Triyanpal/HYROE/Images/Development/pressure_testing.png

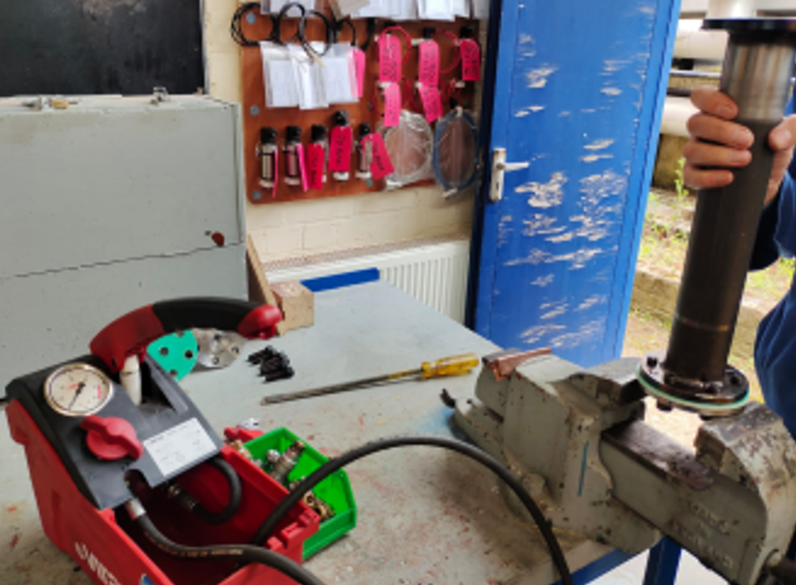
Images/Development/pressure_testing.png
