Triyanpal/HYROE/Images/Testing/Picture11.png

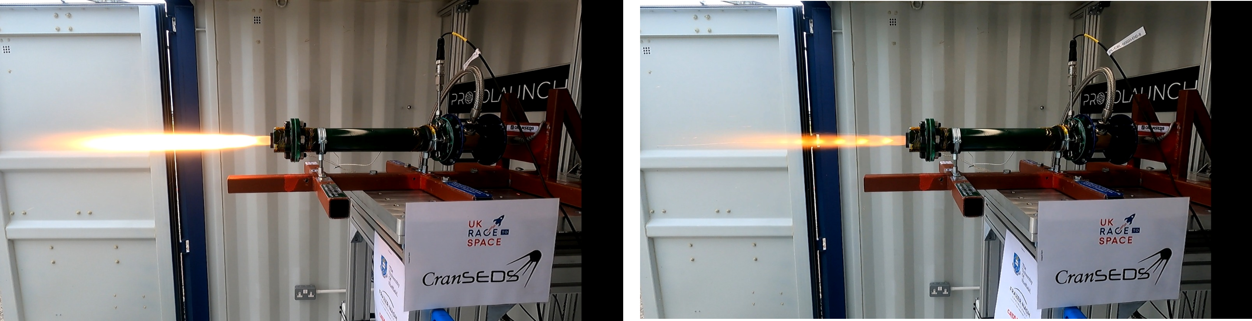
Images/Testing/Picture11.png
