Triyanpal/HYROE/README.md

# HYROE
Hybrid rocket engine research repository

Author: Triyan Pal Arora

Team: CranSEDS HRMTS, Cranfield

The current repository contains simulations, designs, development and results files for the research work undertaken under the Race to Space UK hybrid rocket engine development national engineering competition.

The folders are subdivided into separate segments for ease of navigation.

Please do refer to the conference paper published on the research and findings from the project here: 

Drop a message if any clarifications are required.
Thanks, and KR.
