Triyanpal/HYROE/Documentation/CRANSEDS HYBRID ENGINE DOCUMENTATION.pdf

## CRANSEDS HYBRID ENGINE DOCUMENTATION

### 30 JUNE 2023

### 1. Structure

Test structure of last year - Inspected for cracks or failure points - none detected.

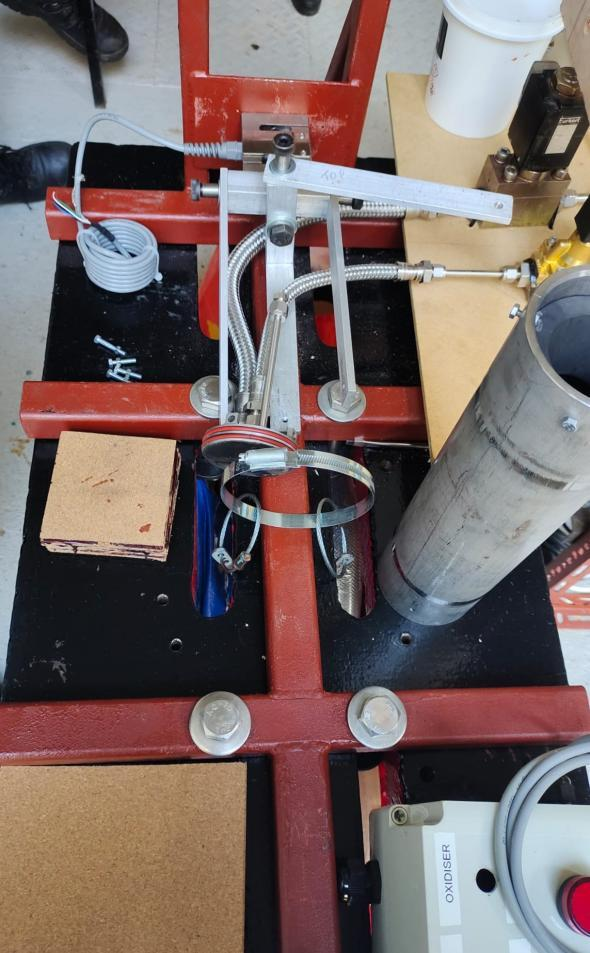
[picture p3: figure]

Initially assembled structure

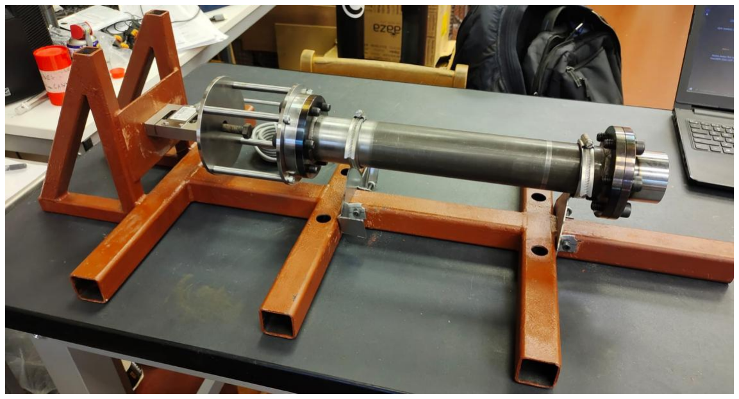
[picture p4: figure]

Materials:
Components (already procured, manufactured, and assembled in structure) | Material
Test Stand base | Mild Steel
Thruster assembly back plate | Mild Steel
Thruster assembly front plate | Mild Steel
Thruster assembly connector | Mild Steel
Injector plate | Mild Steel
Injector flange | Mild Steel
Side flanges | Mild Steel
Combustion chamber | Mild Steel
Nozzle casing | Mild Steel
C-D Nozzle | Graphite
Support fixtures | Zinc plated steel
Bolts | Steel Grade A2 and Grade M8.8
Radial and Axial O rings | Nitrile
Gasket sheet | Aramid fibers, bonded with NBR
Fuel Insulation liner | High density cork liner
Resin and hardener for liner | Aerodux 185 resorcinol phenol liquid resin and HRP155 hardener
Ignition wire | Nichrome wire AWG 28

Metal and plastic machining of structural components performed by manufacturing shop of test facility, Cranfield University, every part and engineering drawing supervised by David Thompson. Attachments:

a. Mild Steel certification sheet
b. Graphite data sheet
c. Ring clamp certification sheet
d. Gasket certifications
e. O rings data sheet
f. Cork liner data sheet
g. Liner resin and hardener data sheet

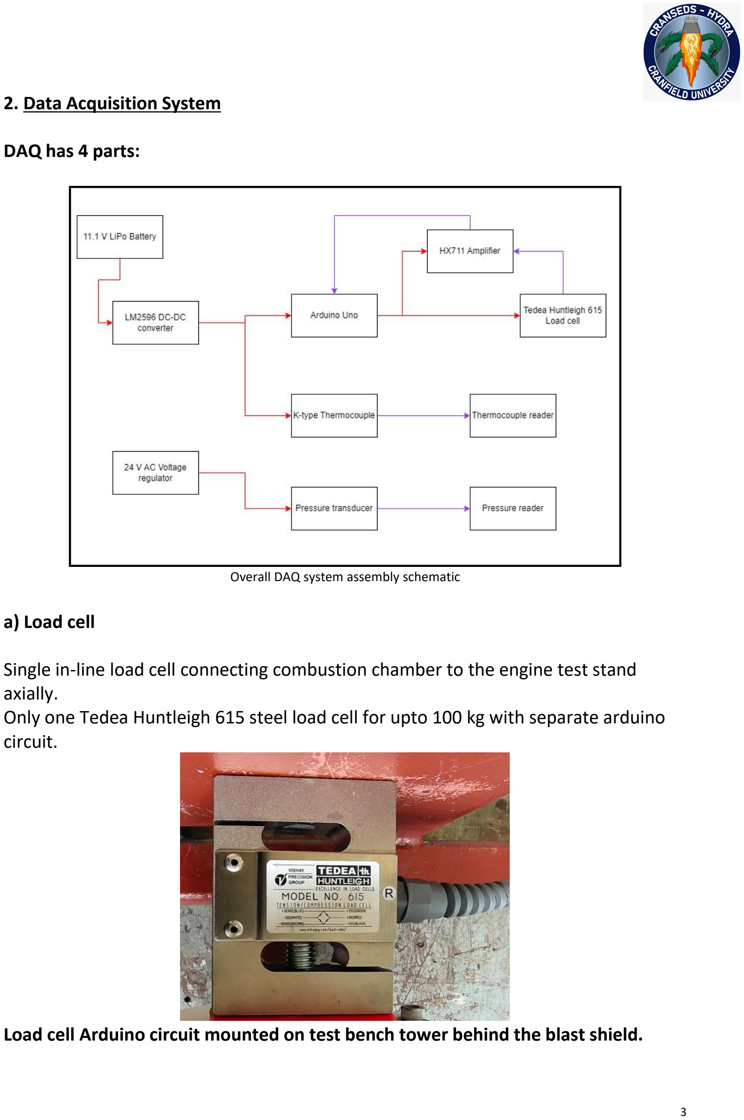
[picture p5: page 3]

### 2. Data Acquisition System

DAQ has 4 parts:

Overall DAQ system assembly schematic
a) Load cell

Single in-line load cell connecting combustion chamber to the engine test stand axially. Only one Tedea Huntleigh 615 steel load cell for upto 100 kg with separate arduino

circuit.

Load cell Arduino circuit mounted on test bench tower behind the blast shield.

b) Thermocouples
Five K-type thermocouples used (3 on combustion chamber, 2 on nozzle casing). Connected with heat measurement units at the test facility.

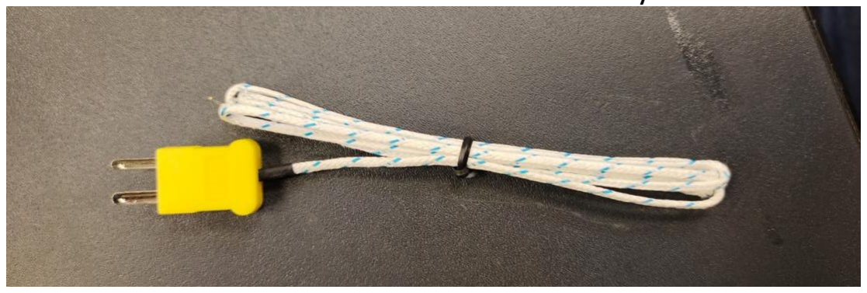
[picture p6: figure]

RS 206-3722 thermocouple reader will be used at least 3 m apart from the engine test bench. c) Pressure transducer

Pressure transducer PX119 1.5 KGI used (8-32 V, 4-20 mA), 2 pin configuration (will be tested today (30 Jue 2023)). Connected with NI LabView adapter for measurement of the results. Pressure transducer is measuring the internal combustion chamber pressure. The

cross section of the chamber for connecting the transducer is depcited in the figure below

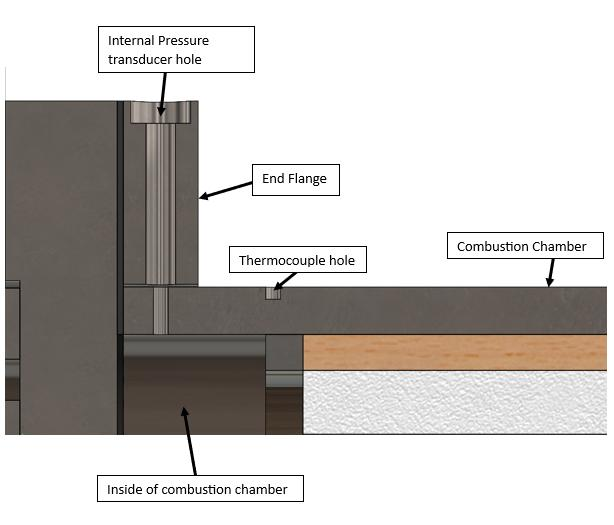
[picture p7: figure]

Pressure transducer logger will be at least 3 m away from the engine test bench.

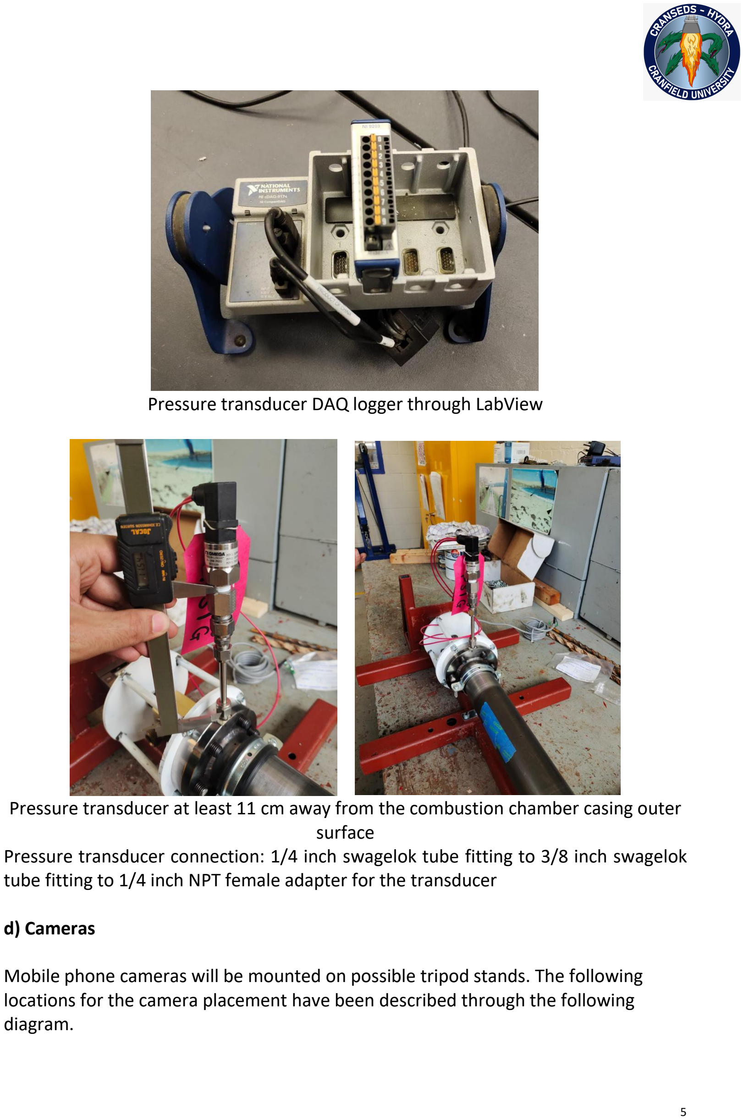
[picture p8: page 5]

Pressure transducer DAQ logger through LabView

Pressure transducer at least 11 cm away from the combustion chamber casing outer surface
Pressure transducer connection: 1/4 inch swagelok tube fitting to 3/8 inch swagelok tube fitting to 1/4 inch NPT female adapter for the transducer
d) Cameras

Mobile phone cameras will be mounted on possible tripod stands. The following locations for the camera placement have been described through the following diagram.

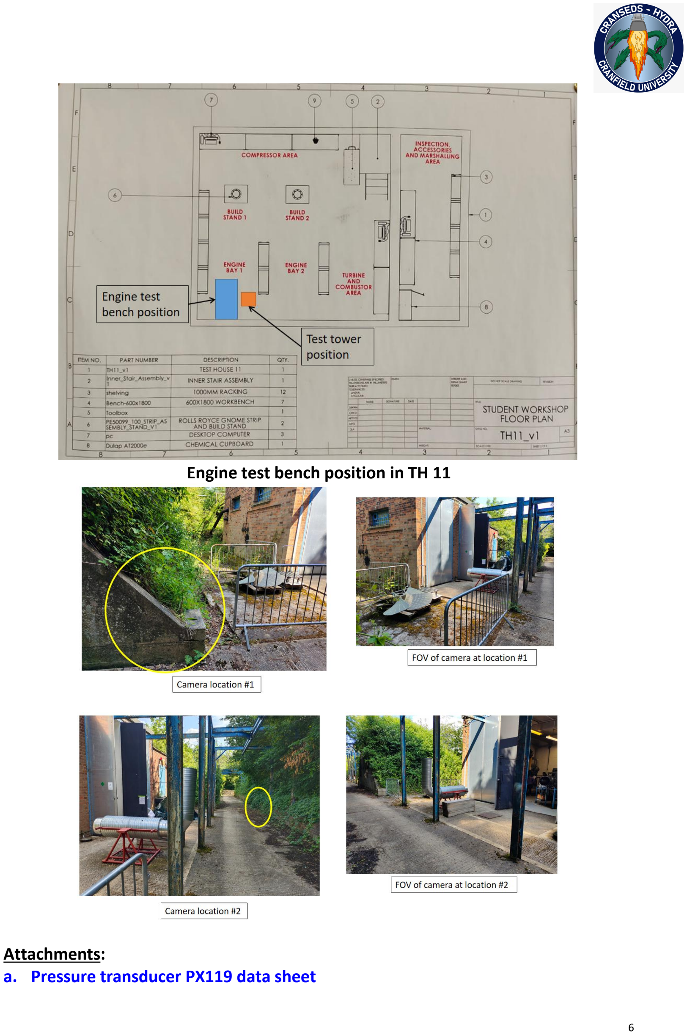
[picture p9: page 6]

Engine test bench position in TH 11

Attachments:
a. Pressure transducer PX119 data sheet b. Tedea huntleigh load cell data sheet
c. NI compact DAQ-9174 for pressure transducer
d. RS 206-3722 Thermocouple reader

### 3. Control Box System

Assembled and created by Kevin (test facility staff)

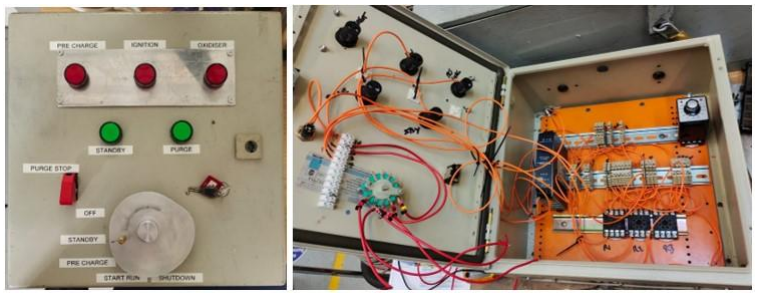
[picture p10: figure]

Control box for the hybrid engine hot test firing

All components employed were selected and assembled by the test facility staff with the available components as follows:
Component Name | Specs | Image
RS relay socket | RS 403-235

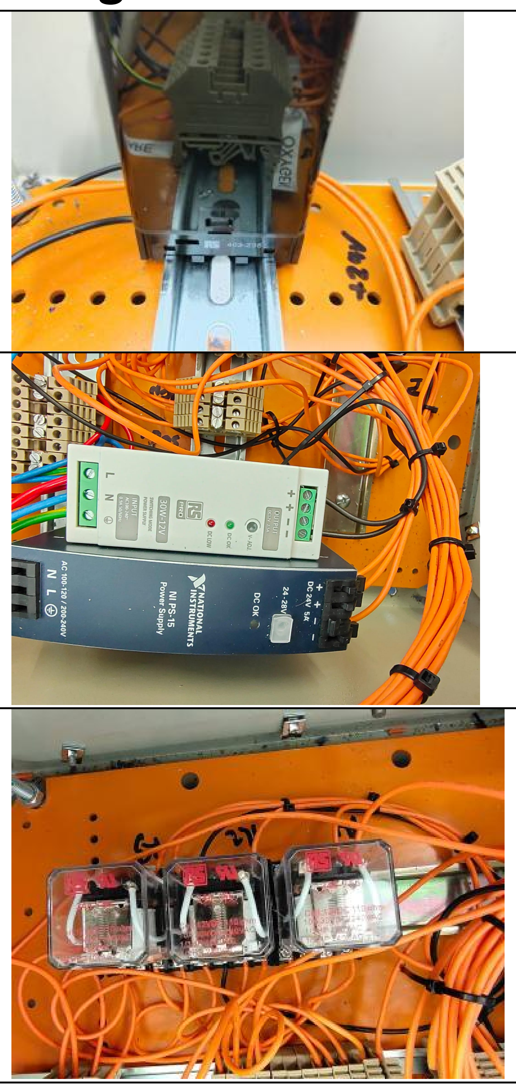
[picture p11: figure]

RS Pro Power Supply | 30 W - 12 V
National Instruments Power supply | NI PS-15, 100-200 / 200- 240 V
Plug in power relay | RS 348-756, 10 A switching current DPDT

Insulated mode interface
switches
- 5- Mode pin switcher | - Tempatron temperature
controller | 110-240 V AC supply voltage

Relay buses and connectors

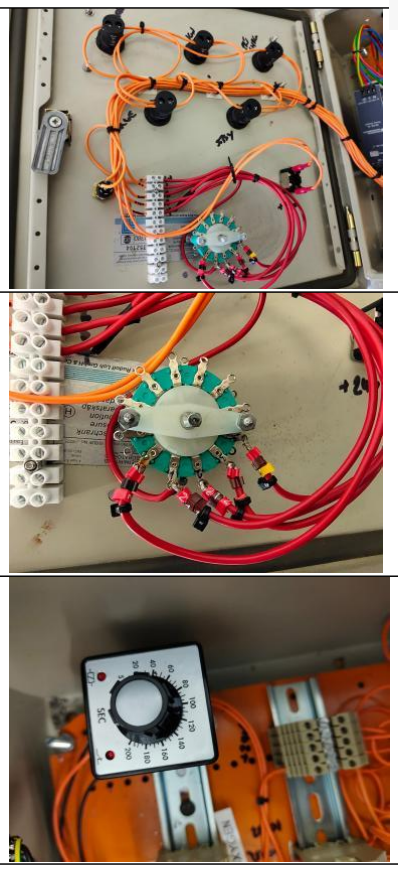
[picture p12: figure]

Colour coded | - Control box and test bench electrical interface used is 5-pin A-coded M12 socket

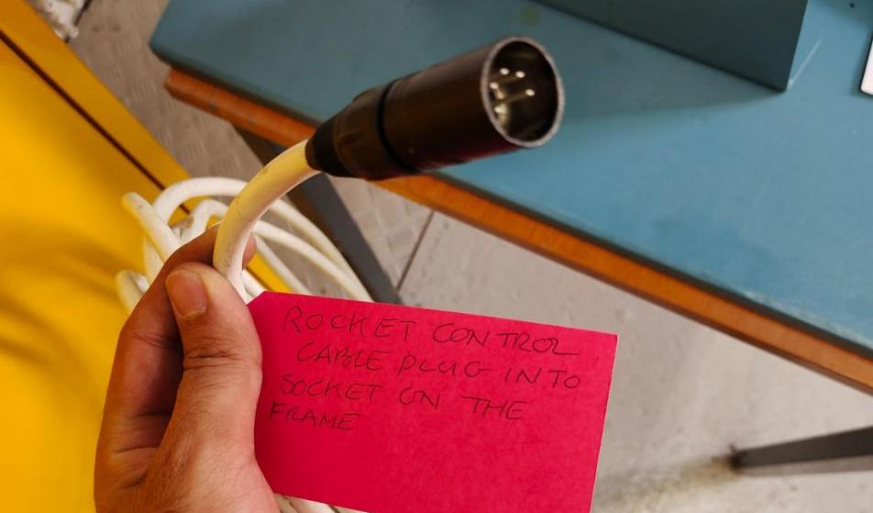
[picture p13: figure]

connector.

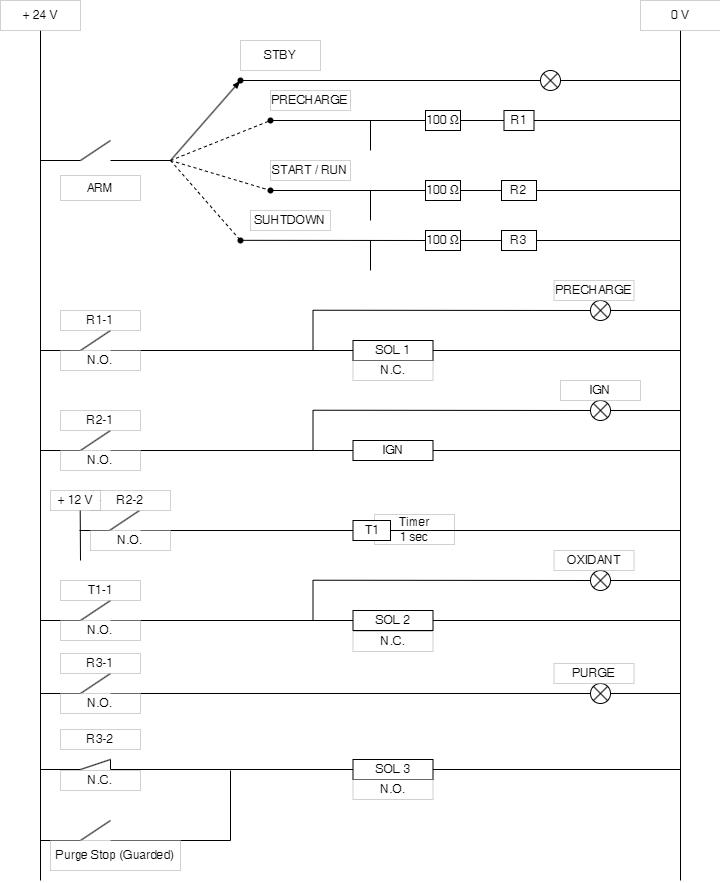
[picture p14: figure]

Control box schematics diagram

### 4. Feed Line System

Pipes : in attachments. Feed line to the combustion chamber:

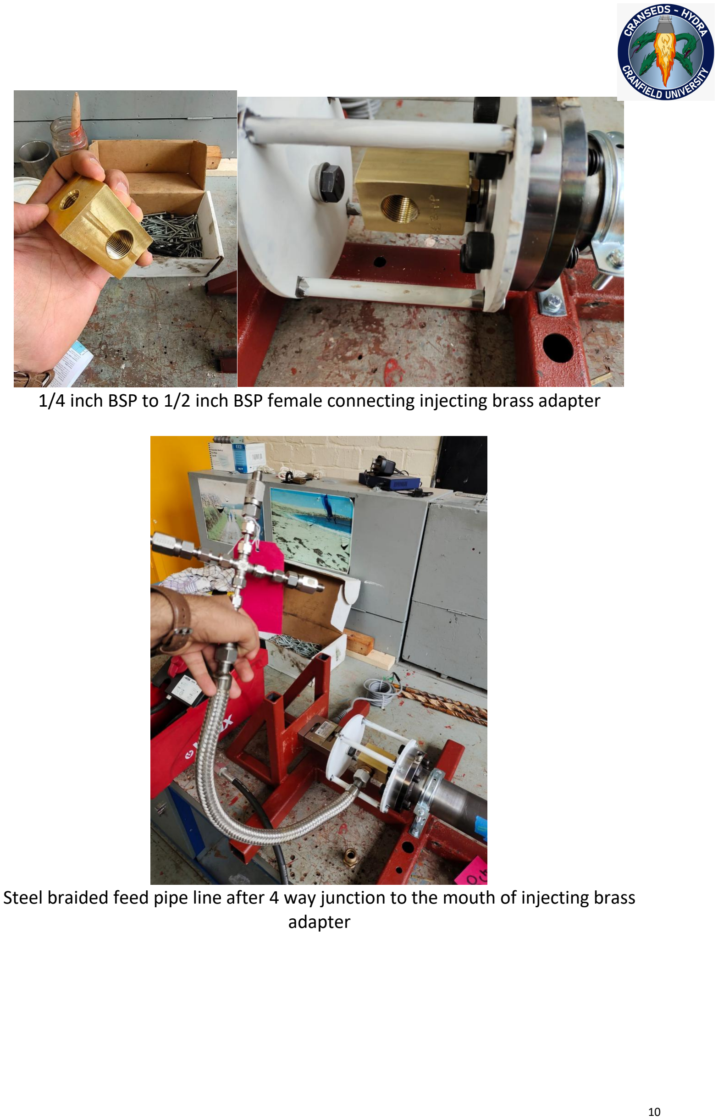
[picture p15: page 10]

1/4 inch BSP to 1/2 inch BSP female connecting injecting brass adapter

Steel braided feed pipe line after 4 way junction to the mouth of injecting brass adapter

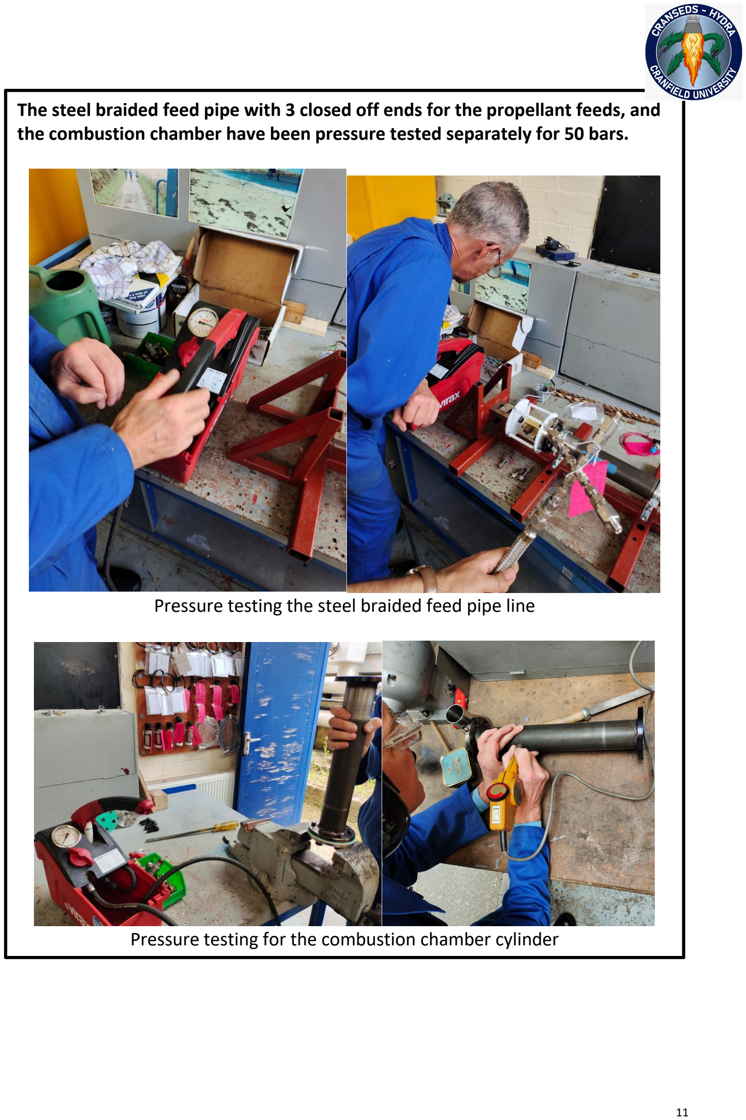
[picture p16: page 11]

The steel braided feed pipe with 3 closed off ends for the propellant feeds, and the combustion chamber have been pressure tested separately for 50 bars.

Pressure testing the steel braided feed pipe line

Pressure testing for the combustion chamber cylinder

Valves:
Component Name | Type | Quantity | Image
1/4 NPT Good BSI Max 316 SS Valve | Stop Valve | 1

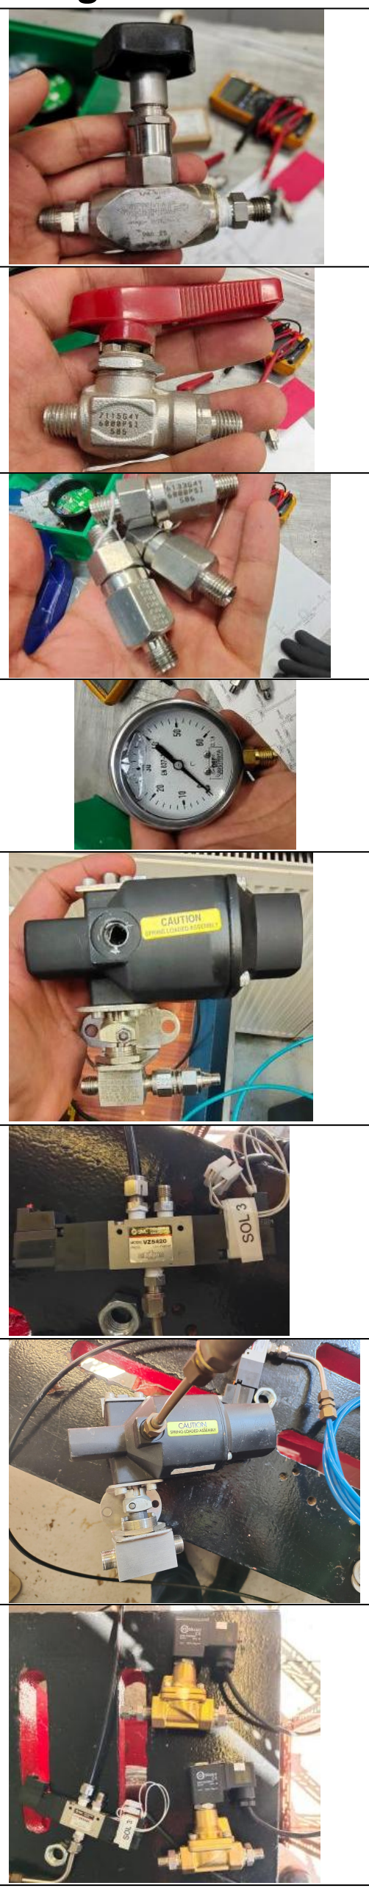
[picture p17: figure]

7115G4Y 316 stainless 6000 psi valve | Stop Valve | 1
6133G4Y 6000 psi swagelok tube fitting check valve | Check Valve | 3
EN 837-1 dial | Regulator Dial | 2
Swagelok SS-43S4- 31C valve | Pressure actuated valve | 1
solenoid valve VZ5420 | 5 port Solenoid valve | 1
Swagelok ss-45S8 valve | Pressure actuated valve | 1
shako sd91330DQSNT PU225S | Solenoid Coil valve | 2

Attachments:
a. 3/8 inch swagelok pipe datasheet

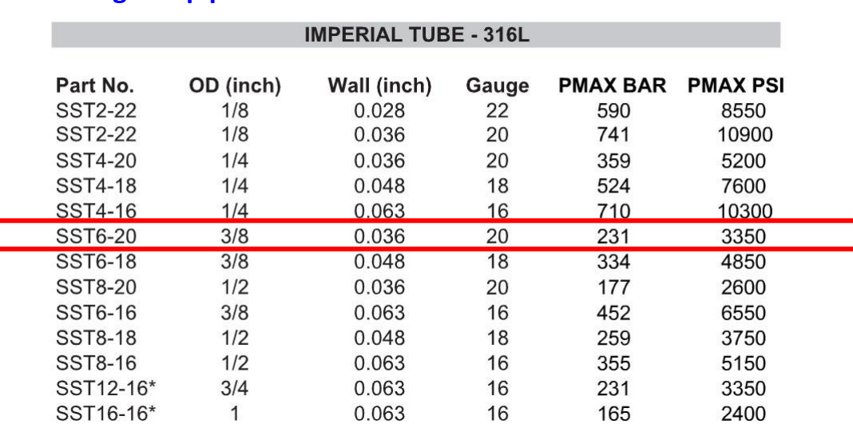
[picture p18: figure]

b. Feed line schematic
c. Stop valve data sheet
d. Check valve data sheet
e. Regulator dial data sheet
f. Pressure actuated valves data sheet
g. 5 port solenoid valve data sheet
h. Solenoid coil valve data sheet

### 5. Risk and COSHH Assessment

Attachments:
a. Risk assessment
b. COSHH assessment for N2O

### 6. Propulsion

Propellant used:
Propellant | Quantity | Purpose | Pressure for the current design | Status
HDPE | 0.91 kg | Solid fuel | - | Procured by team already
N2O | 1.1 liter | Liquid Oxidiser | 44.5 bars | To be purchased
O2 | 0.5 liter | Low pressure Precharger | 40.5 bars | Already outside test house 11
N2 | 3 liter | High pressure purger gas | 50 bars | Already outside test house 11

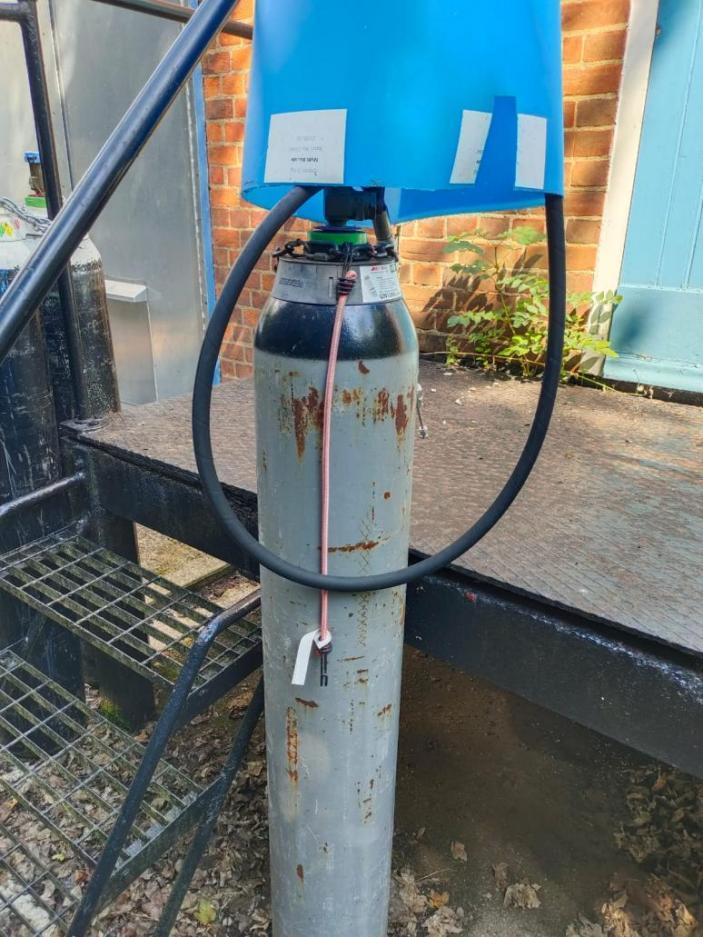
[picture p19: figure]
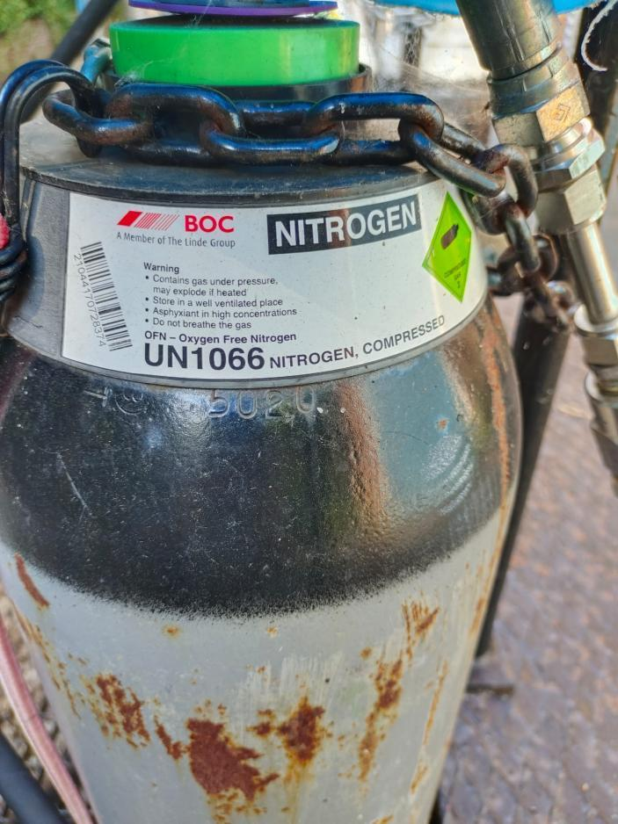
[picture p20: figure]

Nitrogen tank outside TH 11

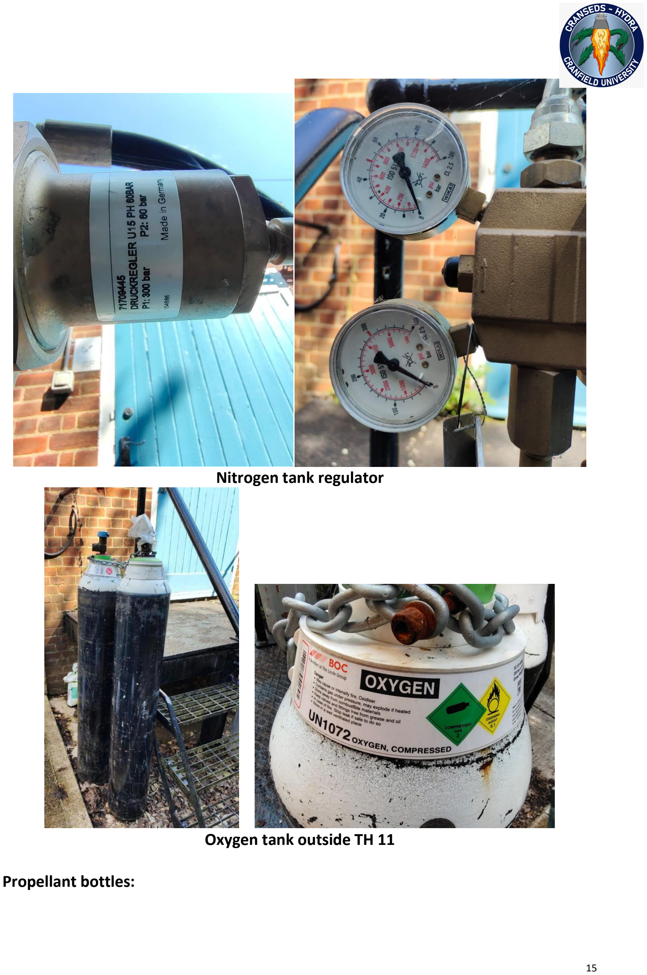
[picture p21: page 15]

Nitrogen tank regulator

Oxygen tank outside TH 11

Propellant bottles:

Propellant | Bottle Name | Bottle size | Purpose | Status
Nitrogen | Nitrogen gas tank | Type W | Purge gas | Outside TH 11
Oxygen | LOH tank | Type W | Precharge gas | Outside TH 11
Nitrous Oxide | BOC oxidiser tank | Type W / 10 liter | Oxidiser gas to be bough from BOC | To be bought (still no quote for 10 liter N2O)
Nitrous Oxide | Luxfer run tank | 10 liter | Run tank (sits between BOC oxidiser tank and engine) | Procured by team (currently in TH 11)

Attachments:
a. Time calculation
b. Temperature calculation
c. N2O data sheet
d. Luxfer tank spec sheet

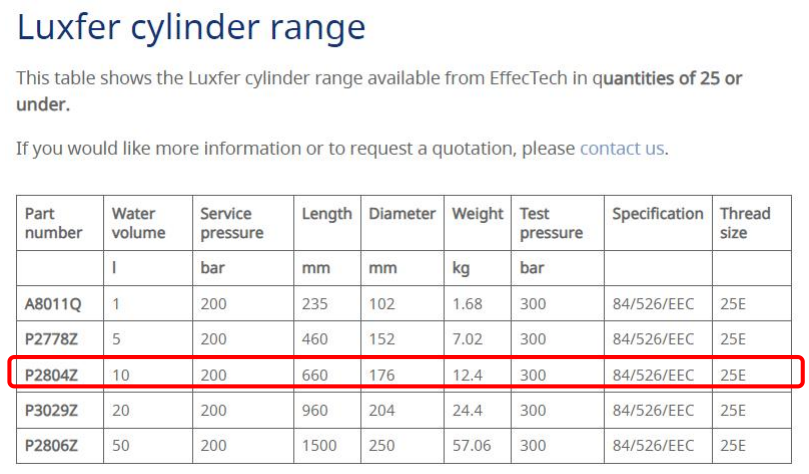
[picture p22: figure]

e. Luxfer tank adapter data sheet

### 7. Safety:

a) PPE kit
i. Safety boots (owned by team)
ii. Safety glasses (owned by team)
iii. Head covers (up to 35 dB - the ones employed in the whole test facility) iv. Full length clothing
v. No synthetic cloth
vi. Lab overcoat
b) Fire Extinguisher

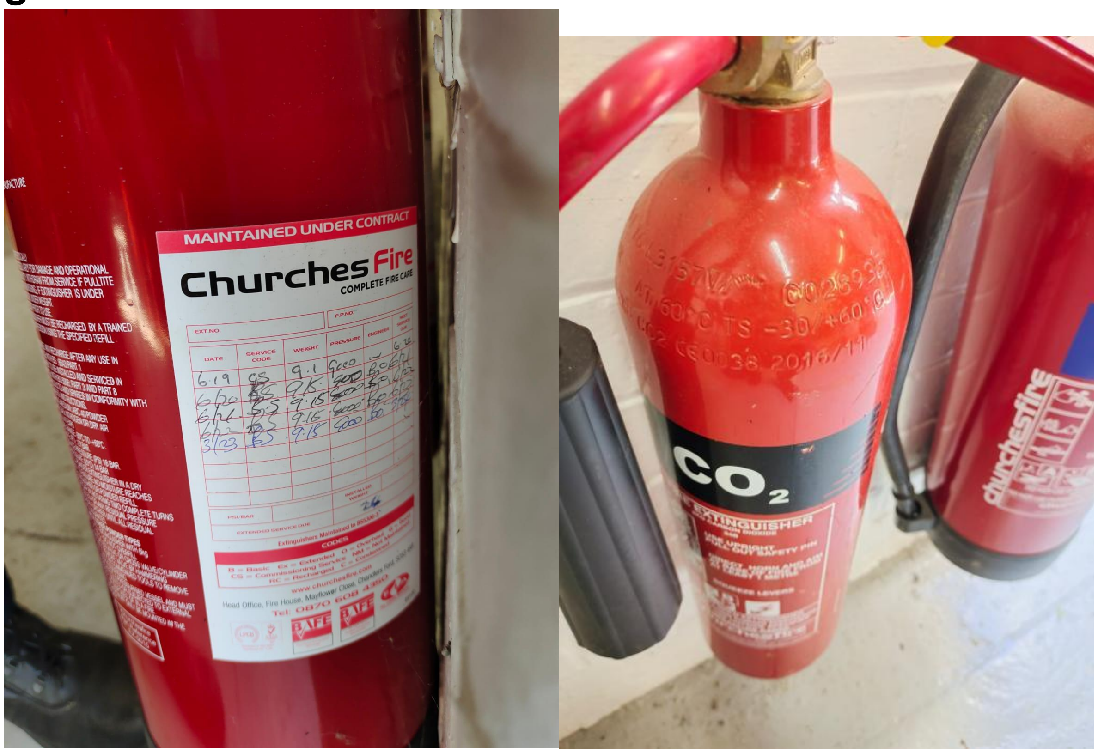
[picture p23: figure]

Last service in March 2023 with maintenance interval of approx. 1 year

c) Gas leakage lights (need to check)
d) Emergency Alarm (need to check)
e) Plume catcher
Will be put closer to the engine on a leveled ground, with 2 sandbags on each of the 4 corners.

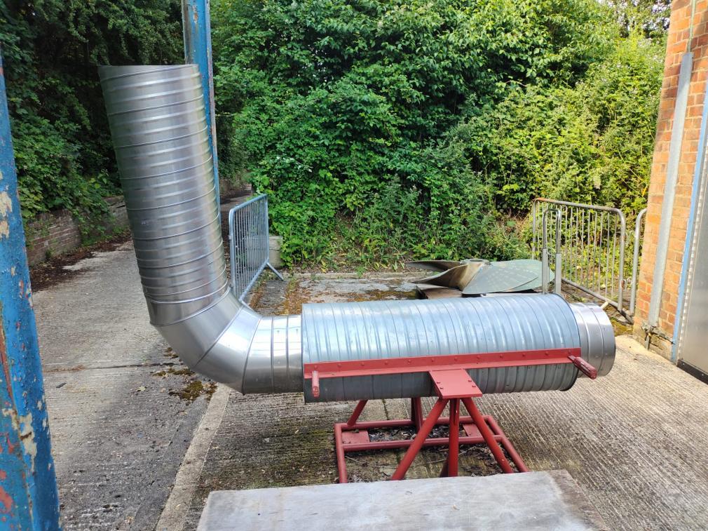
[picture p24: figure]
