Triyanpal/HYROE/Documentation/EASN_presentation_v2.1.pdf

## Designing and testing of an HDPE-N2O hybrid propulsion engine

# 14th EASN International Conference 8-11 October 2024

Abstract
- Hybrid propellant engines use both solid (HDPE fuel) and liquid (N2O liquid) propellants for better thrust control and simplicity.
- Study focuses on the impact of combustion chamber length on engine performance.
- Engine features include an L-shaped mount, spark ignition, and gaseous nitrogen purging.
- 2D axisymmetric CFD model with K-ε SST RANS used to simulate combustion reactions.
- Experimental results validate CFD exhaust outflow simulation, providing insights into thrust, temperature, and pressure distributions.

Authors
Triyan Pal Arora, Noah Buttrey, Peter Kirman, Sanmukh Hadtare, Eeshaan Kamath, Adriano Isoldi, Dario del Gatto Cranfield University, Bedford, United Kingdom

## Design & Methodology

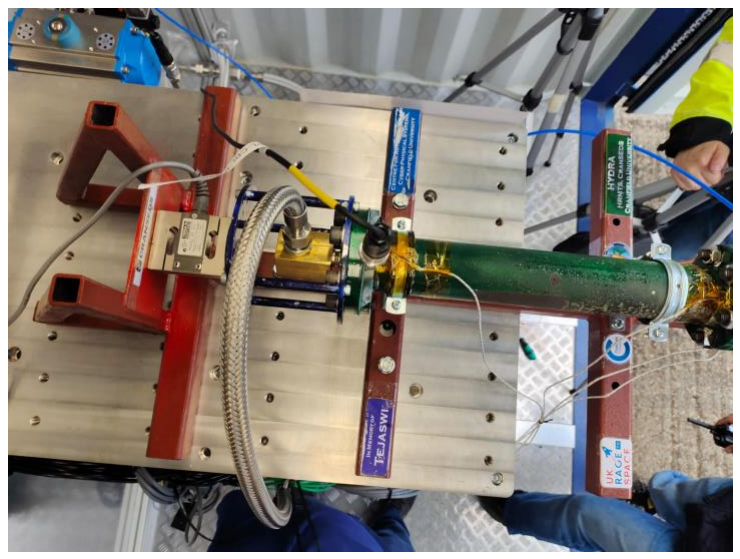
[picture p25: figure]
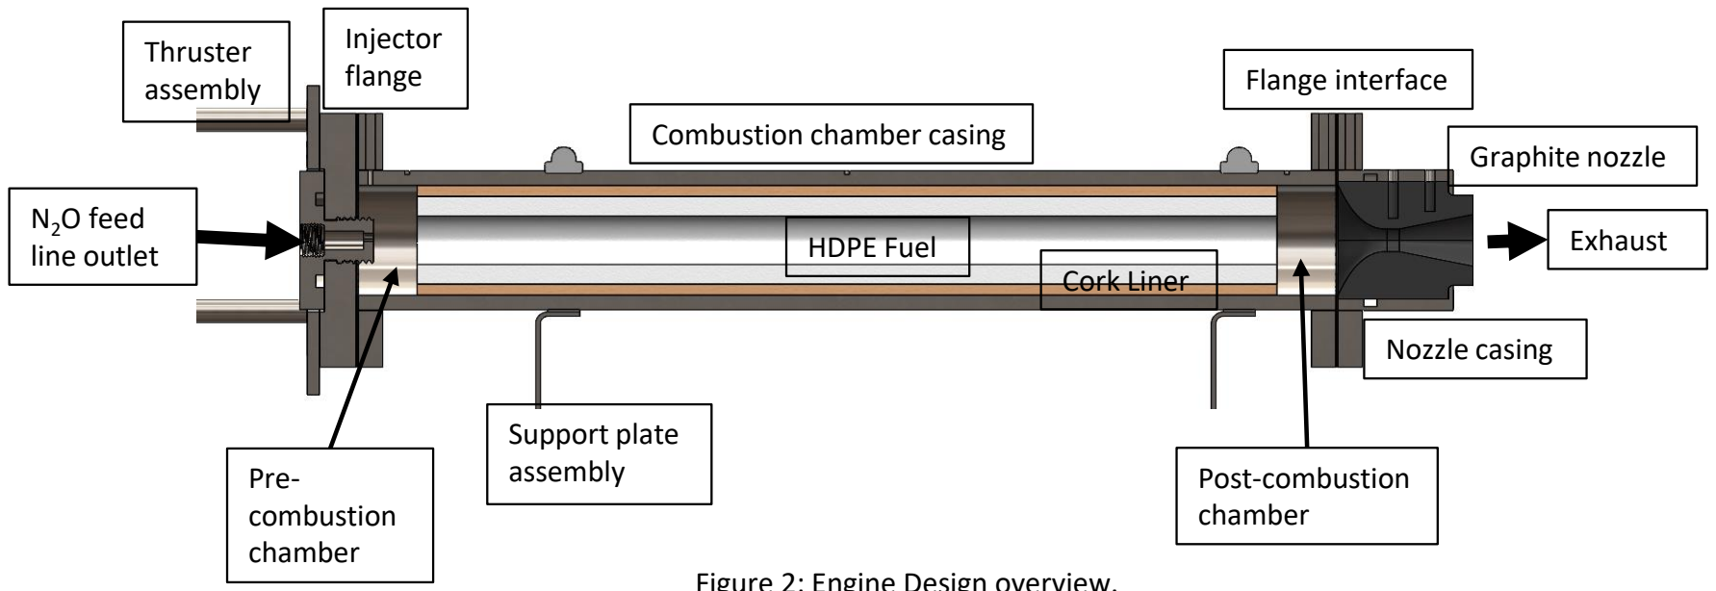
[picture p26: figure]
N2O feed line outlet; Thruster assembly; Injector flange; Combustion chamber casing; Support plate assembly; Exhaust; Flange interface; Nozzle casing; Graphite nozzle; HDPE Fuel; Cork Liner; Pre- combustion chamber; Post-combustion chamber

Figure 2: Engine Design overview.

Theoretical
development for
engine sizing &
performance

CFD simulations
for performance
estimation

Experimental
tests: Pressure
testing, Cold flow
testing

Hot Fire Testing

Figure 1: Finalised engine mounted on test stand
right before hot test firing

## Design & Methodology

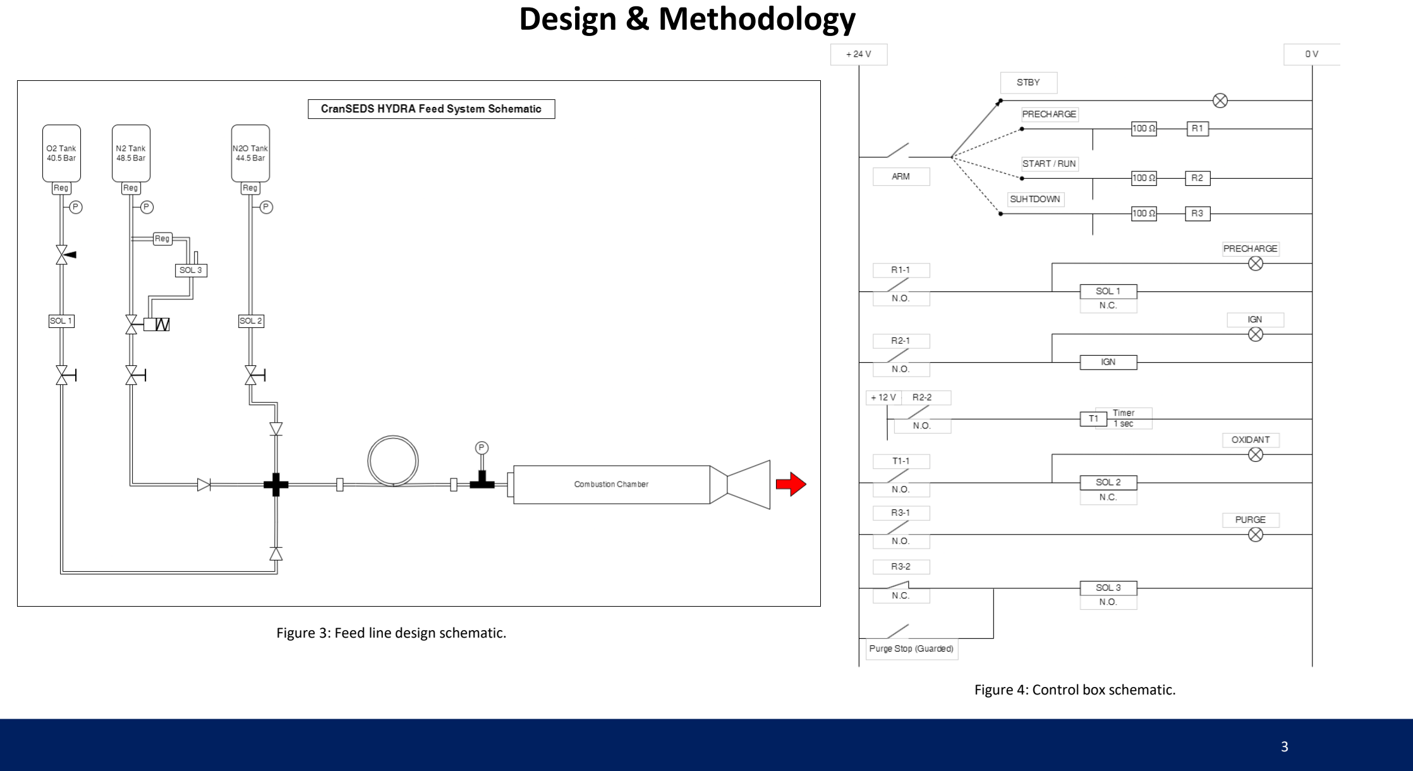
[picture p27: page 3]

Figure 4: Control box schematic.

Figure 3: Feed line design schematic.

## CFD Simulations

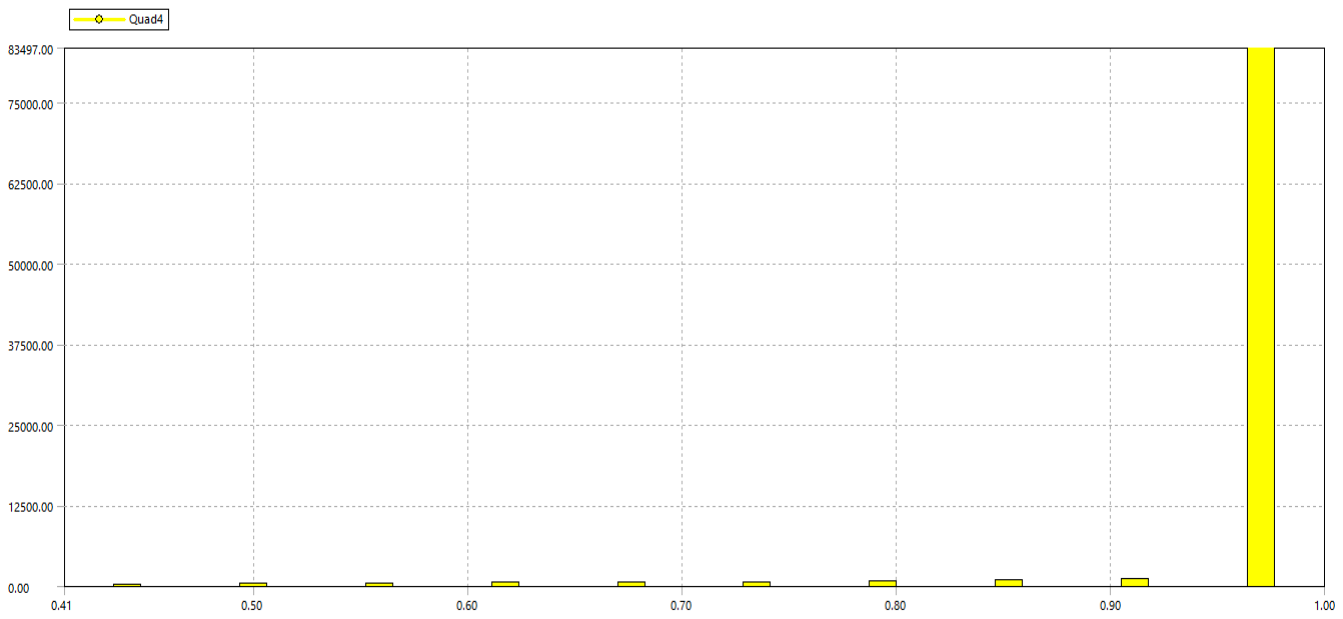
[picture p28: figure]

- Density based transient solver with a steady state asymmetric flow
- Energy model and standard k-ε viscous model
- Propellent used is N2O without species transport due to 2-D model of nozzle
- Pressure inlet = 335 kPa at 3375 K temperature, Pressure outlet = 101.325 kPa at 300K temperature and symmetry is considered as wall for boundary conditions.
- Coupled solution methods is used and the solution is initialised at the inlet.
- Solution through 5000 iterations and for pressure, velocity, density and temperature values and plots.
- The computational value of thrust varies from 327.3 N which is around 9.1% of the predicted value of 300N
- The mass flow rate is equal to 0.1765 kg/s which is around 7.88% of the predicted value (0.1636 N)
- The thrust is constant and then there is a sudden drop as we move along the length of the nozzle.

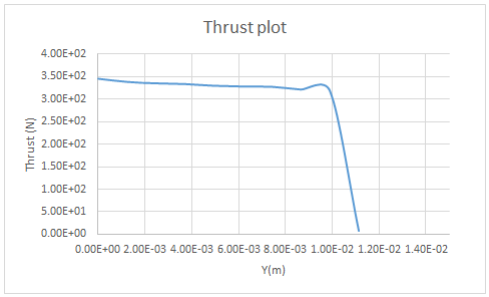
[picture p29: figure]

Figure 6: CFD simulation thrust plot results.

Figure 5: Quality metric of simulation mesh (Jacobian)

Element metrics

Number of elements

## Physical System Testing & Validation

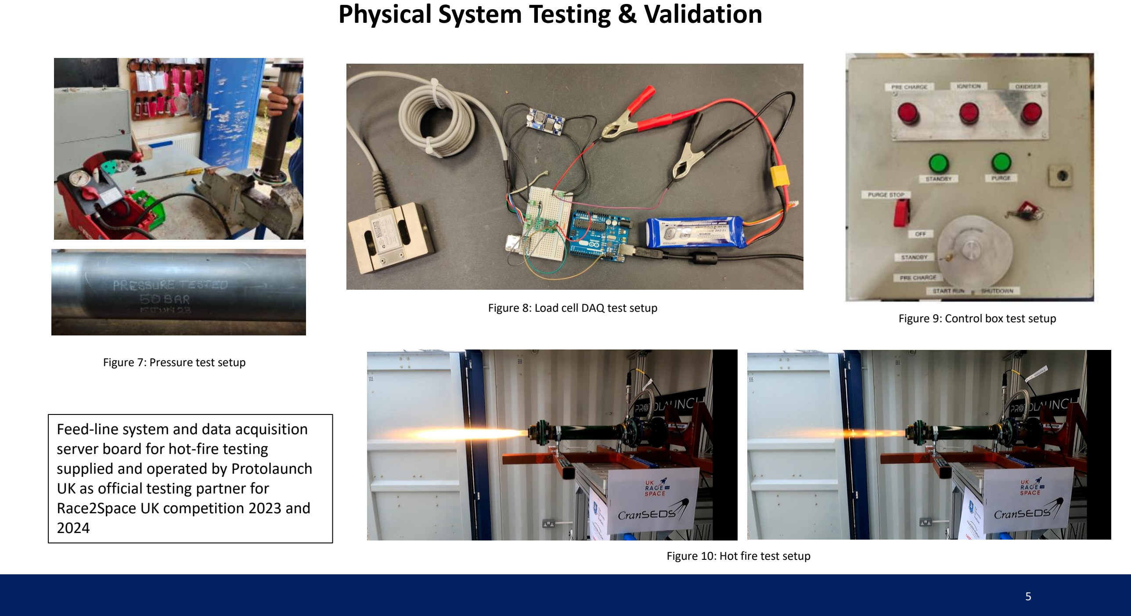
[picture p30: page 5]

Figure 7: Pressure test setup

Figure 10: Hot fire test setup

Feed-line system and data acquisition server board for hot-fire testing supplied and operated by Protolaunch UK as official testing partner for Race2Space UK competition 2023 and 2024

Figure 8: Load cell DAQ test setup Figure 9: Control box test setup

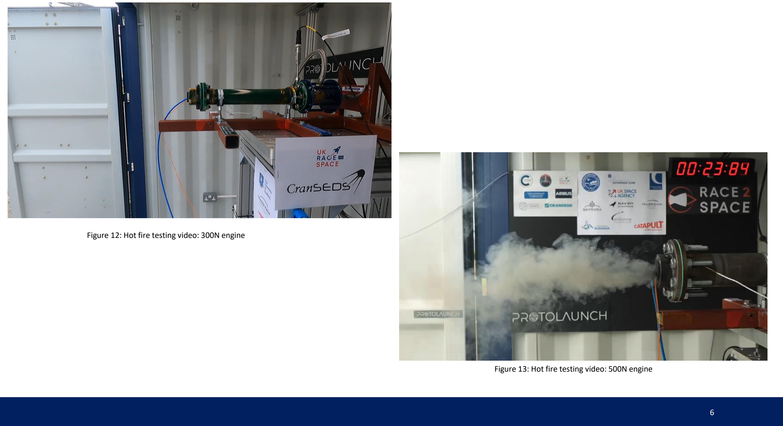
[picture p31: page 6]

Figure 13: Hot fire testing video: 500N engine

Figure 12: Hot fire testing video: 300N engine

## Results and Findings

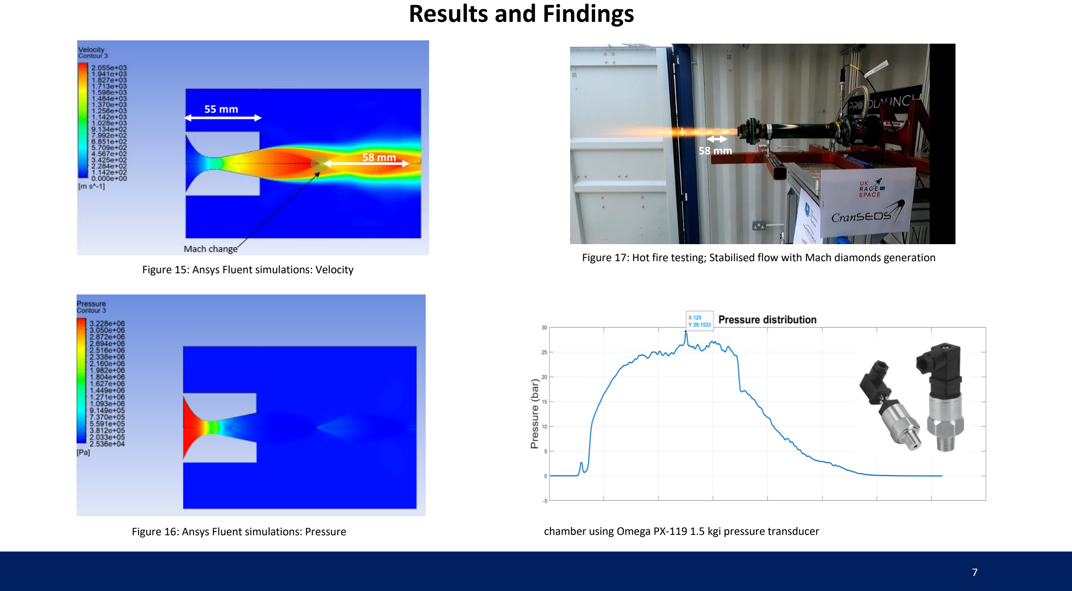
[picture p32: page 7]

Figure 15: Ansys Fluent simulations: Velocity

Figure 16: Ansys Fluent simulations: Pressure

Figure 17: Hot fire testing; Stabilised flow with Mach diamonds generation

Figure 18: Pressure distribution curve measured during hot-fire testing in the pre-combustion chamber using Omega PX-119 1.5 kgi pressure transducer

### 55 mm

58 mm | 58 mm

## Results and Conclusions

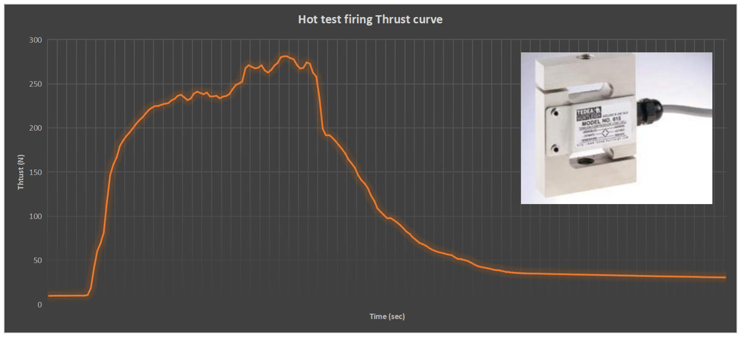
[picture p33: figure]

Performance Metrics:
Estimated pressure: 30.00 bars
Peak pressure estimate in simulations: 32.28 bars Peak pressure from test firing: 29.15 bars

Estimated thrust: 300.00 N
Peak thrust estimate in simulations: 327.3 N Peak thrust from test firing: 284.60 N

Figure 19: Thrust
curve measured
using Tedea Huntley
615 industrial grade
load cell

Estimated temperature: 3000 K
Peak temperature estimate in RPA simulations: 2940 K Peak temperature (exhaust thermocouple) from test firing: ~1446.4 K
- Effective designing approach for hybrid propellant based rocket engine.
- Requires further extensive development and screening for threshold dropout for the post combustion chamber length

### Thank you for your attention!

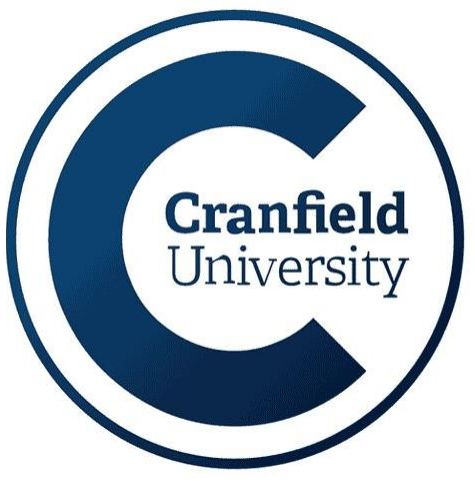
[picture p34: figure]

Contact:
Triyan Pal Arora
Corresponding Author, Project In-charge Researcher in Navigation Systems triyanpal.arora@cranfield.ac.uk
School of Aerospace, Transport and Manufacturing Cranfield University
Cranfield, Bedford, MK43 0AL,
Bedfordshire, United Kingdom www.cranfield.ac.uk

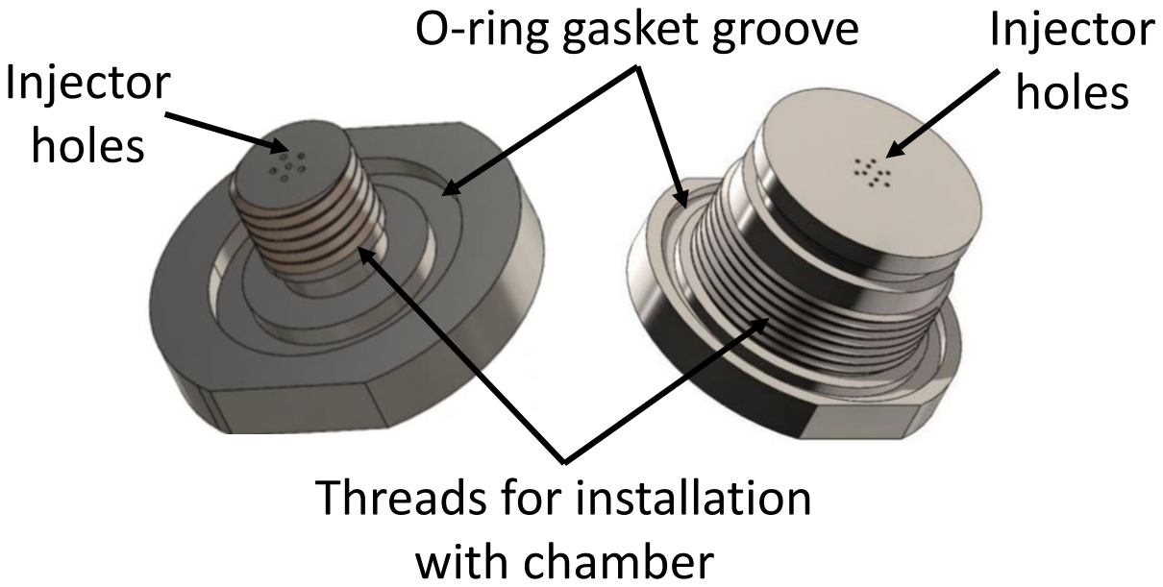
[picture p35: figure]
Injector holes Injector holes; Threads for installation with chamber; O-ring gasket groove

## Ground station computing platform

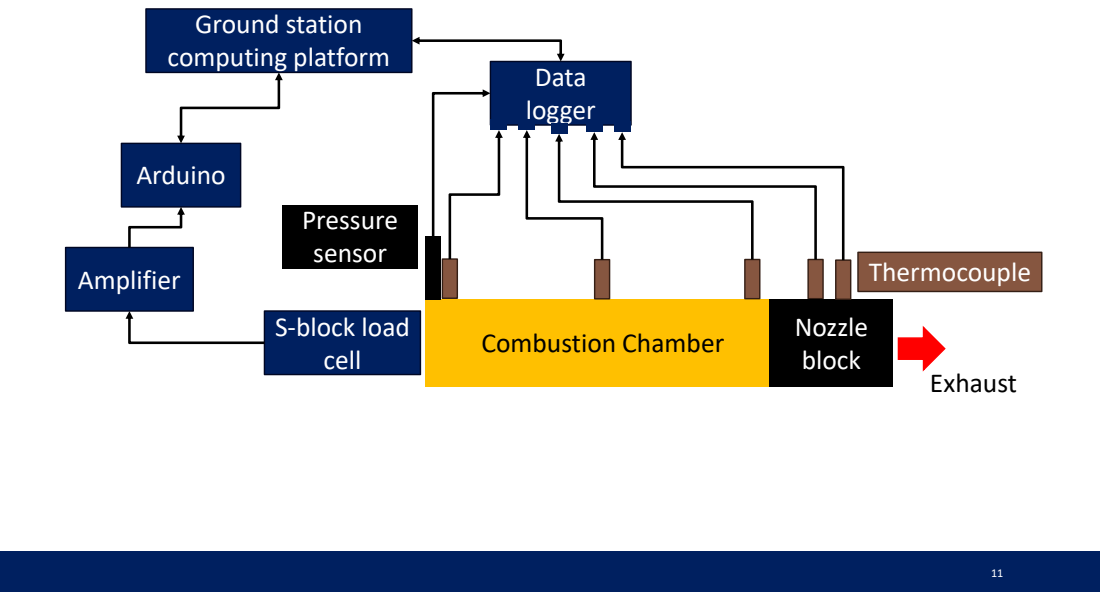
[picture p36: page 11]
S-block load cell; Pressure sensor; Thermocouple; Arduino; Combustion Chamber; Nozzle; block; Data logger; Exhaust; Amplifier
