Triyanpal/HYROE/Resources/R2S_CRANFIELD_HYDRA_HYBRID_7_7_23.pdf

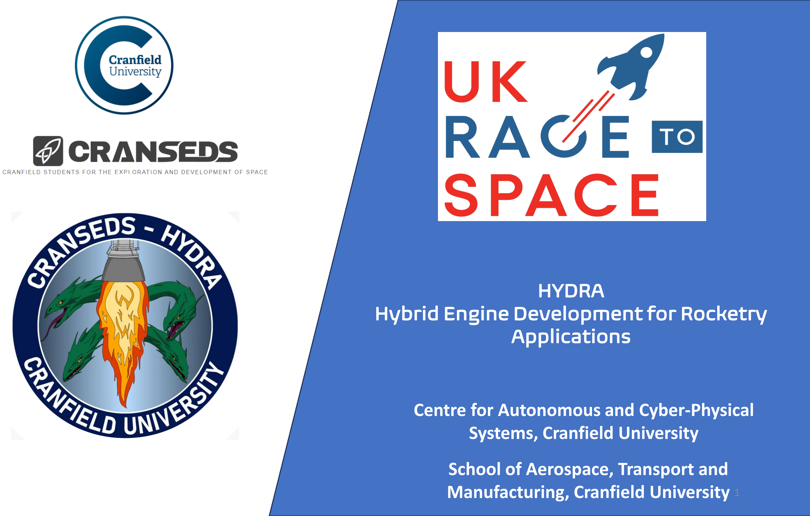
[picture p37: figure]
Systems, Cranfield University; HYDRA Hybrid Engine Development for Rocketry Applications; School of Aerospace, Transport and Manufacturing, Cranfield University 1

### Centre for Autonomous and Cyber-Physical

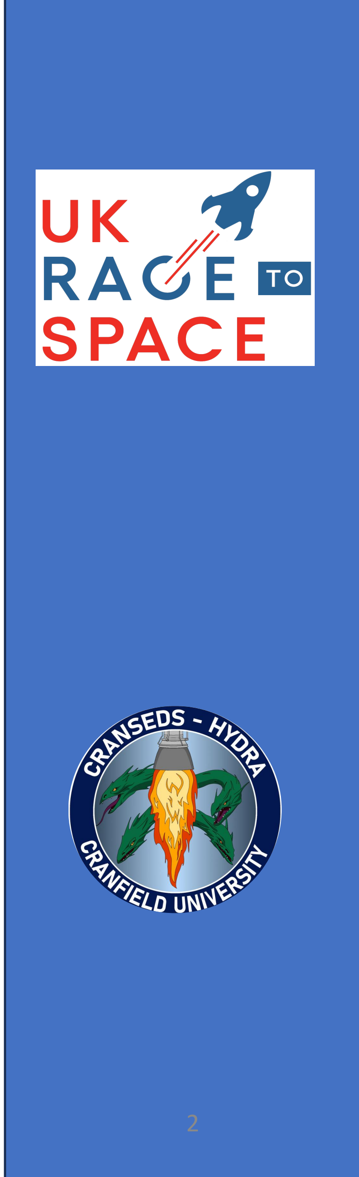
[picture p38: figure]

1. Team Management
1.1 Engine type
1.2 Sponsors
1.3 Team roster
2. Systems
2.1 Requirements and Compliance 2.2 Budgets
2.3 Gantt chart
3. Propulsion
3.1 Propellants
3.2 Engine design
3.3 Propulsion simulation
4. CFD
5. Structures
5.1 Structure design
5.2 Finite Element Analyses

# Index

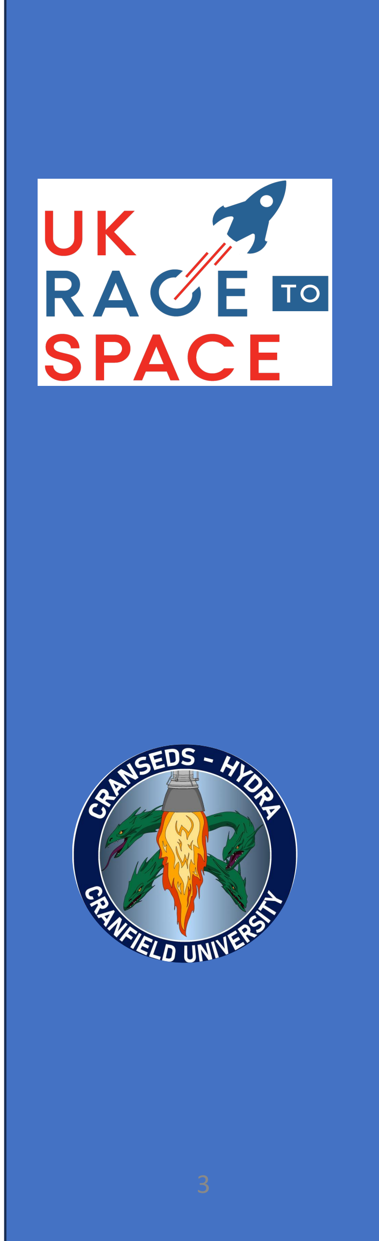
[picture p39: figure]

6. DAQ
6.1 Thrust: Load cell
6.2 Temperature: Thermocouple
6.3 Chamber Pressure: Pressure Transducer
7. Manufacturing
7.1 Combustion chamber
7.2 Test stand
7.3 Fuel block
8. Testing
8.1 Pressure testing
8.2 Cold flow testing
8.3 Hot fire testing
9. Conclusion
9.1 Lessons learnt
9.2 Knowledge transfer plan 9.3 Future works
10. Appendices

# Index

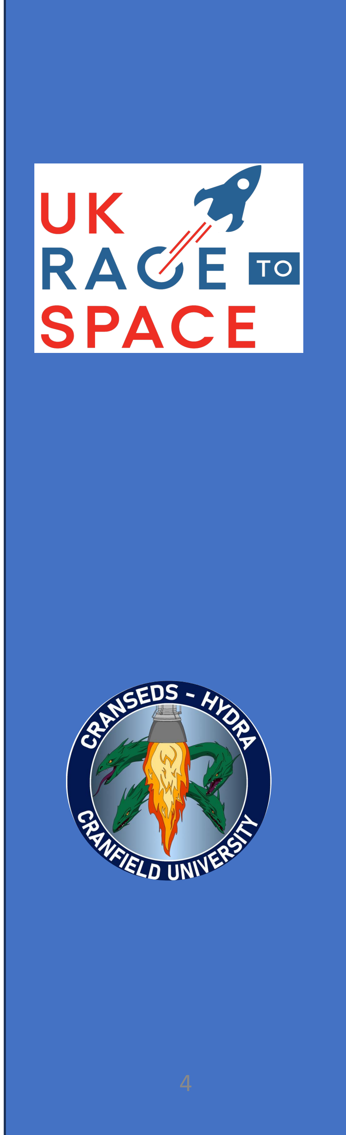
[picture p40: figure]

### 1. Team Management 1.1 Engine Type

Hybrid Engine
- building step towards liquid bi-propellant engine
- small scaled
- non-hazardous solid fuel
- only one liquid to control (easier than 2)
- best route to start the project with

### 1.2 Sponsors

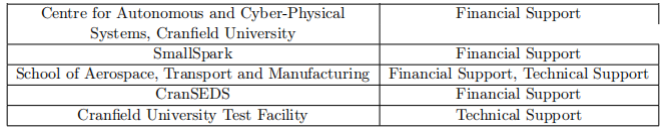
[picture p41: figure]

### 1.3 Team roster

TABLE 1: Table of Sponsors

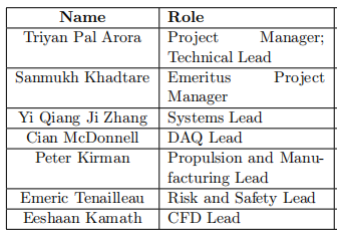
[picture p42: figure]

TABLE 2: Team Member roster

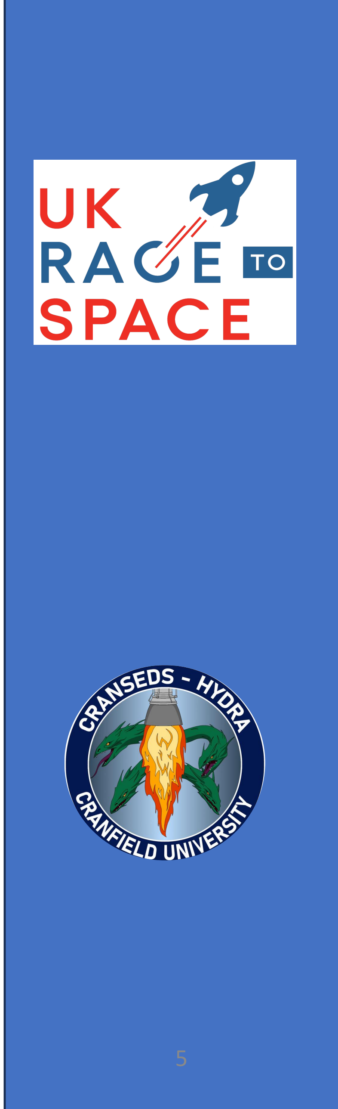
[picture p43: figure]

### 2. Systems 2.1 Requirements and Compliance

Req. ID | Parameter | Requirements | Traceability | Compliance
HY-1001 | Thrust | The Engine shall be designed to deliver a thrust of 300 N | | Not compliant
HY-1002 | Burn Time | The burn time shall be greater than 5 seconds | AEL-J1 Nitrous oxide test-rig ICD | Compliant
HY-1003 | Propellants | The liquid propellants used shall be Nitrous Oxide or IPA | | Compliant
HY-1004 | Ignition system | The engine shall be ignited using an external fuse wire to create sparks in the combustion chamber | AEL-J1 Nitrous oxide test-rig ICD | Compliant
HY-1005 | Mass flow rate | The mass flow rate of propellants shall be lower than 2.3 kg/sec (Nitrous Oxide), 0.5 kg/sec (IPA) | AEL-J1 Nitrous oxide test-rig ICD | Compliant
HY-1006 | Feed pressure | The feed line shall be able to hold pressures up to 80 bars. | | Compliant
HY-1007 | Chamber pressure | The chamber pressure for the complete fire sequence shall be lower than 51 bars (Nitrous Oxide Vapor Pressure) | | Compliant
HY-1008 | Mounting bracket | The mounting bracket shall provide support in all 3 axes from the experienced loads | | Compliant

TABLE 3: Table of Requirements

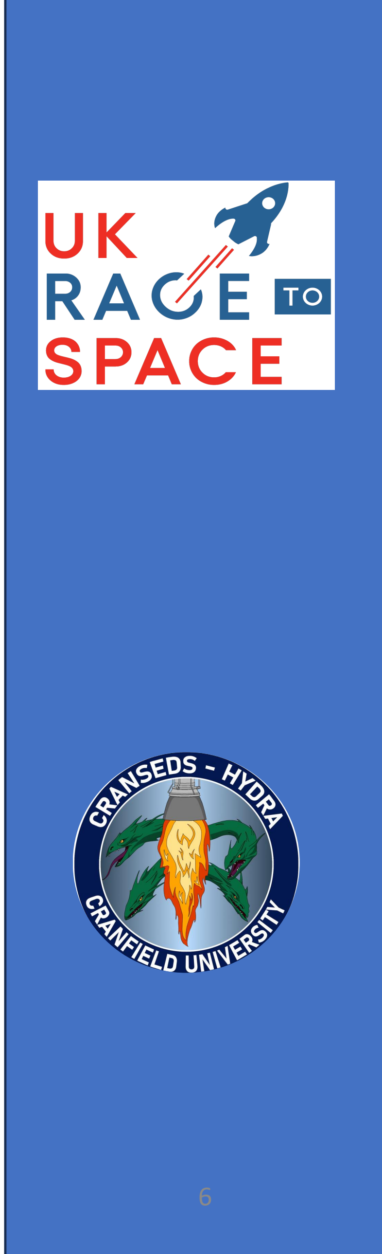
[picture p44: figure]

### 2. Systems 2.2 Project Budgets

Propellant | Purpose | Volume used | Required minimal storage pressure
Nitrous oxide | Liquid oxidizer | 1.20 litres | 44.50 bars
High density Polyethylene | Solid fuel | 0.12 kg | 0.98 bars
Oxygen gas | Pre-charge gas | 0.60 litres | 40.00 bars
Nitrogen | Purge gas | 5.50 litres | 50.00 bars
Sub-assemblies | Mass (kg) | Cost (£)
Test stand | 10.01 | 143.20
Combustion chamber | 13.36 | 2850.71
Fuel block | 0.14 | 45.80
Data acquisition system | 0.90 | -
TOTAL | 24.41 | 3039.71

TABLE 4: Propellant Budget. SOURCE: Own

TABLE 5: Mass and Cost Budget. SOURCE: Own

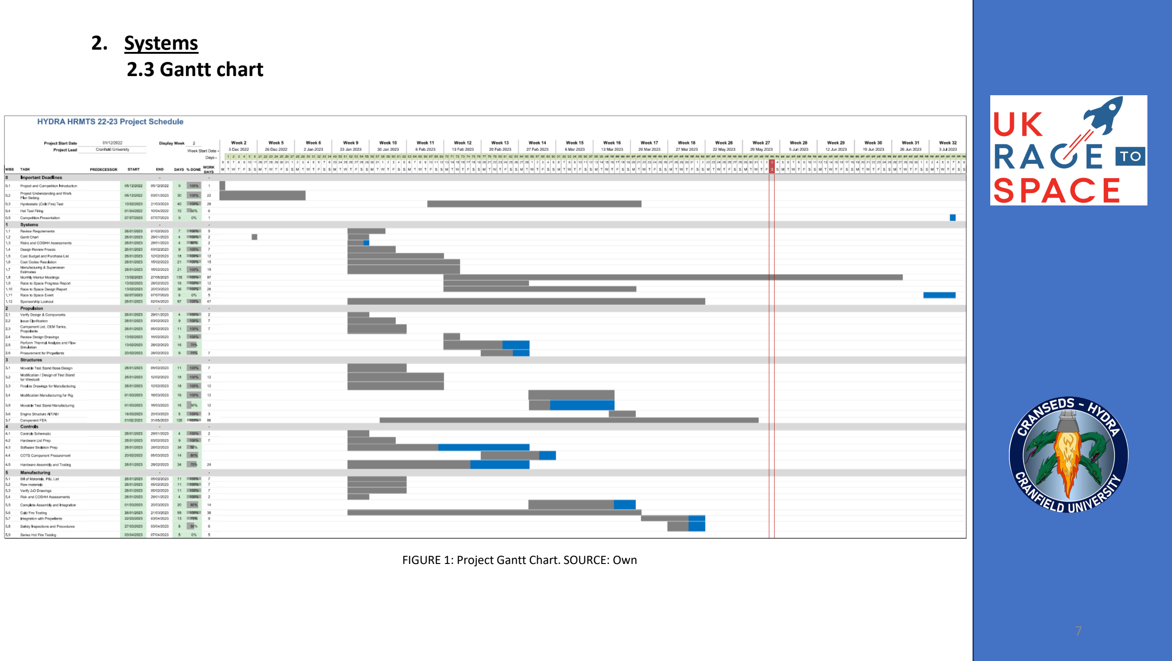
[picture p45: figure]
2. Systems 2.3 Gantt chart

FIGURE 1: Project Gantt Chart. SOURCE: Own

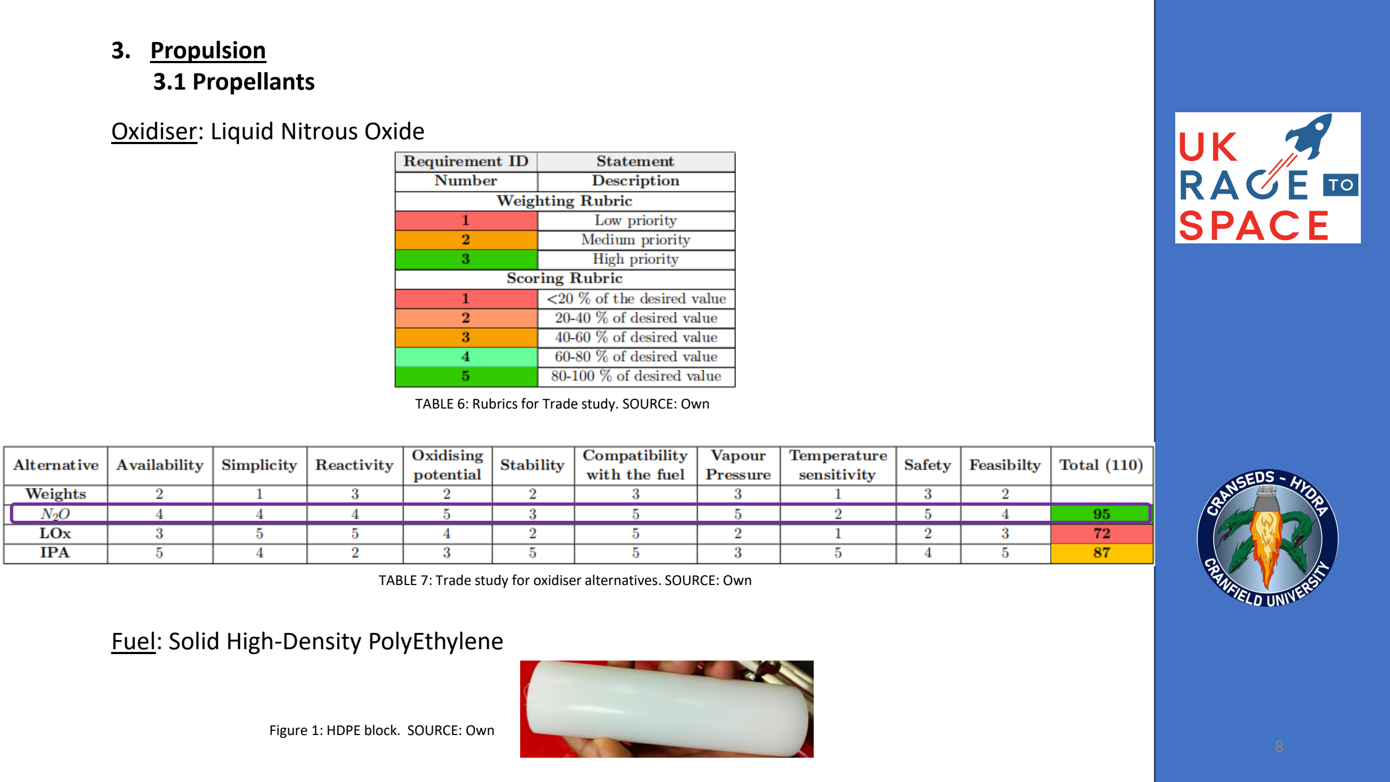
[picture p46: figure]
3. Propulsion 3.1 Propellants; Oxidiser: Liquid Nitrous Oxide; Fuel: Solid High-Density PolyEthylene; Figure 1: HDPE block. SOURCE: Own

TABLE 6: Rubrics for Trade study. SOURCE: Own

TABLE 7: Trade study for oxidiser alternatives. SOURCE: Own

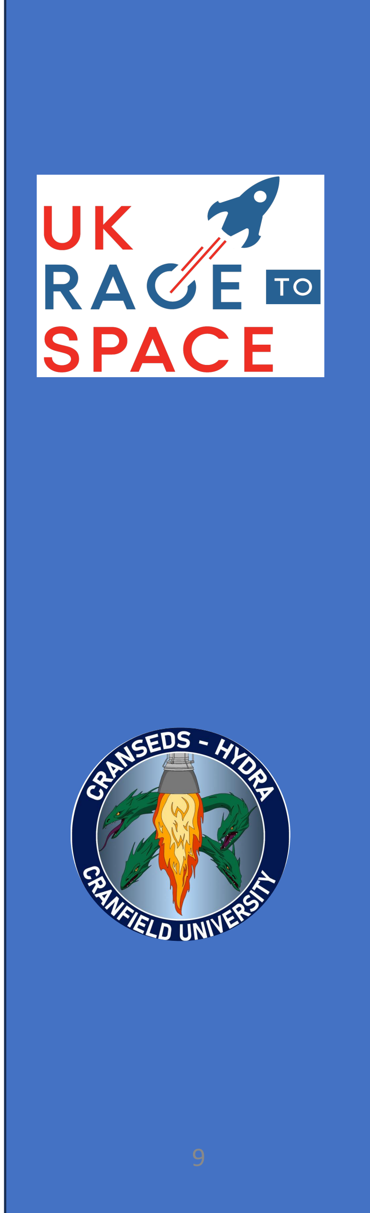
[picture p47: figure]

### 3. Propulsion 3.2 Engine Design

Feed line

Thruster

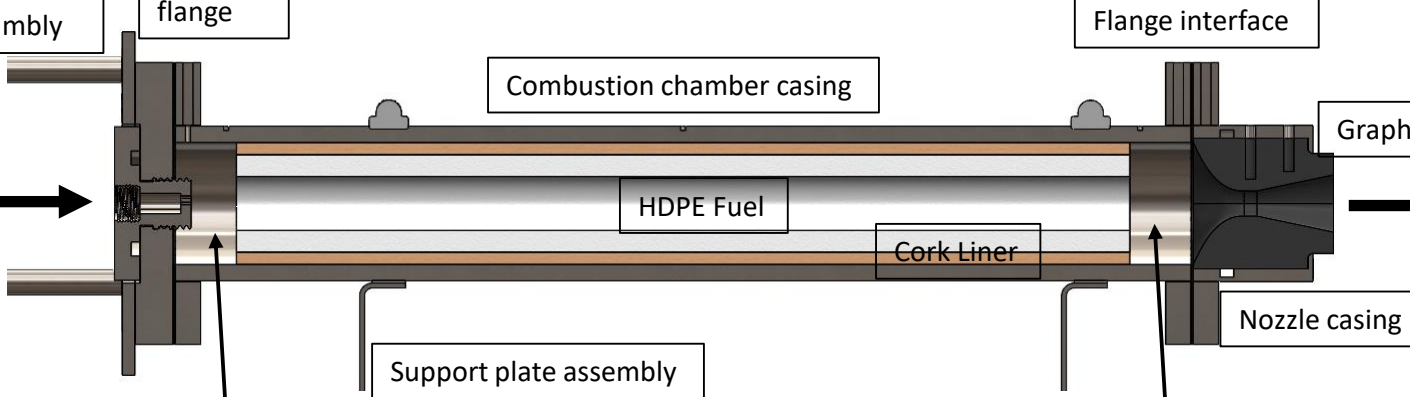
[picture p48: figure]
Combustion chamber casing; Support plate assembly; Flange interface; Nozzle casing; HDPE Fuel; Cork Liner

assembly

Injector
flange

Exhuast

Graphite nozzle

Pre-combustion
chamber length

Post-combustion
chamber length

Figure 2: Engine Design overview. SOURCE: Own

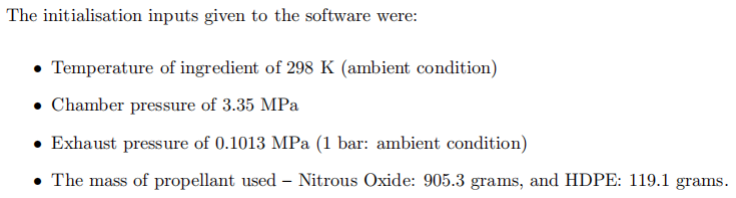
[picture p49: figure]
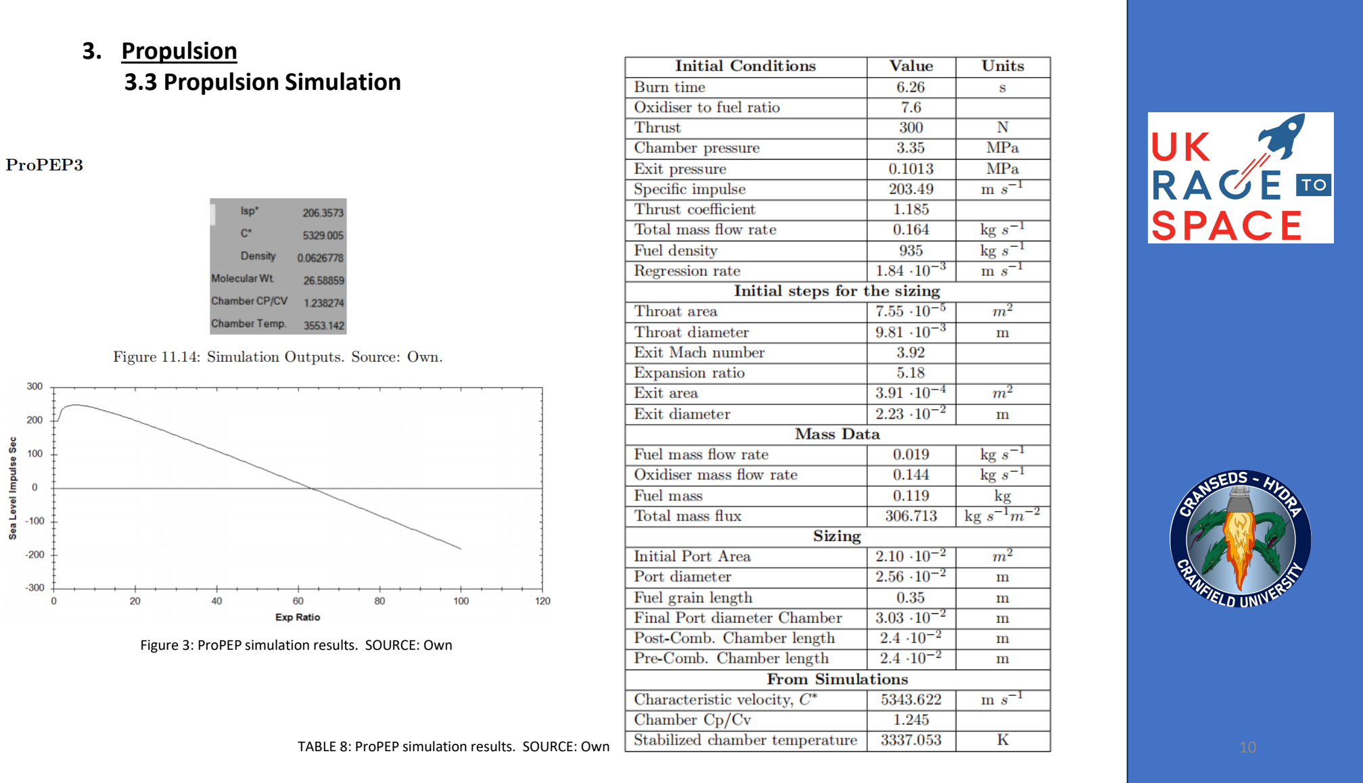
[picture p50: page 10]

### 3. Propulsion 3.3 Propulsion Simulation

Figure 3: ProPEP simulation results. SOURCE: Own

TABLE 8: ProPEP simulation results. SOURCE: Own

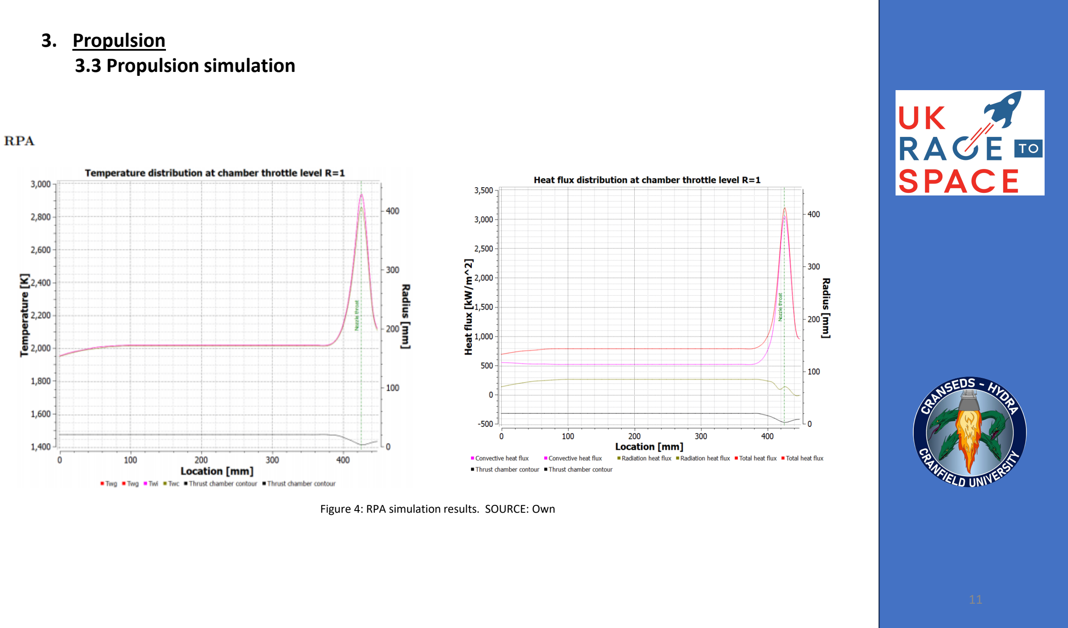
[picture p51: page 11]

### 3. Propulsion 3.3 Propulsion simulation

Figure 4: RPA simulation results. SOURCE: Own

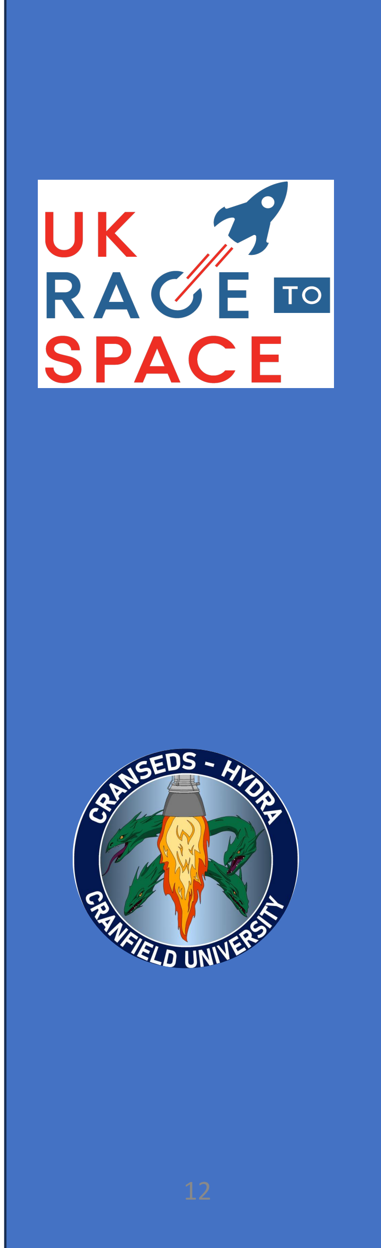
[picture p52: figure]

### 4. Computational Fluid Dynamics (CFD)

- Density based transient solver with a Steady state asymmetric flow
- Energy model and standard k-ε viscous model
- Propellent used is N2O without species transport due to 2-D model of nozzle
- Pressure inlet = 335 kPa at 3375 K temperature, Pressure outlet = 101.325 kPa at 300K temperature and symmetry is considered as wall for boundary conditions.
- Coupled solution methods is used and the solution is initialized at the inlet.
- Solution is run for over 5000 iterations and the pressure, velocity, density and temperature contour plotted.
- The Computational value of thrust varies from 327.3 N which is around 9.1% of the predicted value (300N)
- The mass flow rate is equal to 0.1765 kg/s which is around 7.88% of the predicted value (0.1636 N)
- The thrust is constant and then there is a sudden drop as we move along the length of the nozzle.

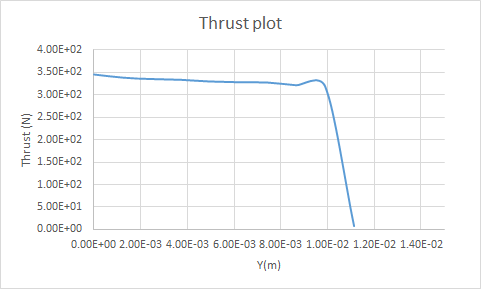
[picture p53: figure]

Figure 5: CFD simulation thrust plot results. SOURCE: Own

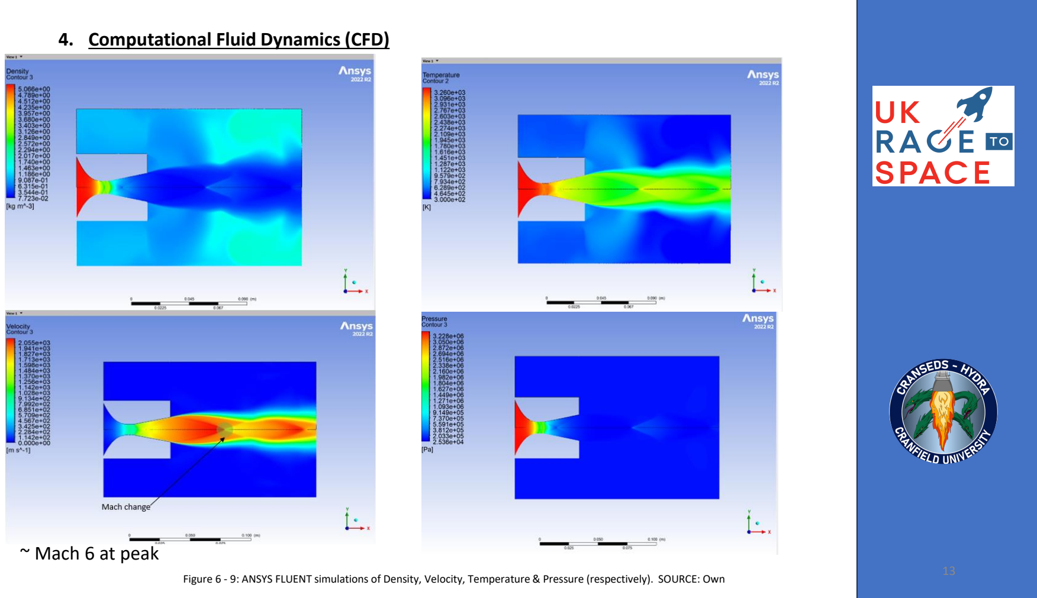
[picture p54: page 13]

~ Mach 6 at peak

Figure 6 - 9: ANSYS FLUENT simulations of Density, Velocity, Temperature & Pressure (respectively). SOURCE: Own

### 4. Computational Fluid Dynamics (CFD)

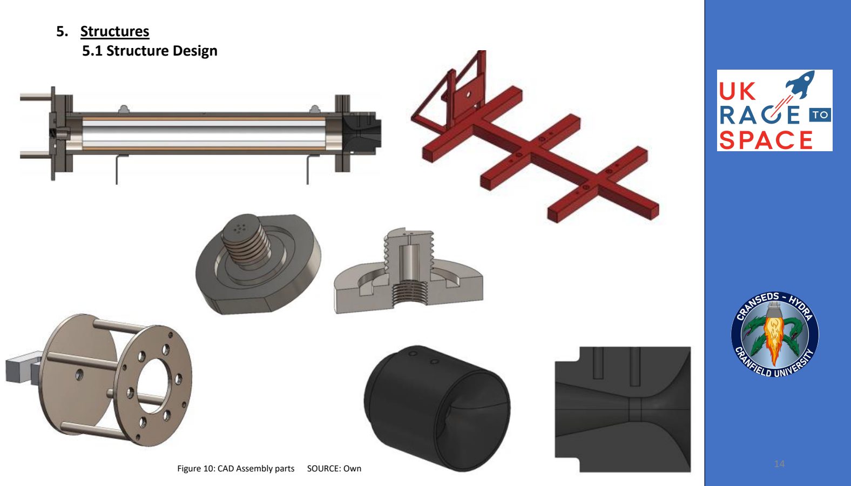
[picture p55: page 14]

### 5. Structures 5.1 Structure Design

Figure 10: CAD Assembly parts SOURCE: Own

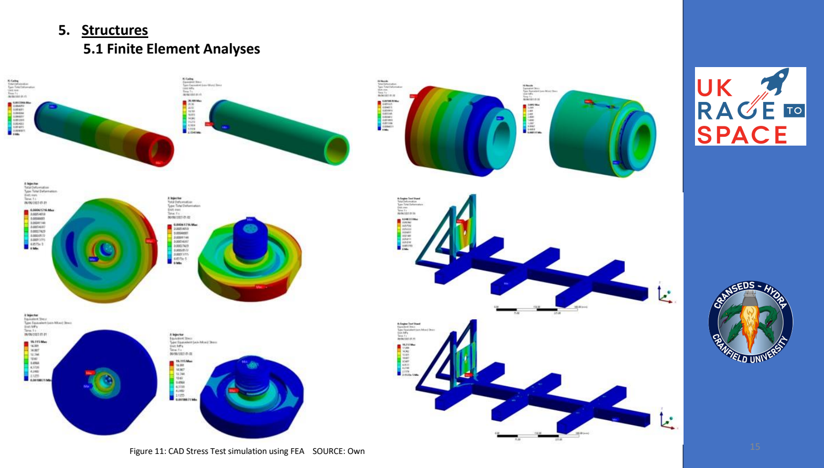
[picture p56: page 15]

### 5. Structures 5.1 Finite Element Analyses

Figure 11: CAD Stress Test simulation using FEA SOURCE: Own

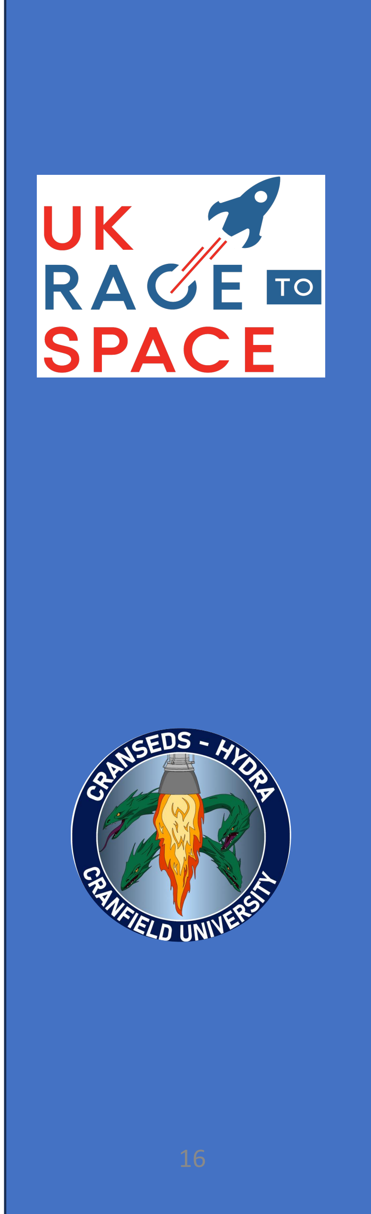
[picture p57: figure]

### 6. Data acquisition system (DAQ) 6.1 Thrust: Load cell

Tedea Huntleigh model 615 Load cell Capacity: 50 kg - 1000 kg
Rated output: 2 mV/V
Zero balance: 0.02 mV/V
Material: Electroless nickel plated alloy steel
Function: To measure engine thrust

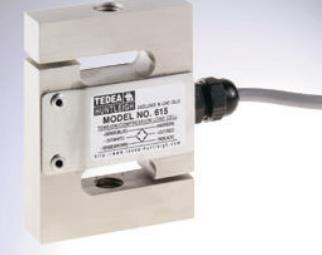
[picture p58: figure]
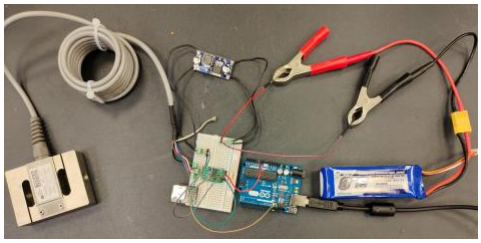
[picture p59: figure]

Figure 12: Load Cell | Figure 13: Load Cell Power & control Set up SOURCE: Own

### 6.2 Temperature: Thermocouple

RS Pro K type thermocouple Measurement range: 1100 deg C Type: K
Probe diameter: 1.5 mm
Probe material: Stainless stell 310
Function: To measure temperature conducted to the steel

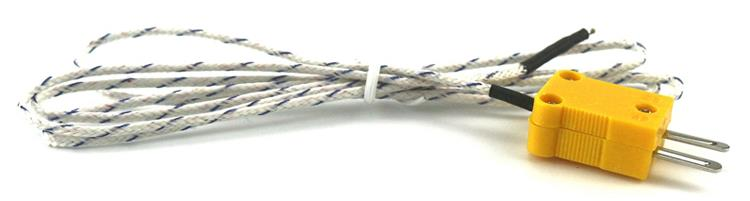
[picture p60: figure]

casing at various points of the combustion chamber Figure 14: Load Cell Power & control Set up. SOURCE: Own

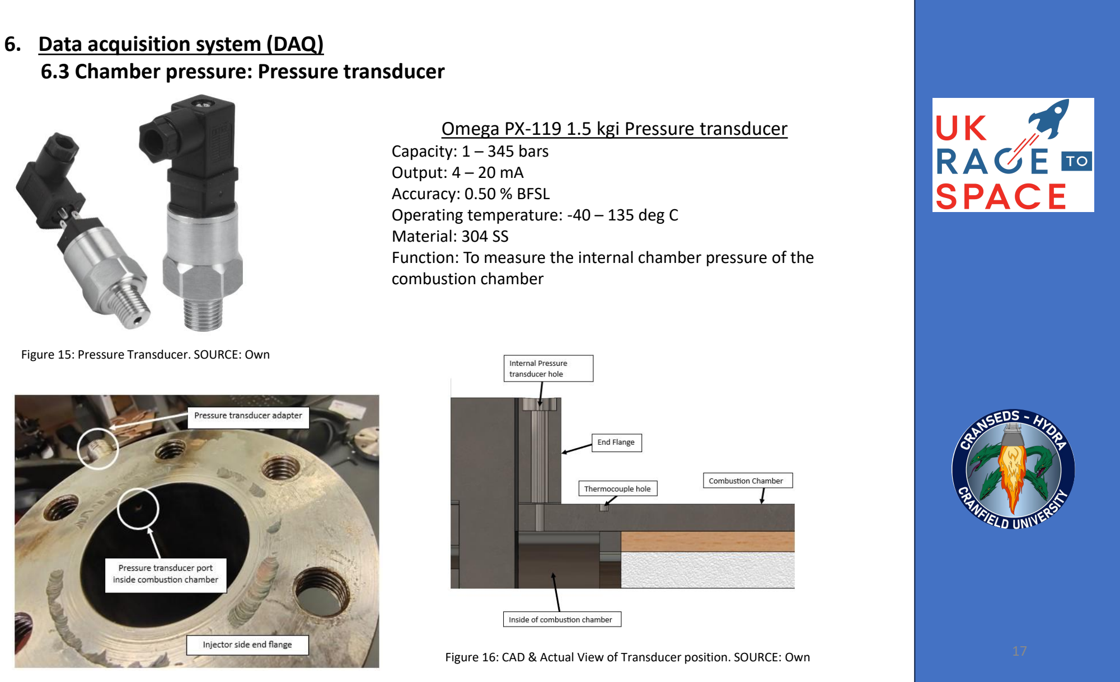
[picture p61: page 17]

### 6. Data acquisition system (DAQ) 6.3 Chamber pressure: Pressure transducer

Omega PX-119 1.5 kgi Pressure transducer Capacity: 1 – 345 bars
Output: 4 – 20 mA
Accuracy: 0.50 % BFSL
Operating temperature: -40 – 135 deg C
Material: 304 SS
Function: To measure the internal chamber pressure of the combustion chamber

Figure 15: Pressure Transducer. SOURCE: Own

Figure 16: CAD & Actual View of Transducer position. SOURCE: Own

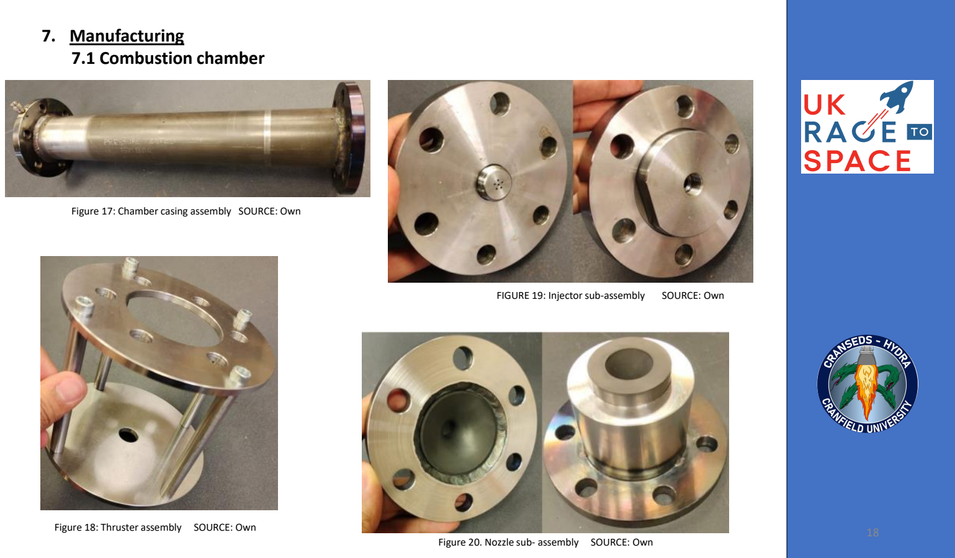
[picture p62: page 18]

### 7. Manufacturing 7.1 Combustion chamber

Figure 18: Thruster assembly SOURCE: Own

FIGURE 19: Injector sub-assembly SOURCE: Own

Figure 20. Nozzle sub- assembly SOURCE: Own

Figure 17: Chamber casing assembly SOURCE: Own

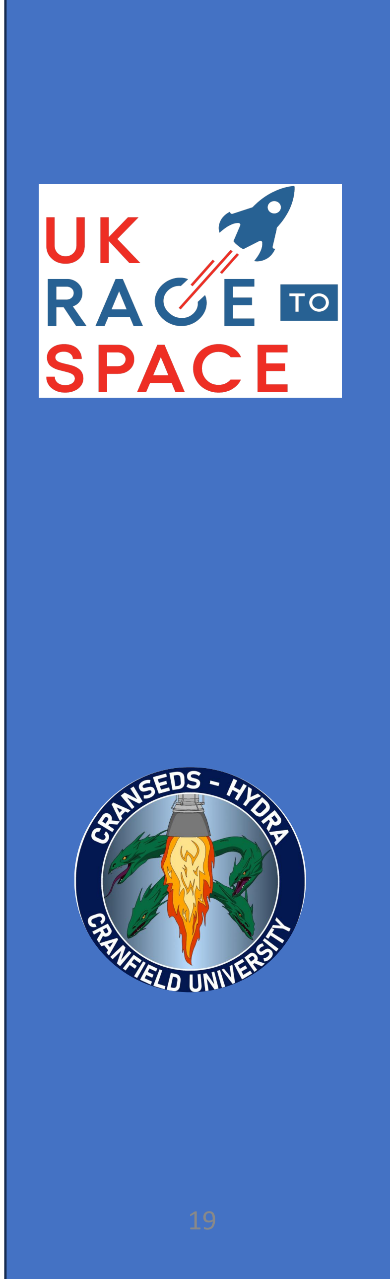
[picture p63: figure]

### 7. Manufacturing 7.2 Test stand

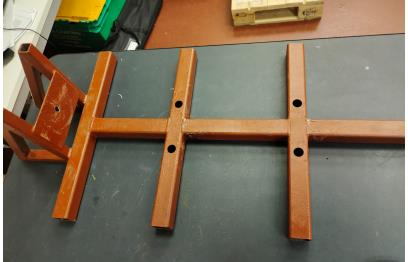
[picture p64: figure]

Figure 21: Stainless steel welded Test stand. SOURCE: Own

### 7.3 Fuel block

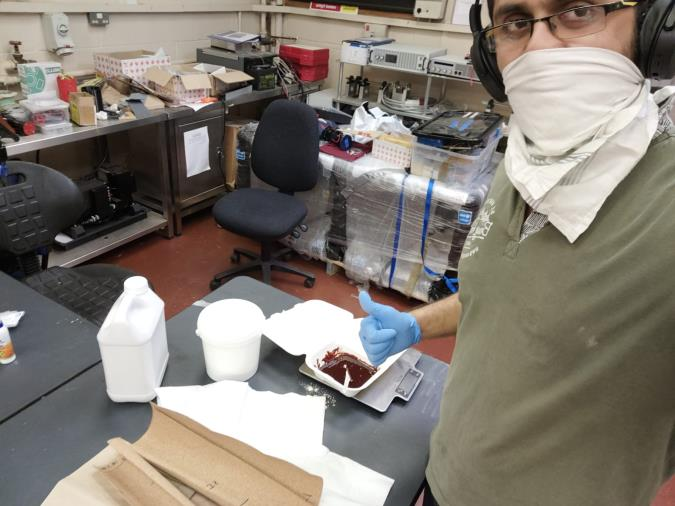
[picture p65: figure]
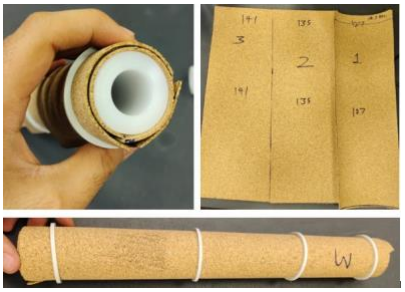
[picture p66: figure]

Figure 22: Fuel block side and front view SOURCE: Own | Figure 23: Preparing the fuel block. SOURCE: Own

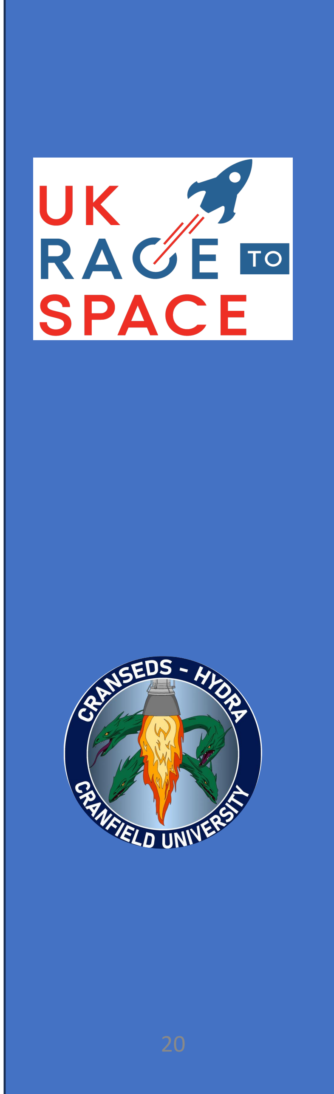
[picture p67: figure]

### 8. Testing 8.1 Pressure testing

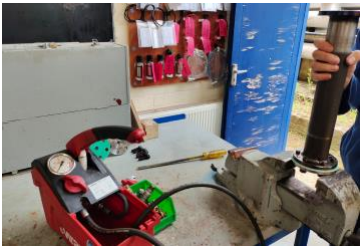
[picture p68: figure]
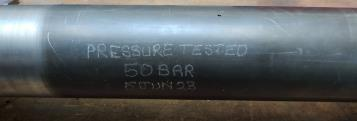
[picture p69: figure]

Figure 24: Pressure test Setup SOURCE: Own

### 8.2 Cold flow testing

This test aims to test the feed line system and the flow of the oxidiser through the injector plate into the combustion chamber. For this, the whole feed line system is set up, and the thruster assembly and the injector plate are connected to the test stand.
This setup tests and checks the oxidizer flow through the injector plate. This test aids in observing the showerhead flow, properties and the force exerted by the flow itself (if any).

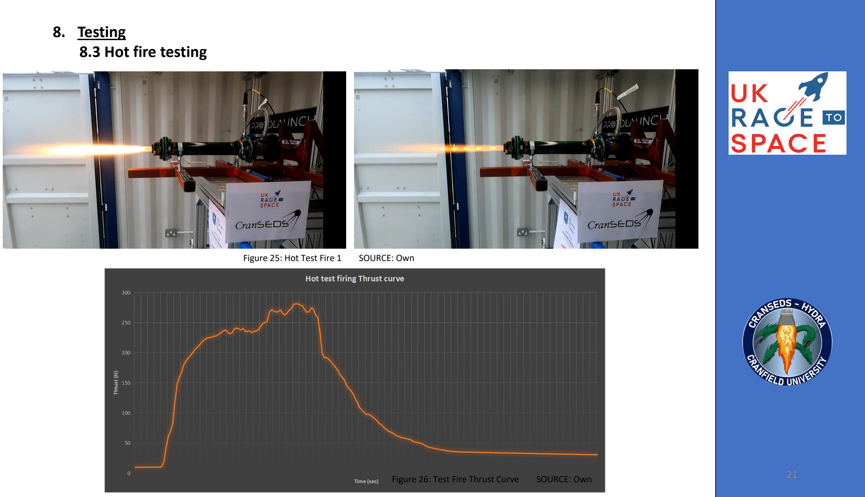
[picture p70: page 21]

### 8. Testing 8.3 Hot fire testing

Figure 25: Hot Test Fire 1 | SOURCE: Own
Figure 26: Test Fire Thrust Curve | SOURCE: Own

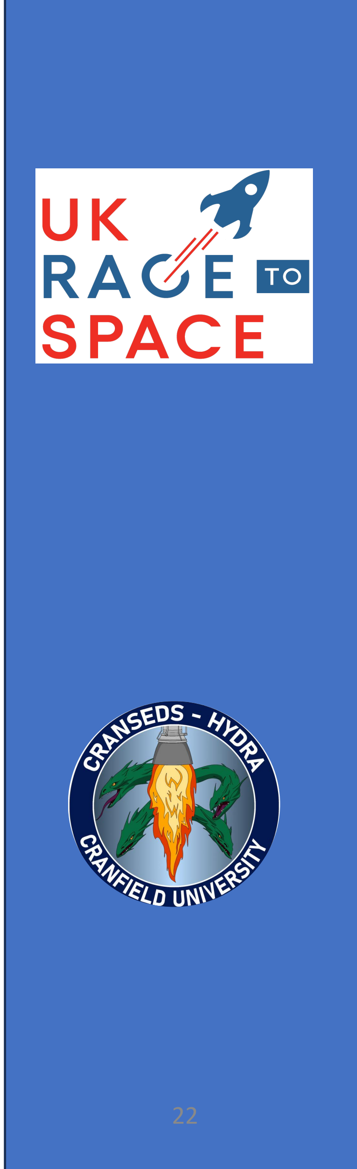
[picture p71: figure]

### 9. Conclusions 9.1 Lessons learnt

1. Tolerance in designing
2. Self powered data acquisition system
3. Pressure and cold flow testing
4. Thermocouples holding positions
5. Keeping ‘ready to go’ spares
6. Ignition failure in 2nd attempt: Blocked injector holes
7. Applied paint on the chamber evaporated
8. Not enough space for feed line adapter connection to the injector plate
9. Bolts not long enough on injector flange side
10. Not to do last minute work
11. Shall not use vibration based etching tool. Rather to use Dremel engraver
12. Understand complex, yet clear feed system assembly of Protolaunch, and use as an inspiration for setting up own feed system at the university’s test facility

Further lessons learnt points are being brainstormed by the team. Will be completely and orderly documented in the Event report.

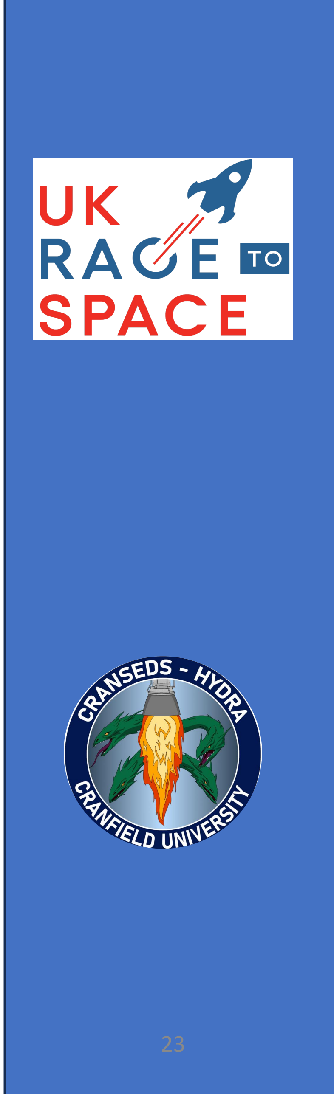
[picture p72: figure]

### 9. Conclusions 9.2 Knowledge transfer plan

1. Provided with all the official documents, team meeting minutes, progress reports, essential emails, post-event reports, videos, and literature with important sections marked that will be directly beneficial for them during designing and manufacturing.
2. At the start of the team induction, a 2-day workshop for the new team members to provide them with an overview of the work done last year and the information that may be essential for them to start working.
3. The team cannot summarize everything in just 2 days, especially if the team will manufacture after 5-6 months. For this, the team members have individually decided to assist the new team by making themselves available for monthly or bimonthly progress and doubt clearance sessions.
4. A separate hand over document will be created by the current team in as such detail as possible, to help the new team, in any aspect possible.
5. Through our initiative of keeping contact with the new team, we act purely as team mentors and aid them through inevitable problems they will face throughout the year, including designing, manufacturing, testing, procurement, sponsorships, dealing with administration, and in general managing their coursework with the team.

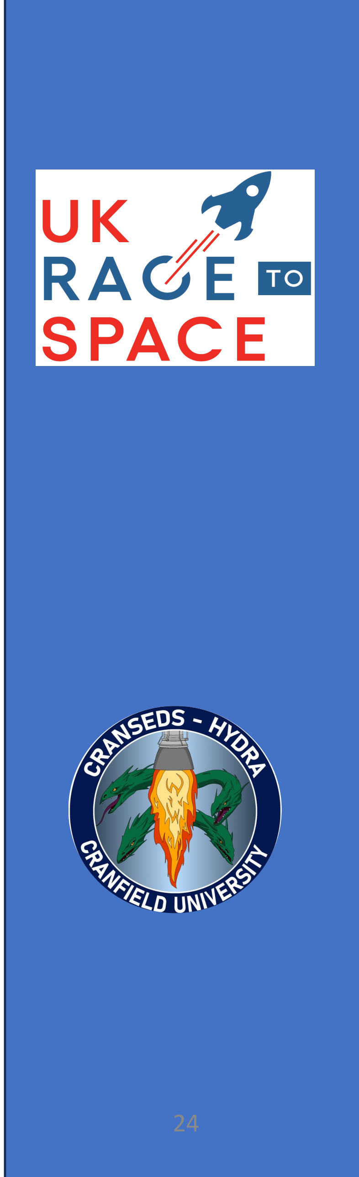
[picture p73: figure]

### 9. Conclusions 9.2 Future works

1. Increasing the thrust from 300 N to higher than 1000 N values
2. Reiterating experimentation with same feed and structure configuration, but changing the cross-section geometry of the slid fuel block
3. Reiterating experimentation with varying pre combustion chamber length, and post combustion chamber length
4. Setting up feed system at Cranfield university’s test facility to allow for safe and sound hot fire testing in campus facility
5. Varying the oxidizer and solid fuel with different propellants available, and comparing the results for same configuration and experiment
6. 13th EASN International Conference, Salerno, Italy, September 2023: Abstract submitted

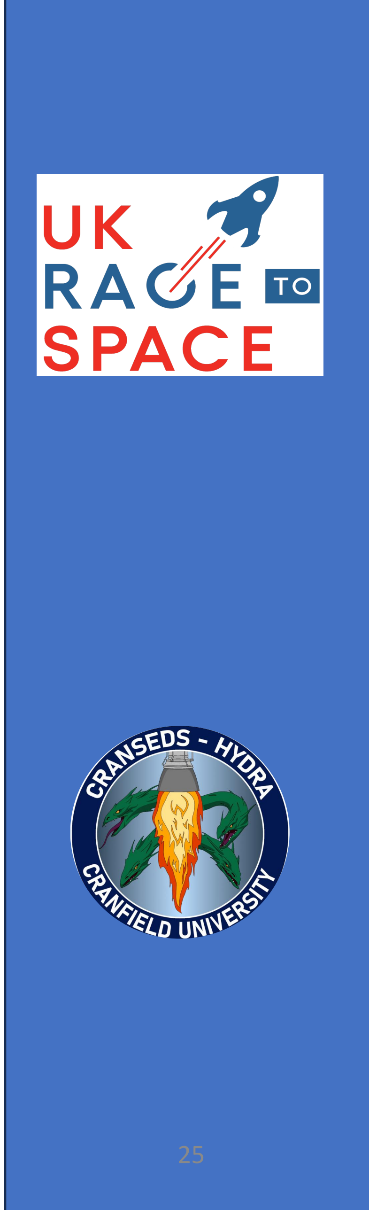
[picture p74: figure]

fin.

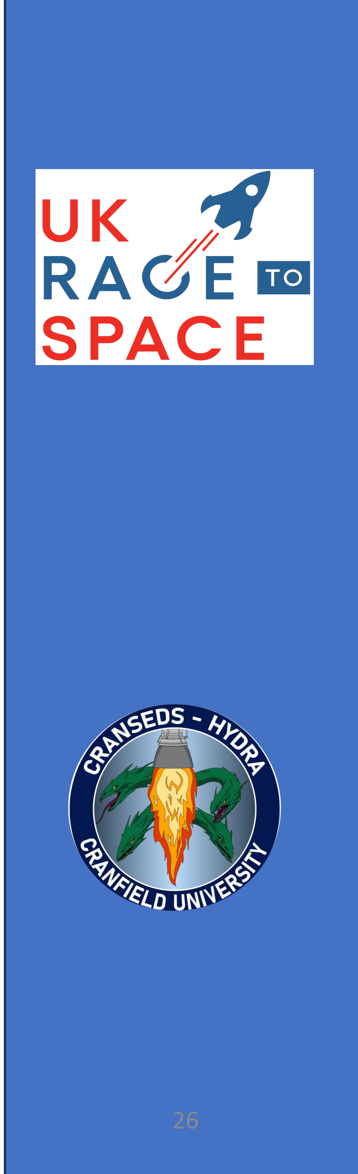
[picture p75: figure]

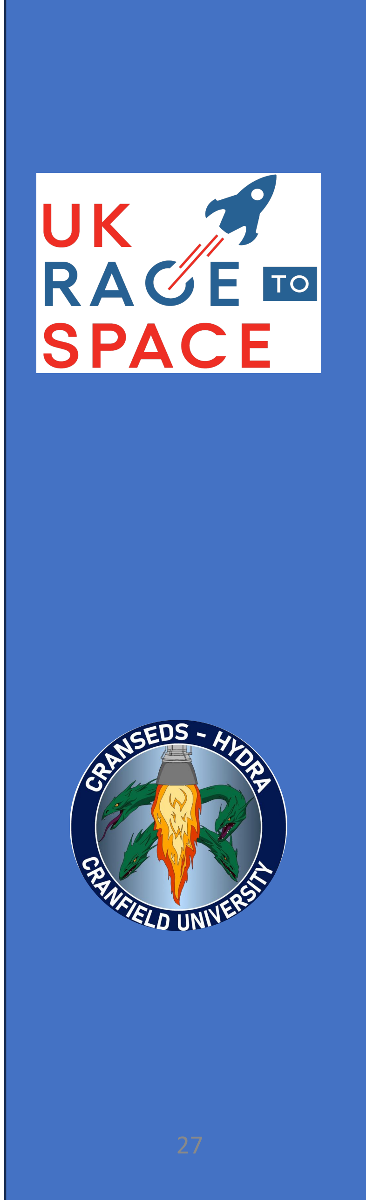
[picture p76: figure]

# 10.Appendices

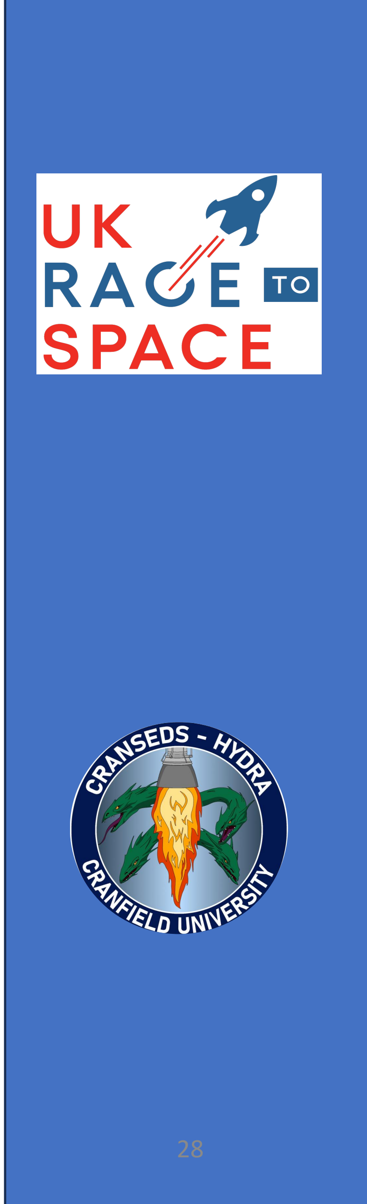
[picture p77: figure]

3. Propulsion
3.1 Pressure drop calculation 3.2 Propulsion thermochemistry
4. Structures
5.1 Stress calculation
5. CFD meshing

# Index

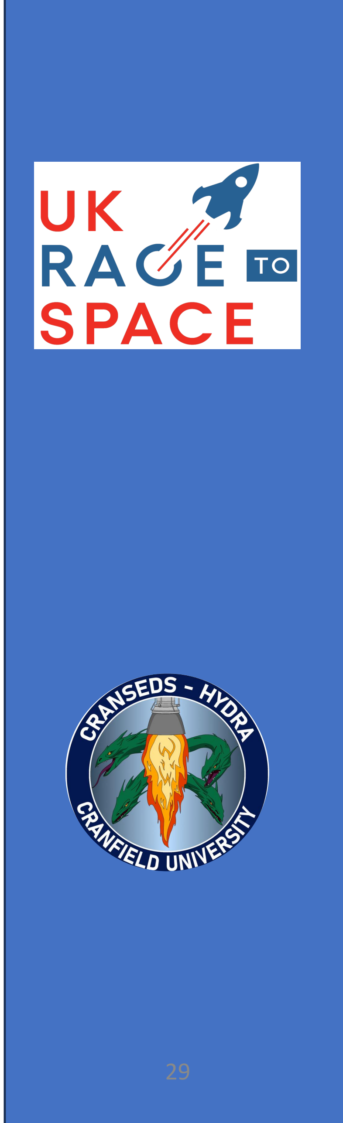
[picture p78: figure]

### 3. Propulsion 3.1 Pressure drop calculation

Injector Pressure Drop

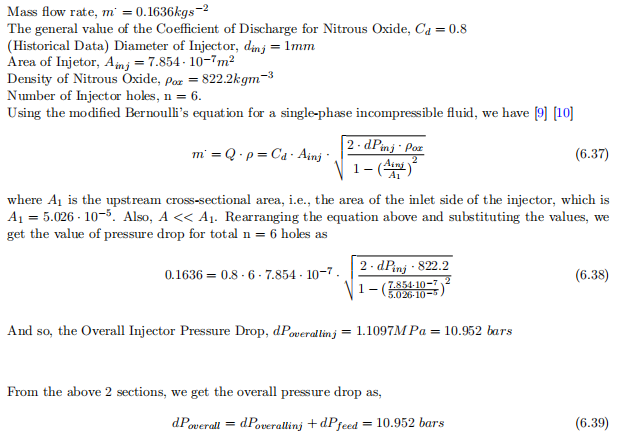
[picture p79: figure]

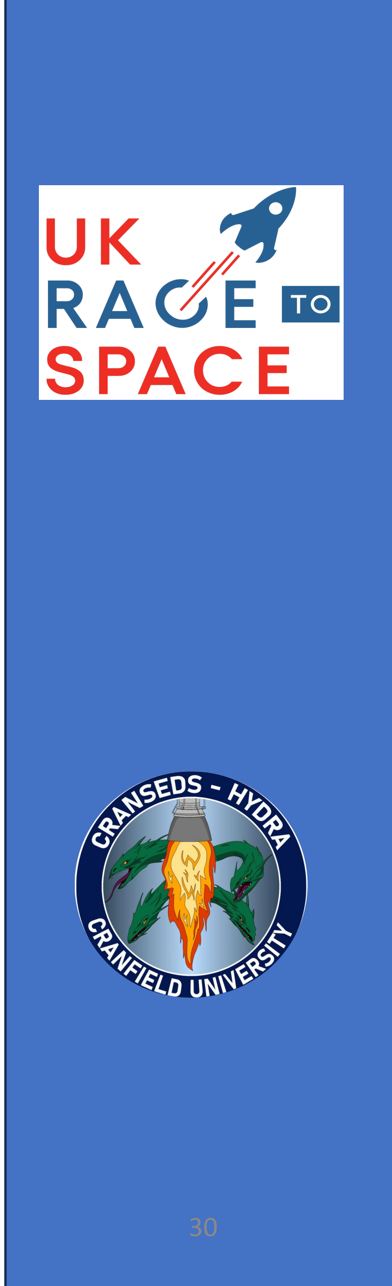
[picture p80: figure]

### 3. Propulsion 3.2 Propulsion thermochemistry

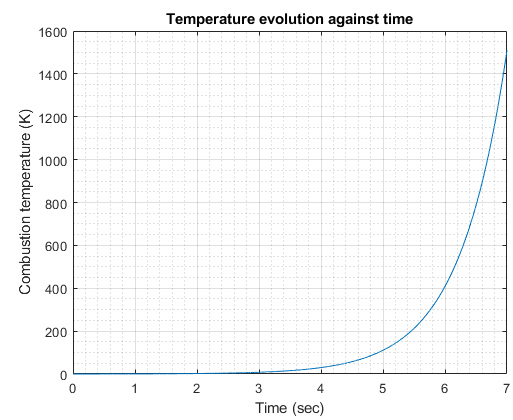
[picture p81: figure]

and

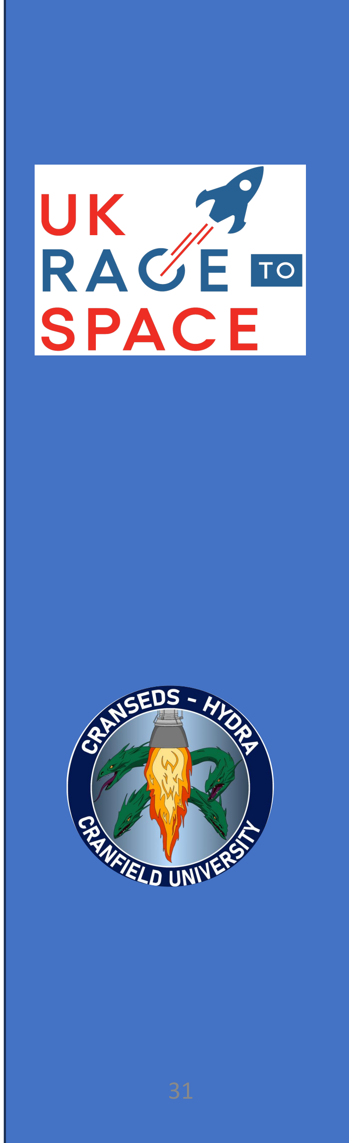
[picture p82: figure]

### 5. Structures 5.1 Stress calculation

σc =

P. d
2.t

= 13.4 MPa

σℎ =

P. d
4.t

= 6.7 MPa

Circumferential stress,

Hoop stress,

Shear stress, | σs = P. d 8.t = 3.35 MPa
Max. possible stress, | σT = 15.71MPa
Yield stress for Mild Steel, | σY = 250 MPa
Factor of Safety, | FOS =

σY
σT

= 15.9

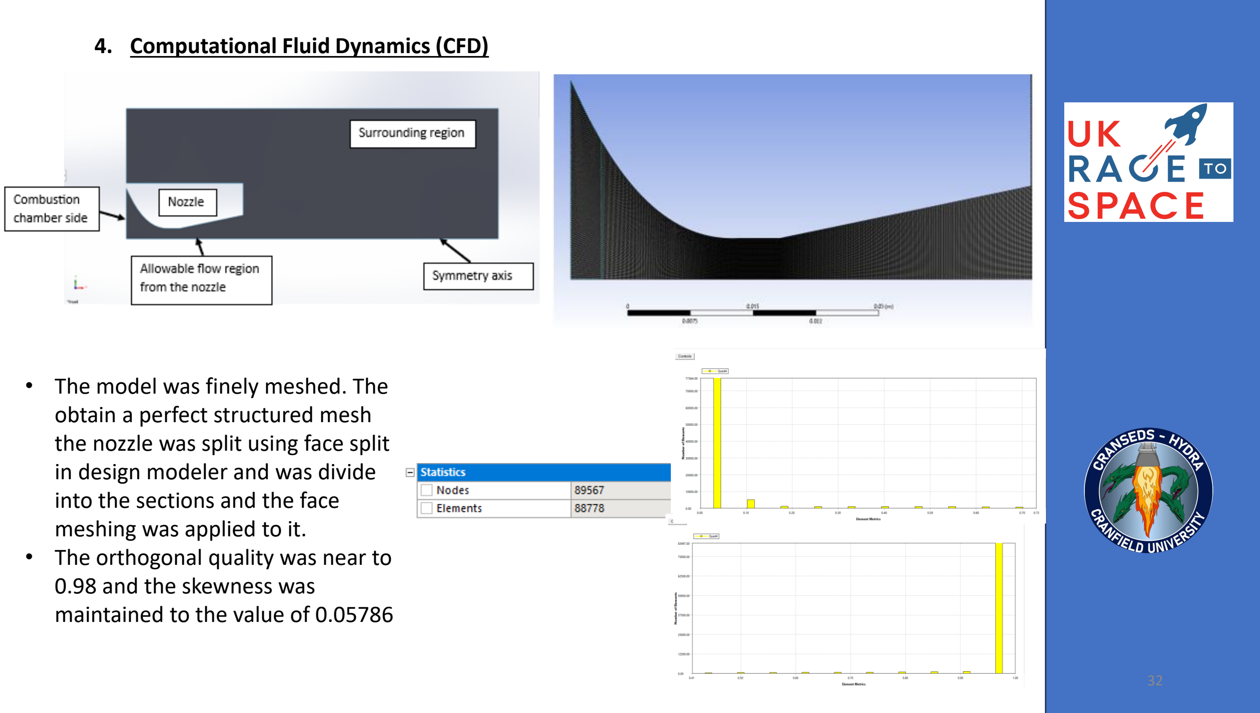
[picture p83: page 32]

### 4. Computational Fluid Dynamics (CFD)

- The model was finely meshed. The obtain a perfect structured mesh the nozzle was split using face split in design modeler and was divide into the sections and the face meshing was applied to it.
- The orthogonal quality was near to 0.98 and the skewness was
maintained to the value of 0.05786

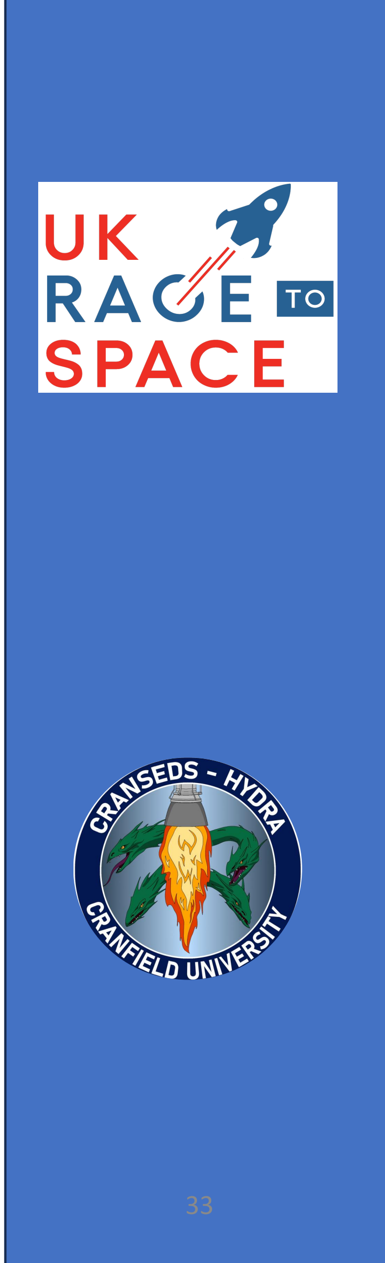
[picture p84: figure]
