Triyanpal/HYROE/Images/Design/control_scematic1.drawio.png

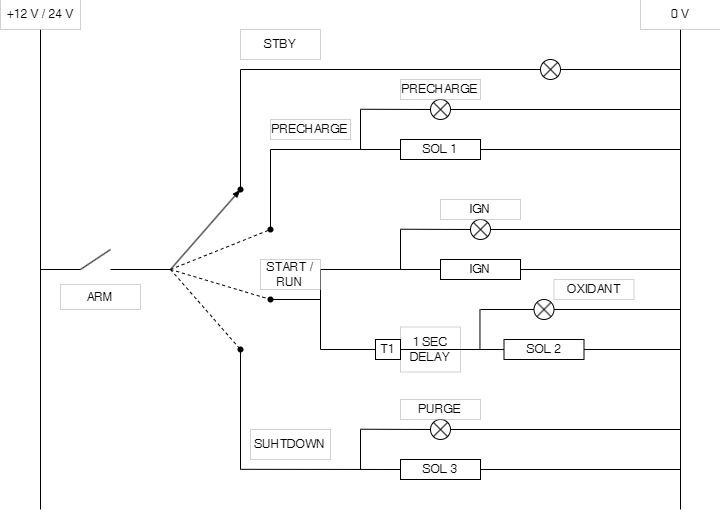
Images/Design/control_scematic1.drawio.png
