Triyanpal/HYROE/Images/Design/CranSEDS_HYDRA_R2S.png

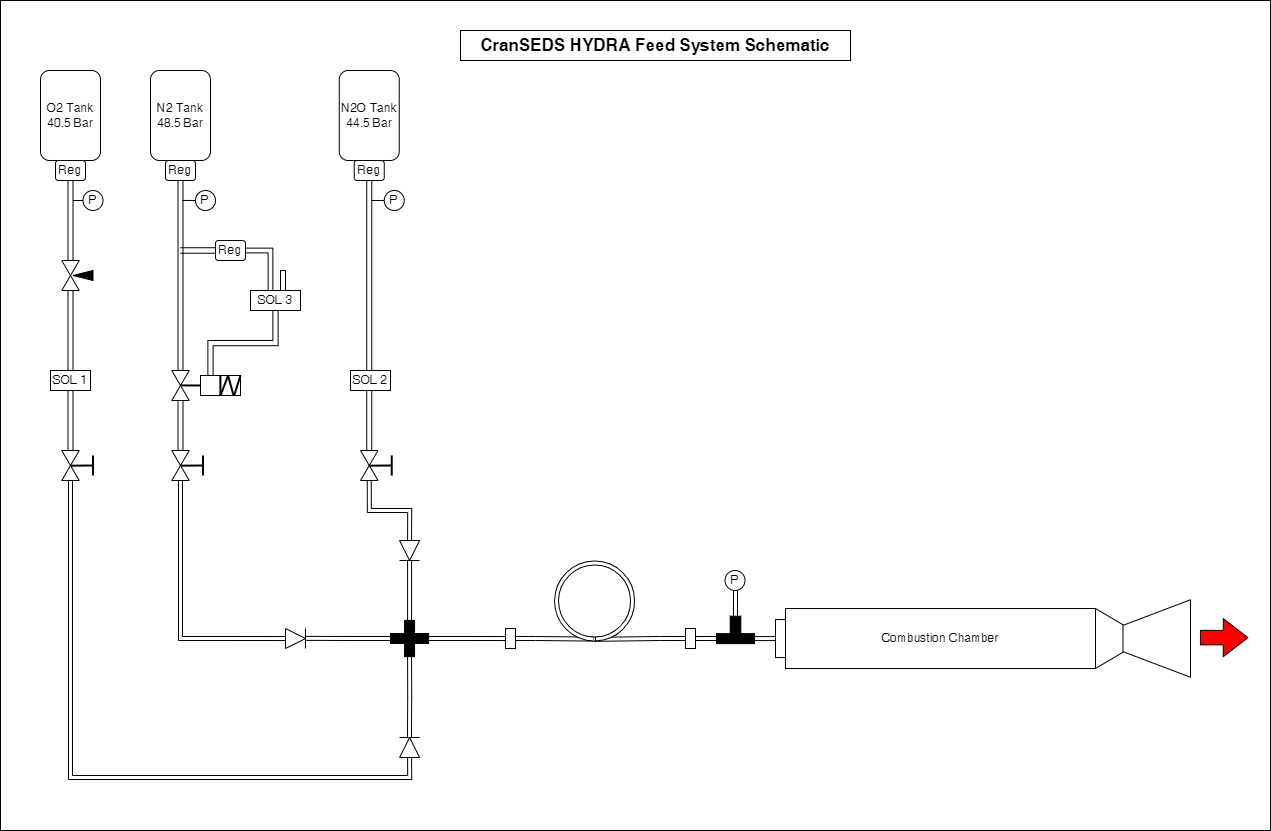
Images/Design/CranSEDS_HYDRA_R2S.png
