Triyanpal/HYROE/Images/Design/daq_schematic.png

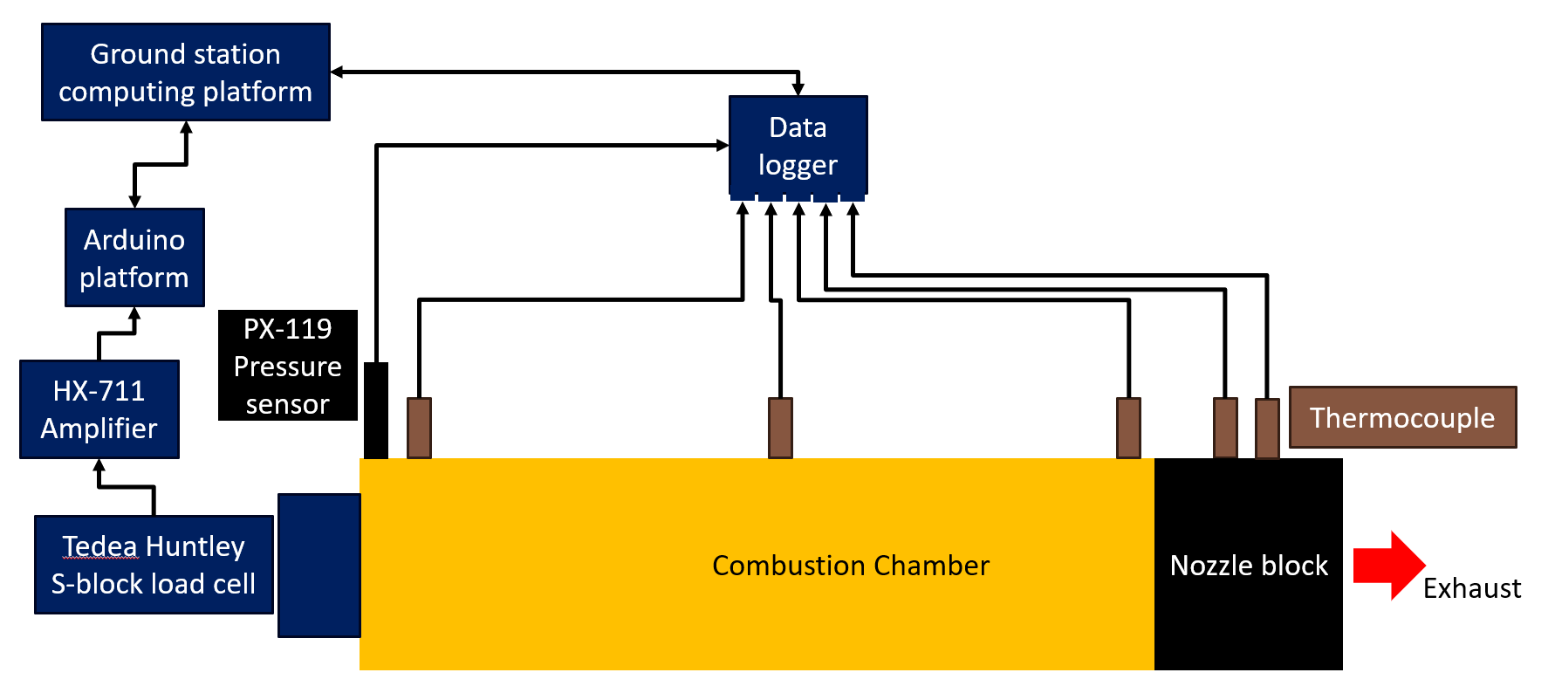
Images/Design/daq_schematic.png
