Triyanpal/HYROE/Images/Design/daqcircuit.drawio.png

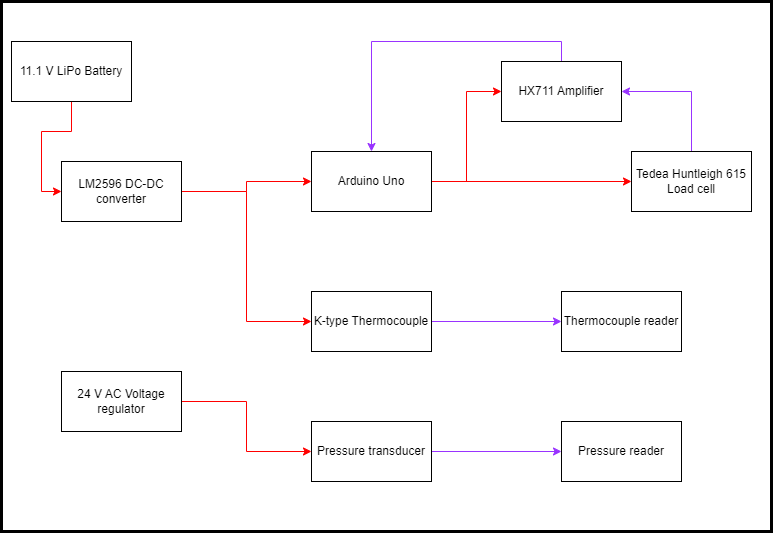
Images/Design/daqcircuit.drawio.png
