Triyanpal/HYROE/Images/Design/empirical_mapping2.png

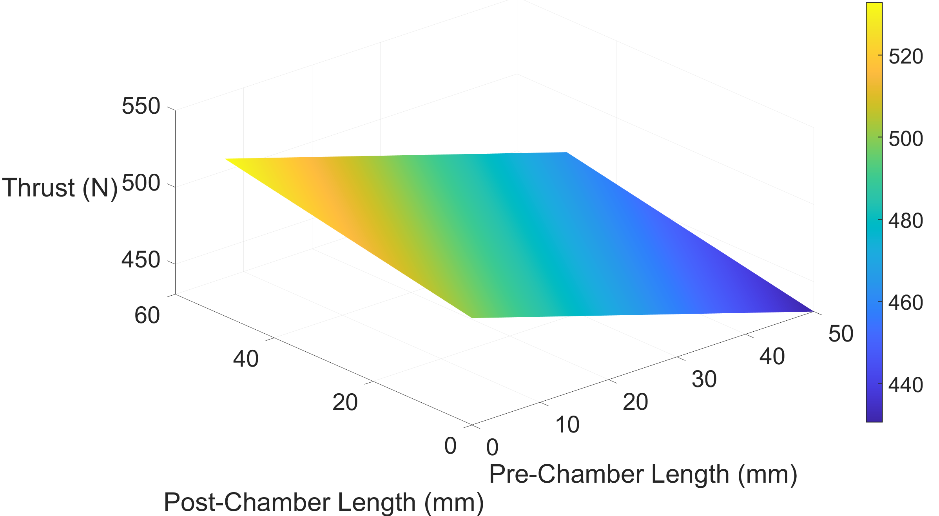
Images/Design/empirical_mapping2.png
