Triyanpal/HYROE/Images/Design/empirical_mapping.png

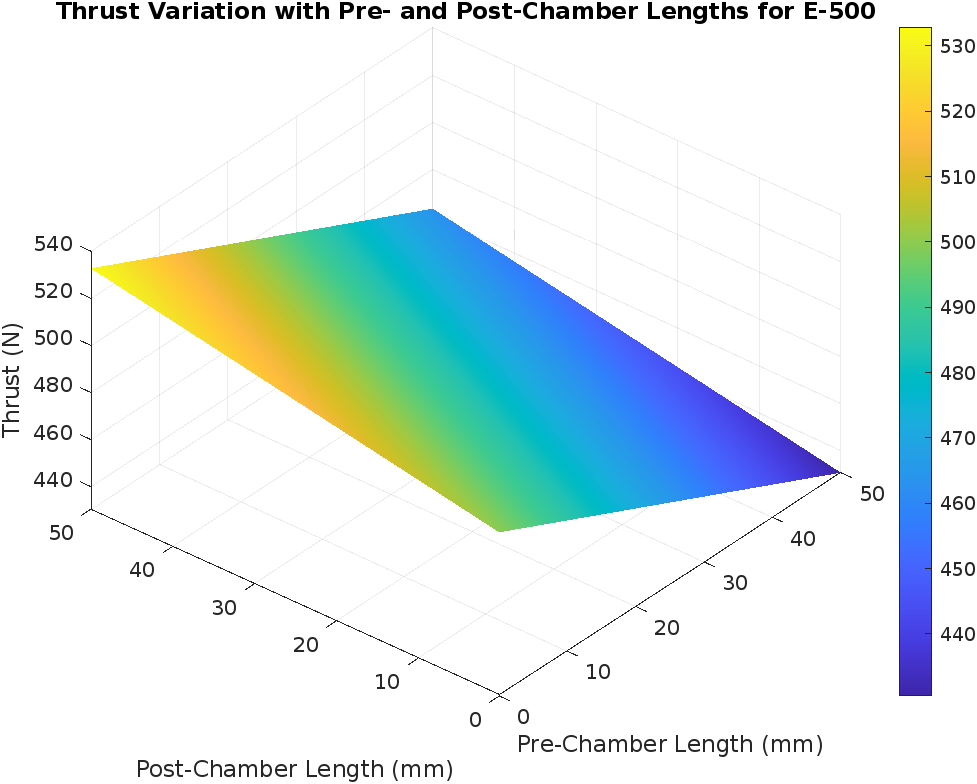
Images/Design/empirical_mapping.png
