Triyanpal/HYROE/Images/Design/fea_casing.jpg

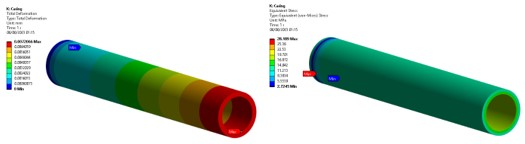
Images/Design/fea_casing.jpg
