Triyanpal/HYROE/Images/Design/fuelgrain_casing_insulation.png

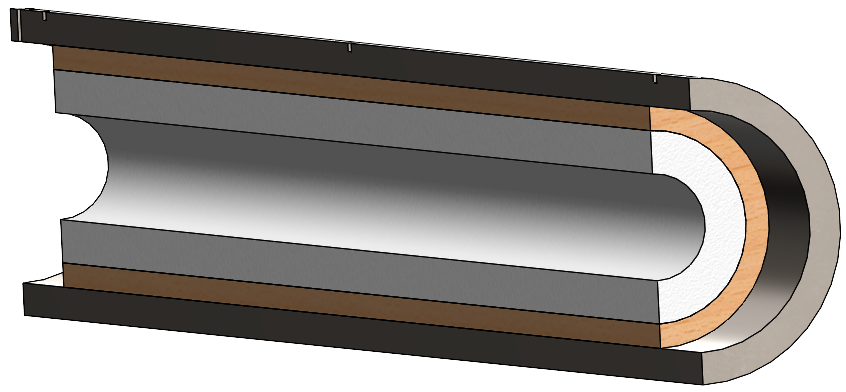
Images/Design/fuelgrain_casing_insulation.png
