Triyanpal/HYROE/Images/Design/ignition.PNG

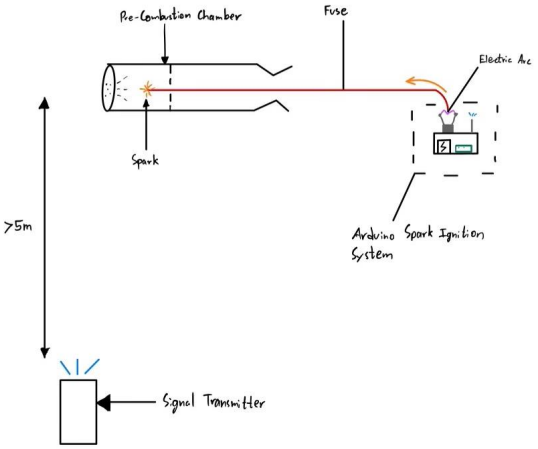
Images/Design/ignition.PNG
