Triyanpal/HYROE/Images/Design/injector.PNG

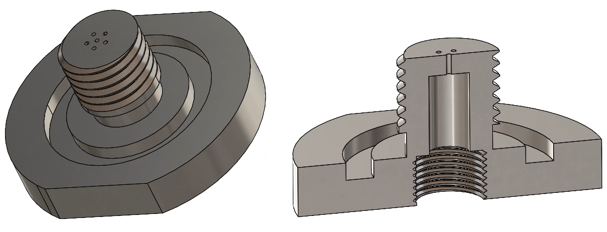
Images/Design/injector.PNG
