Triyanpal/HYROE/Images/Design/injectors.png

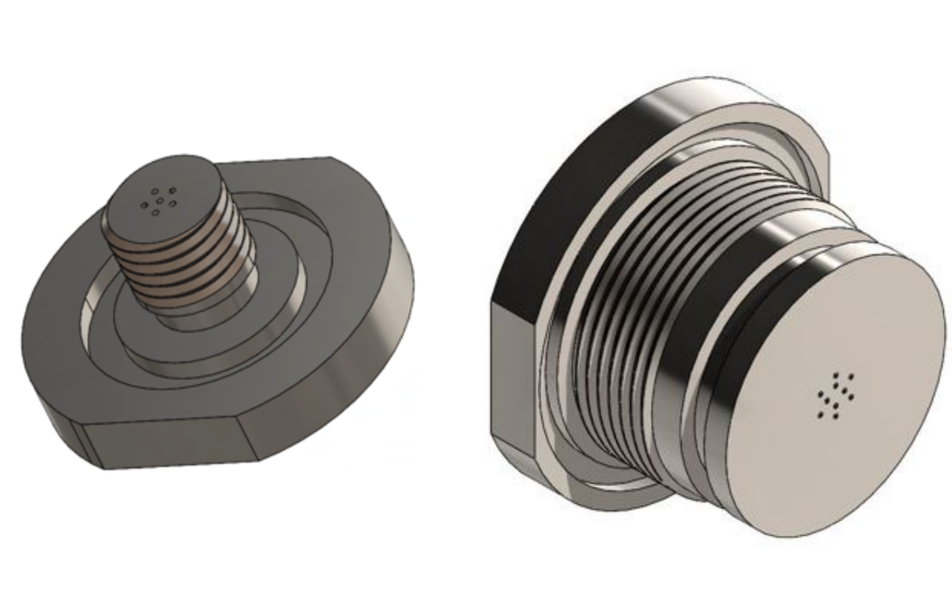
Images/Design/injectors.png
