Triyanpal/HYROE/Images/Design/nozzle.PNG

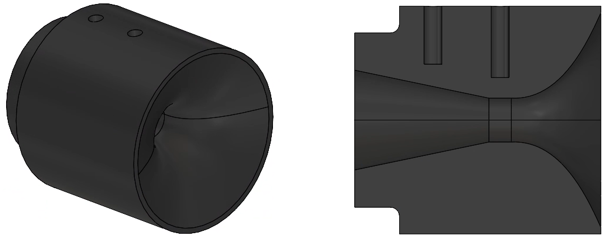
Images/Design/nozzle.PNG
