Triyanpal/HYROE/Images/Design/Picture3.png

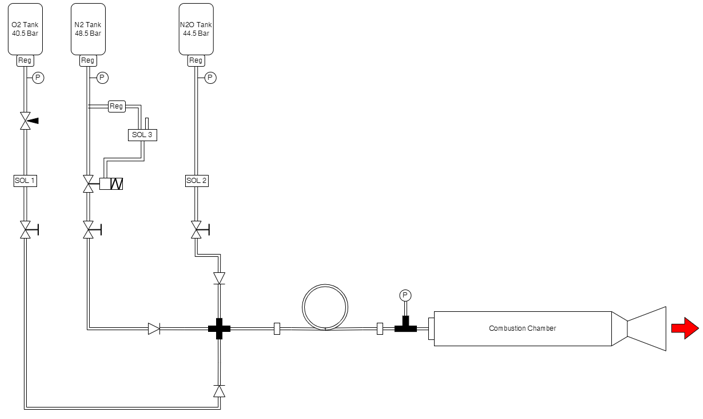
Images/Design/Picture3.png
