Triyanpal/HYROE/Images/Design/Picture12.png

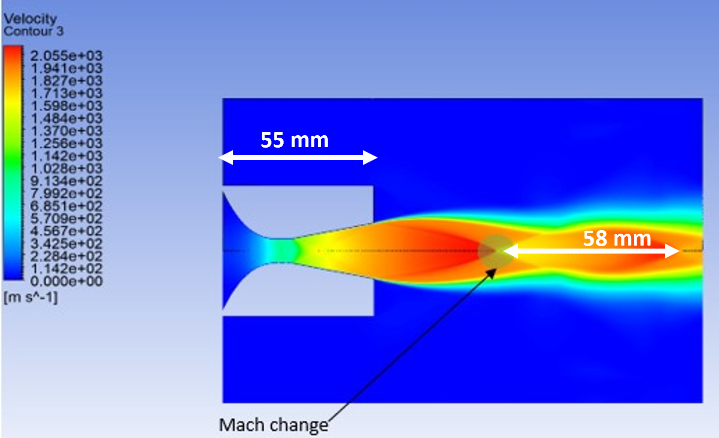
Images/Design/Picture12.png
