Triyanpal/HYROE/Images/Design/Picture14.png

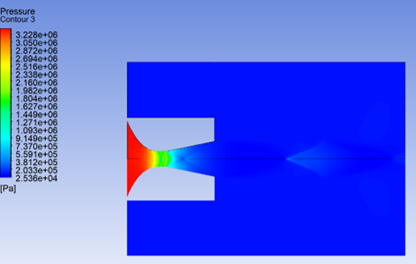
Images/Design/Picture14.png
