Triyanpal/HYROE/Images/Development/hydra1.png

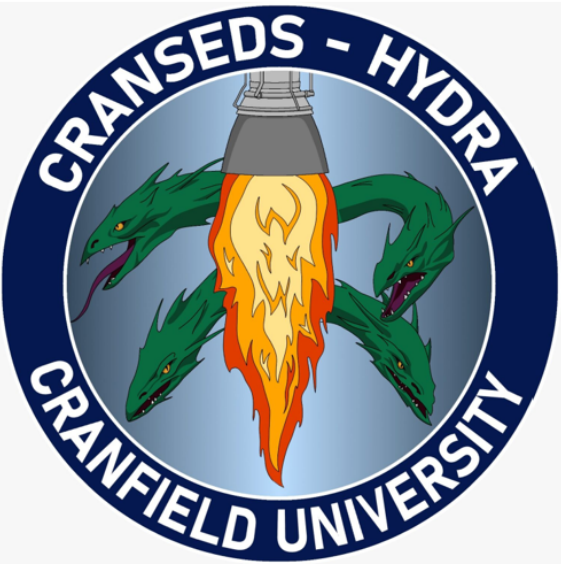
Images/Development/hydra1.png
