Triyanpal/HYROE/Images/Development/load_cell_circuit_2.jpeg

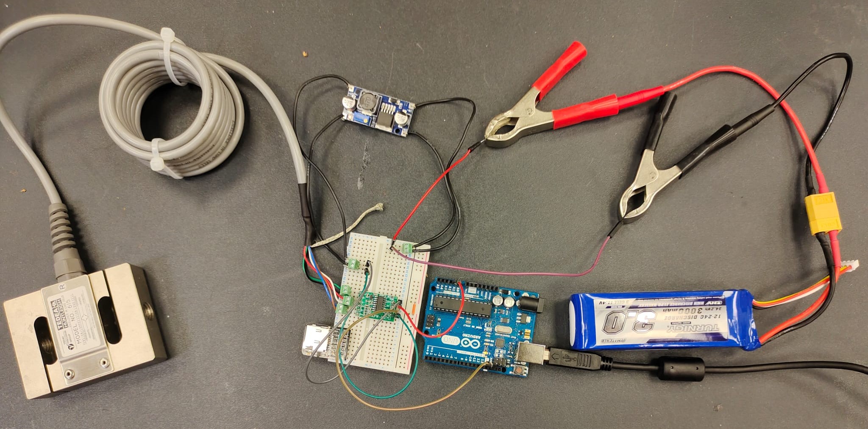
Images/Development/load_cell_circuit_2.jpeg
