Triyanpal/HYROE/Images/Development/Picture1.jpg

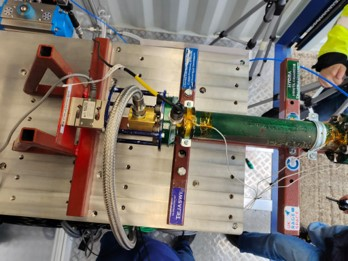
Images/Development/Picture1.jpg
