Triyanpal/HYROE/Images/Development/Picture8.png

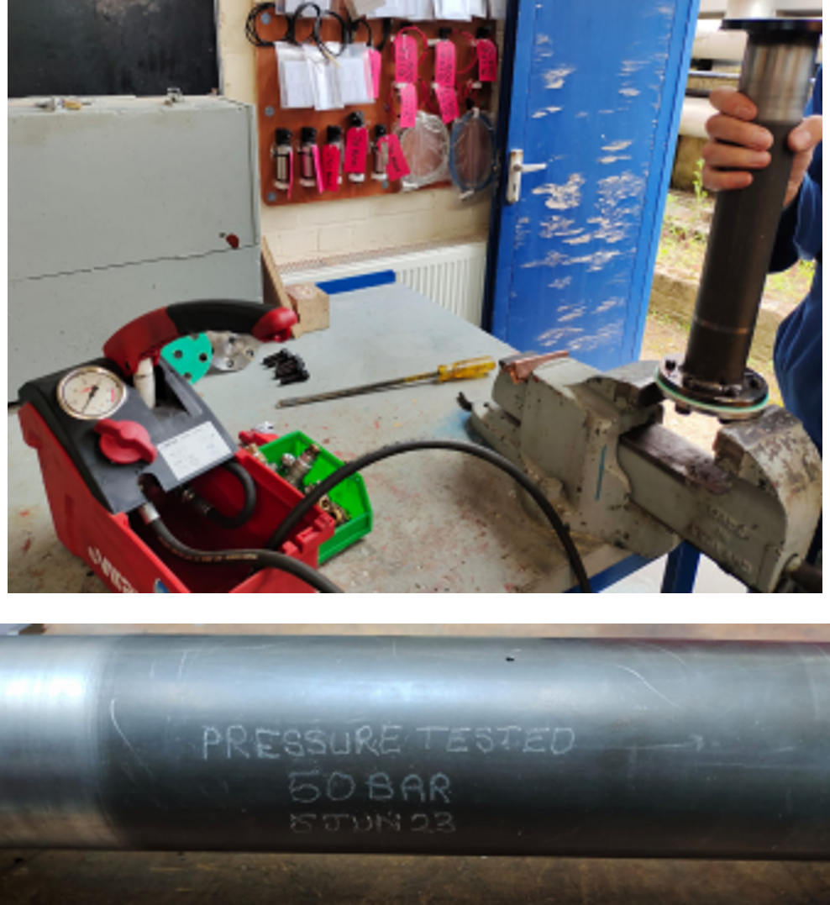
Images/Development/Picture8.png
