Triyanpal/HYROE/Images/Development/Picture10.jpg

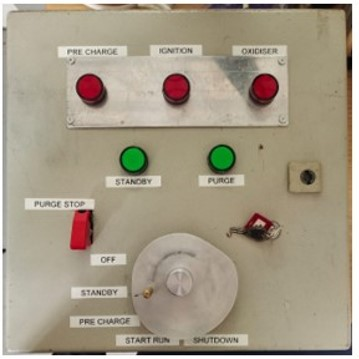
Images/Development/Picture10.jpg
