Triyanpal/HYROE/Images/Development/review/DAQ_revised.png

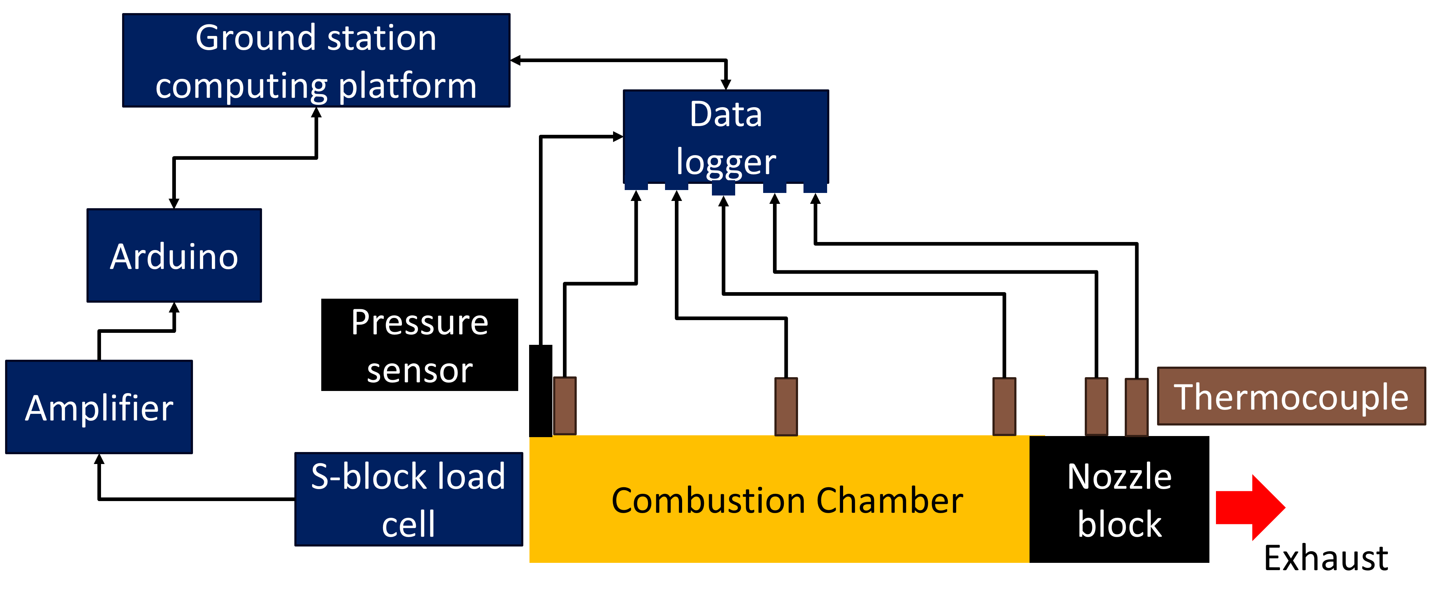
Images/Development/review/DAQ_revised.png
