Triyanpal/HYROE/Images/Development/review/Injector_revised.png

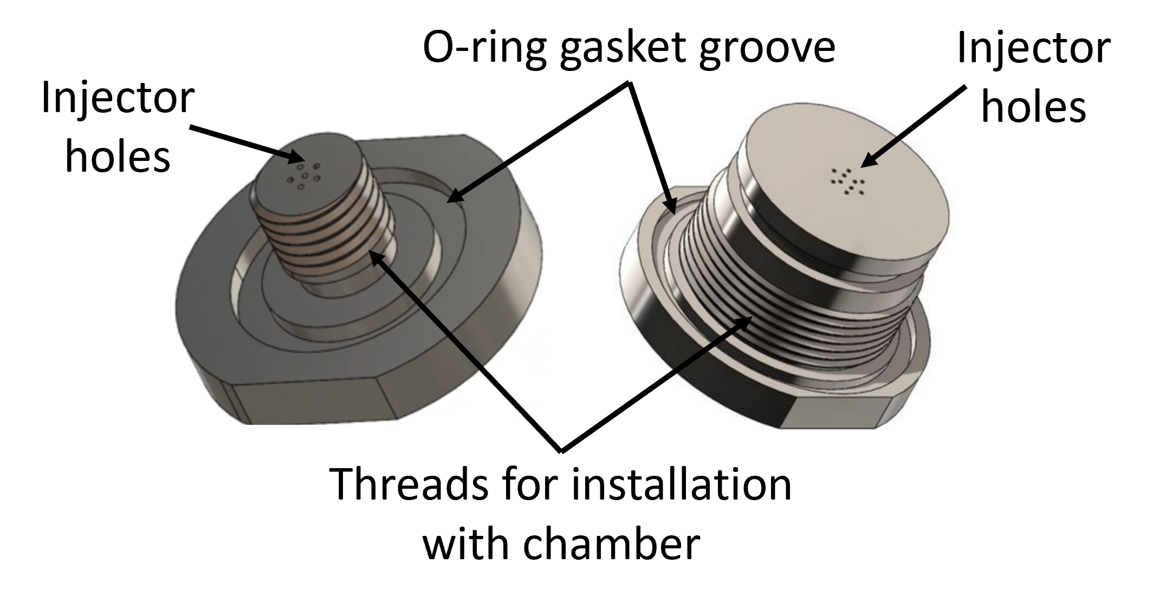
Images/Development/review/Injector_revised.png
