Triyanpal/HYROE/Resources/thrust curve.png

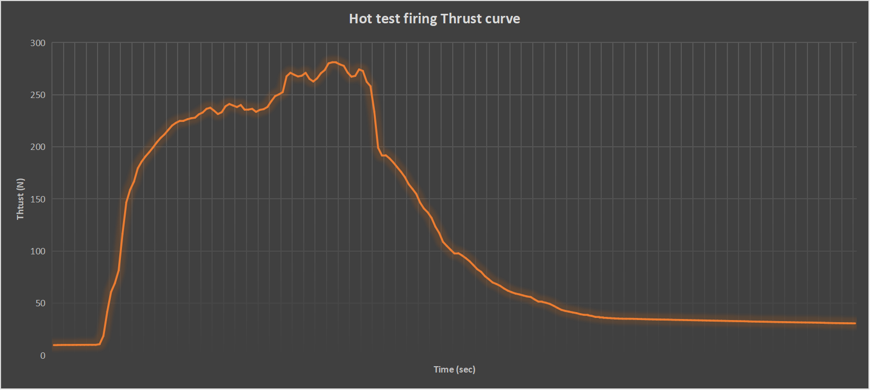
Resources/thrust curve.png
