Triyanpal/HYROE/Testing_Analyses/Testing-2023/hrmts_force_output_14_47_57.xlsx

Remove weights from scale
Tare complete - starting measurement in 3 s |  | 704.62335
0.861 | -0.00762
0.963 | -0.01053
1.064 | -0.01702
1.166 | -0.01389
1.268 | -0.01187
1.369 | -0.01613
1.47 | 0.00314
1.573 | 0.00806
1.674 | 0.00336
1.776 | 0.00538
1.878 | 0.01344
1.979 | 0.00179
2.081 | 0.00627
2.182 | 0.00538
2.285 | 0.0047
2.386 | 0.00717
2.487 | 0.0121
2.59 | 0.01277
2.691 | 0.00045
2.792 | -0.01187
2.894 | -0.00224
2.996 | -0.01277
3.098 | -0.00426
3.199 | 0.01053
3.301 | 0.00784
3.403 | -0.00605
3.504 | -0.00403
3.606 | -0.01008
3.708 | -0.02285
3.809 | -0.00918
3.911 | -0.00426
4.013 | -0.00896
4.114 | -0.00762
4.216 | -0.00112
4.317 | -0.00246
4.42 | -0.00269
4.521 | -0.00739
4.622 | -0.00448
4.725 | 0.0047
4.826 | 0.00762
4.928 | 0.01322
5.029 | 0.00963
5.131 | 0.00493
5.233 | -0.02598
5.334 | -0.01277
5.436 | -0.00739
5.538 | -0.0047
5.639 | -0.00381
5.741 | 0.00269
5.843 | -0.01478
5.944 | -0.03046
6.046 | -0.01299
6.148 | -0.00134
6.249 | -0.00582
6.351 | -0.02285
6.452 | -0.01389
6.555 | -0.00112
6.656 | 0.0103
6.757 | 0.01434
6.86 | 0.00134
6.961 | 0.00739
7.063 | 0.00784
7.164 | -0.00179
7.266 | -0.00381
7.368 | -0.00403
7.469 | -0.00493
7.571 | -0.0121
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
