Triyanpal/HYROE/Testing_Analyses/Testing-2023/hrmts_force_output_17_08_03.xlsx

Remove weights from scale
Tare complete - starting measurement in 3 s
0.86 | 0.01165
0.962 | 0.0065
1.064 | 0.00717
1.165 | 0.01254
1.267 | 0.00874
1.369 | 0.02822
1.47 | 0.01926
1.572 | 0.01971
1.673 | 0.00986
1.776 | 0.00067
1.877 | -0.0065
1.978 | -0.00022
2.081 | -0.00179
2.182 | 0.01904
2.284 | 0.03741
2.385 | 0.02957
2.487 | 0.02173
2.589 | 0.00538
2.69 | 0.00851
2.792 | 0.01882
2.894 | 0.00515
2.995 | 0.00874
3.097 | 0.00246
3.199 | 0.00314
3.3 | 0.02554
3.402 | 0.0383
3.504 | 0.04234
3.606 | 0.04861
3.707 | 0.05891
3.808 | 0.03718
3.911 | 0.02531
4.012 | 0.01389
4.113 | 0.00762
4.216 | 0.01299
4.317 | -0.0009
4.419 | -0.01478
4.52 | -0.00986
4.622 | 0.00269
4.724 | 0.00739
4.825 | 0.03629
4.928 | 0.0289
5.029 | 0.01814
5.13 | 0.02083
5.232 | 0.00918
5.334 | 0.01187
5.435 | 0.00829
5.537 | 0.00448
5.639 | 0.00717
5.741 | 0.0009
5.842 | 0.00918
5.943 | 0.0215
6.046 | 0.01882
6.147 | 0.01389
6.248 | 0.0159
6.35 | 0.02845
6.452 | 0.03136
6.554 | 0.0271
6.655 | 0.00381
6.757 | -0.00336
6.859 | 0.01299
6.96 | 0.02464
7.063 | 0.01322
7.164 | 0.01456
7.265 | 0.01859
7.367 | 0.02106
7.469 | 0.02307
7.57 | 0.00941
7.672 | 0.00672
7.774 | 0.02285
7.876 | 0.0439
7.977 | 0.02083
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
