Triyanpal/HYROE/Testing_Analyses/Testing-2023/test firing readings.xlsx

 | Test 1 | Test 2 | 0.39 | 9.71936
0.01 | 0.504 | 0.03114 | 0.4 | 9.81008
0.02 | 0.57434 | 0.18682 | 0.41 | 9.85981
0.03 | 0.63011 | 0.34653 | 0.42 | 9.87213
0.04 | 0.71478 | 0.53469 | 0.43 | 9.86832
0.05 | 0.82208 | 0.71053 | 0.44 | 9.89094
0.06 | 0.92915 | 0.88838 | 0.45 | 9.93104
0.07 | 1.02234 | 1.07408 | 0.46 | 9.94762
0.08 | 1.12694 | 1.23066 | 0.47 | 9.96509
0.09 | 1.28374 | 1.39731 | 0.48 | 9.98547
0.1 | 1.46608 | 1.57293 | 0.49 | 9.97696
0.11 | 1.67149 | 1.71853 | 0.5 | 9.98323
0.12 | 1.90333 | 2.01421 | 0.51 | 10.60237
0.13 | 2.18736 | 2.11568 | 0.52 | 18.54384
0.14 | 2.5321 | 2.25658 | 0.53 | 41.68707
0.15 | 2.94269 | 2.36253 | 0.54 | 60.66995
0.16 | 3.3824 | 2.45482 | 0.55 | 69.1282
0.17 | 3.88192 | 2.54195 | 0.56 | 81.45514
0.18 | 4.39734 | 2.61296 | 0.57 | 116.57566
0.19 | 4.88029 | 2.69763 | 0.58 | 146.70364
0.2 | 5.77338 | 2.76774 | 0.59 | 158.81578
0.21 | 6.16134 | 2.85242 | 0.6 | 166.58633
0.22 | 6.62726 | 2.93328 | 0.61 | 179.33888
0.23 | 7.056 | 2.9895 | 0.62 | 185.76141
0.24 | 7.42963 | 3.04259 | 0.63 | 190.71069
0.25 | 7.77347 | 3.0921 | 0.64 | 194.8679
0.26 | 8.0855 | 3.1631 | 0.65 | 199.38598
0.27 | 8.36058 | 3.24486 | 0.66 | 204.34042
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
