Triyanpal/HYROE/Testing_Analyses/Testing-2024/r2s testing data.xlsx

Sheet: raw 1
Channel: THRUST_STAND_LC1_CALIBRATED |  | Channel: R2S_PT_1
Time | Data | Time | Data
114.69 | -0.08522509471 | 114.69 | 0.5744013002 | 122.4091801
114.7 | -0.9089133481 | 114.7 | 0.8770106722
114.72 | 2.517198518 | 114.71 | 1.432624595
114.73 | 5.867788366 | 114.72 | 2.142636609
114.74 | 14.098963 | 114.73 | 2.816604704
114.75 | 28.81025375 | 114.74 | 3.528204541
114.76 | 37.44033996 | 114.75 | 4.356305143
114.77 | 37.4667656 | 114.76 | 5.159679031
114.79 | 65.17269697 | 114.77 | 5.881339541
114.8 | 82.58694062 | 114.78 | 6.51129918
114.81 | 87.80251815 | 114.79 | 7.027572065
114.82 | 89.56439161 | 114.8 | 7.47825346
114.83 | 90.47316671 | 114.81 | 7.915647715
114.84 | 90.56049326 | 114.82 | 8.29993909
114.86 | 92.27859603 | 114.83 | 8.646785261
114.87 | 94.22317634 | 114.84 | 8.988457549
114.88 | 103.662954 | 114.85 | 9.317793217
114.89 | 120.0743336 | 114.86 | 9.628352437
114.9 | 126.2302192 | 114.87 | 9.936753602
114.91 | 131.8072553 | 114.88 | 10.23811541
114.92 | 138.8672817 | 114.89 | 10.5365396
114.93 | 133.5713516 | 114.9 | 10.83752921
114.94 | 129.3020015 | 114.91 | 11.13297611
114.95 | 133.631602 | 114.92 | 11.41980345
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
