Triyanpal/HYROE/Images/Design/2024_testing_simulation_velociuty_profile.png

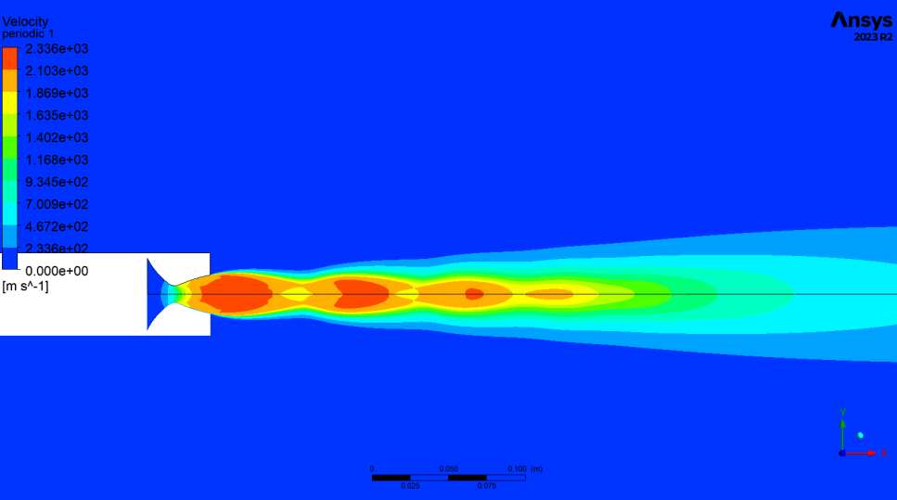
Images/Design/2024_testing_simulation_velociuty_profile.png
