Triyanpal/HYROE/Images/Testing/correlation.png

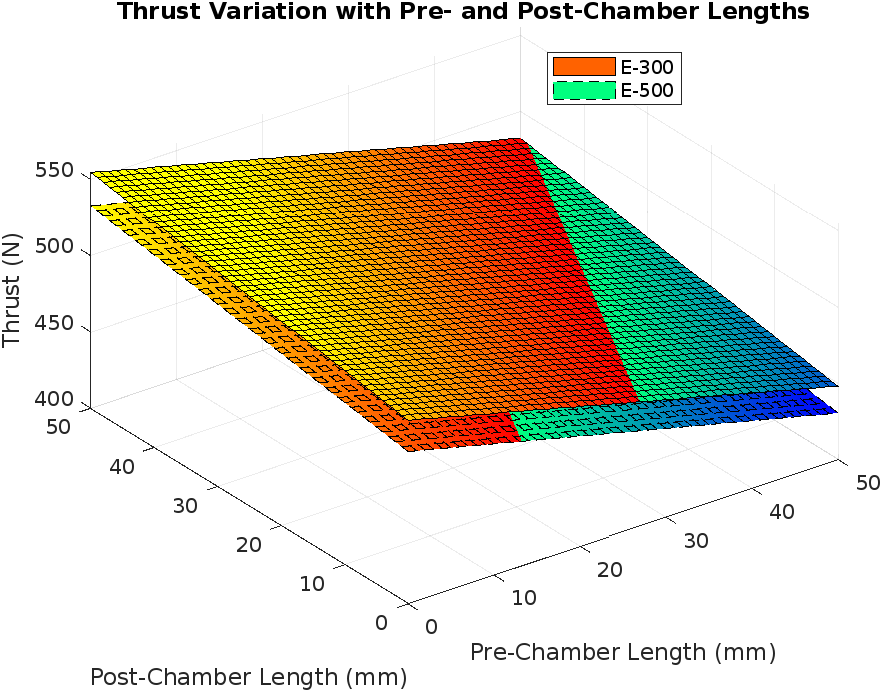
Images/Testing/correlation.png
