Triyanpal/HYROE/Images/Testing/normalisation.png

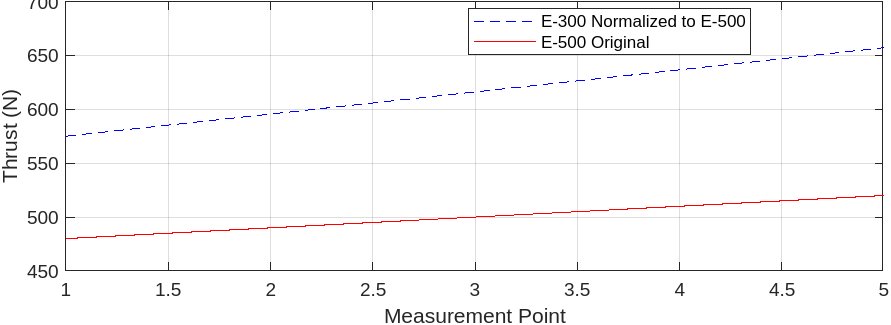
Images/Testing/normalisation.png
