Triyanpal/HYROE/Images/Testing/Picture13.png

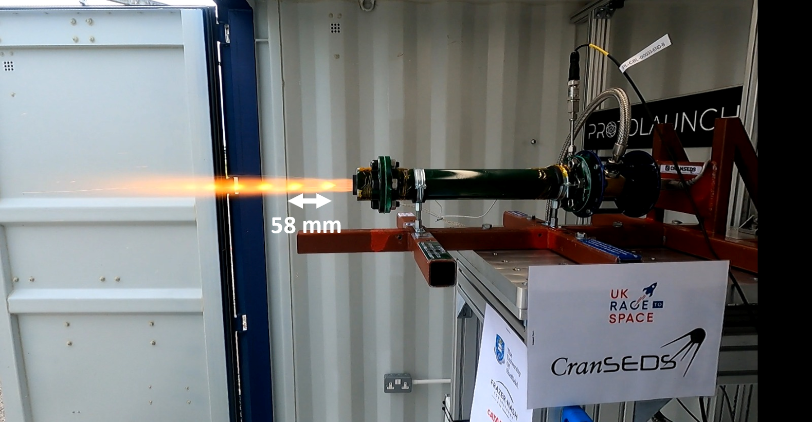
Images/Testing/Picture13.png
