Triyanpal/HYROE/Images/Testing/Picture15.png

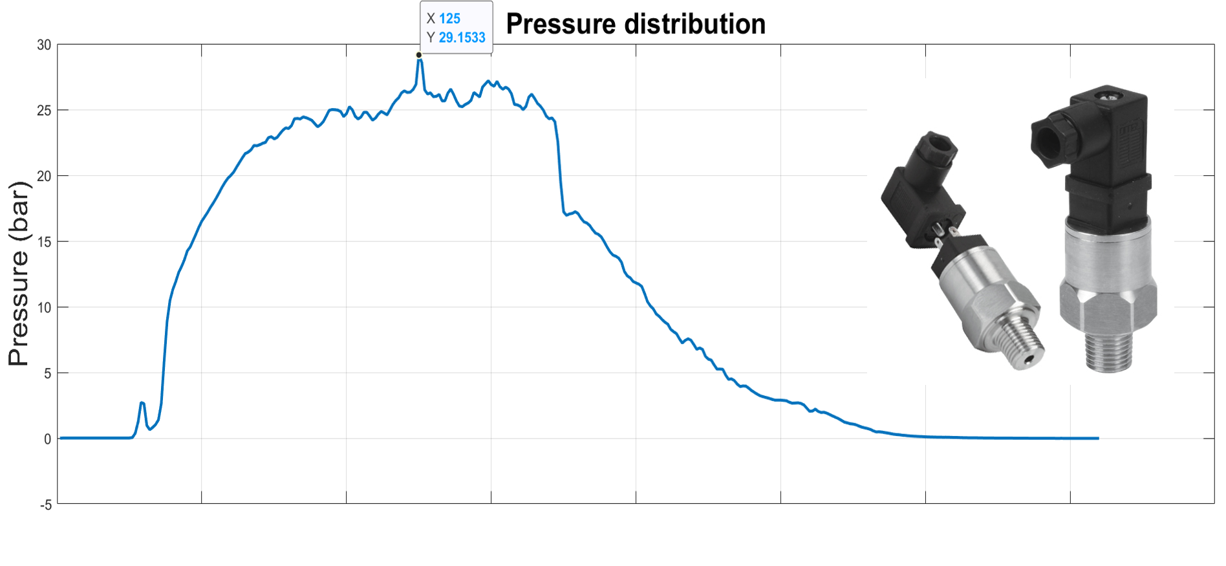
Images/Testing/Picture15.png
