Triyanpal/HYROE/Images/Testing/Picture16.png

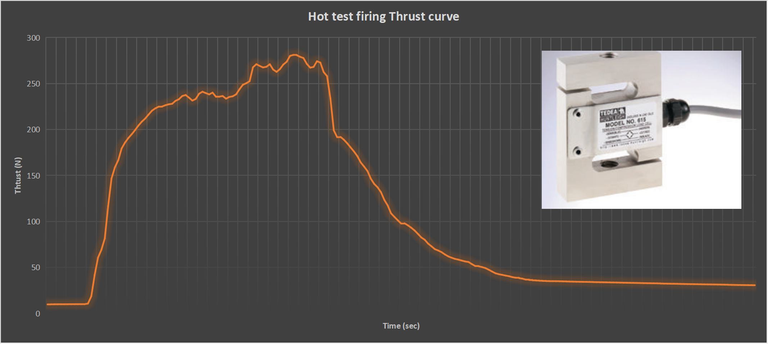
Images/Testing/Picture16.png
