Triyanpal/HYROE/Images/Testing/thrust_output_2024.png

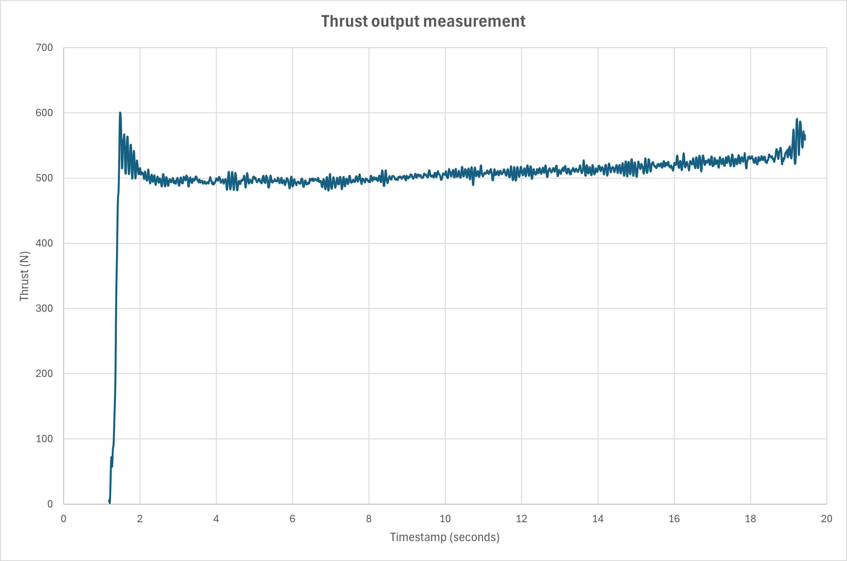
Images/Testing/thrust_output_2024.png
