Triyanpal/HYROE/Resources/3.txt_THRUST_STAND_LC1_CALIBRATED.png

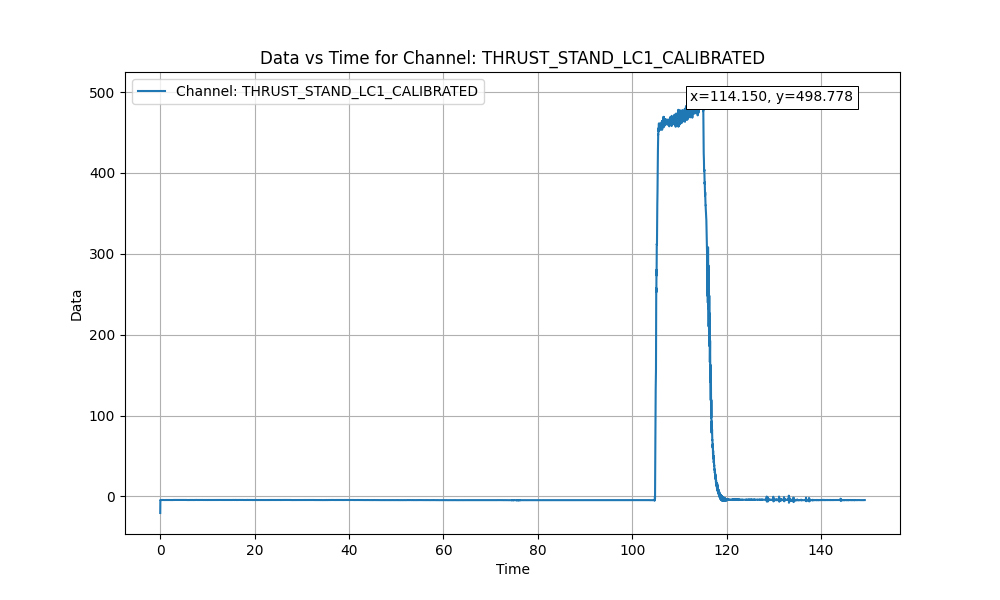
Resources/3.txt_THRUST_STAND_LC1_CALIBRATED.png
