Triyanpal/HYROE/Testing_Analyses/Testing-2023/extracted_data3.txt_CRANFIELD_PT_1.png

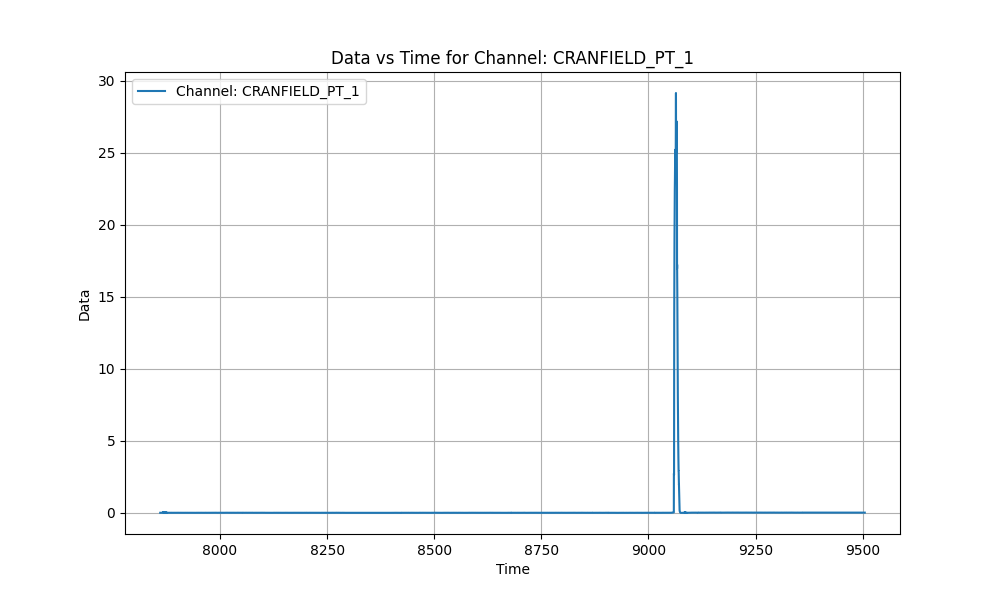
Testing_Analyses/Testing-2023/extracted_data3.txt_CRANFIELD_PT_1.png
