Triyanpal/HYROE/Testing_Analyses/Testing-2023/extracted_data3.txt_NITROUS_PT_2.png

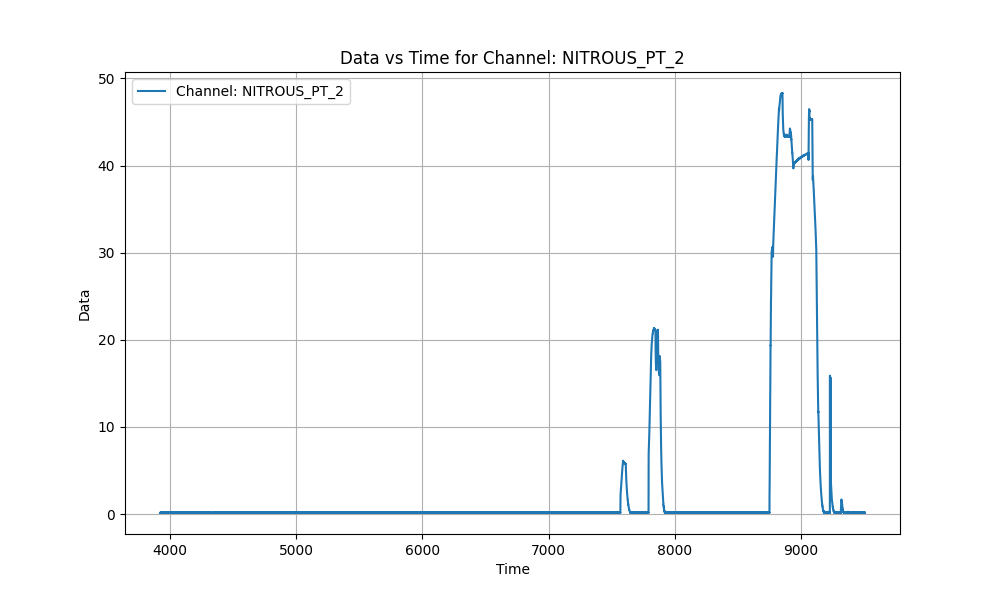
Testing_Analyses/Testing-2023/extracted_data3.txt_NITROUS_PT_2.png
