Triyanpal/HYROE/Testing_Analyses/Testing-2023/extracted_data3.txt_NITROUS_TT_2.png

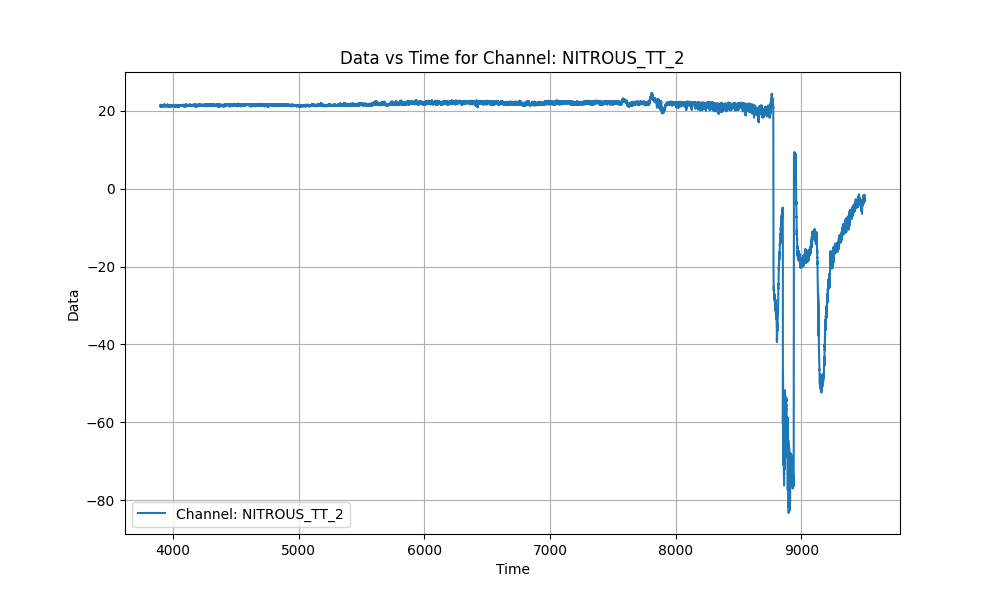
Testing_Analyses/Testing-2023/extracted_data3.txt_NITROUS_TT_2.png
