Triyanpal/HYROE/Testing_Analyses/Testing-2023/extracted_data3.txt_NITROUS_VIRT_LC_TANK_MASS.png

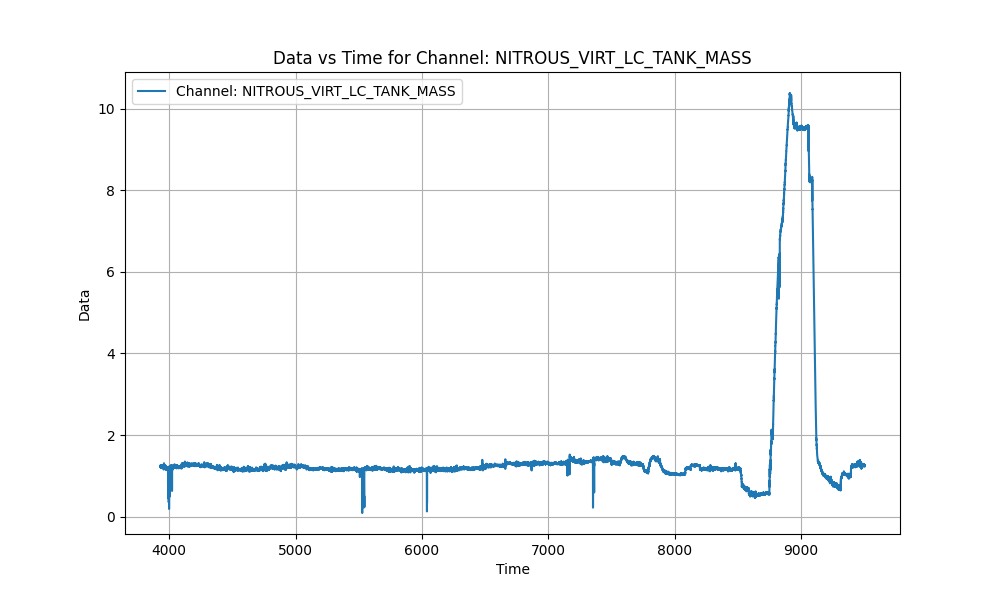
Testing_Analyses/Testing-2023/extracted_data3.txt_NITROUS_VIRT_LC_TANK_MASS.png
