Triyanpal/HYROE/Testing_Analyses/Testing-2023/extracted_data3.txt_THRUST_STAND_LC1.png

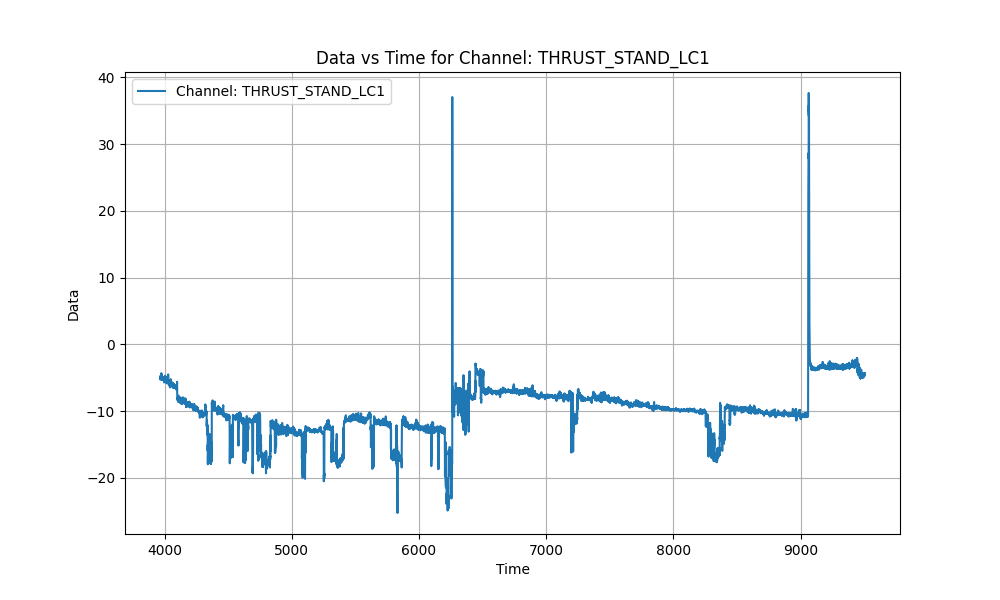
Testing_Analyses/Testing-2023/extracted_data3.txt_THRUST_STAND_LC1.png
