Triyanpal/HYROE/Testing_Analyses/Testing-2023/Pressure.png

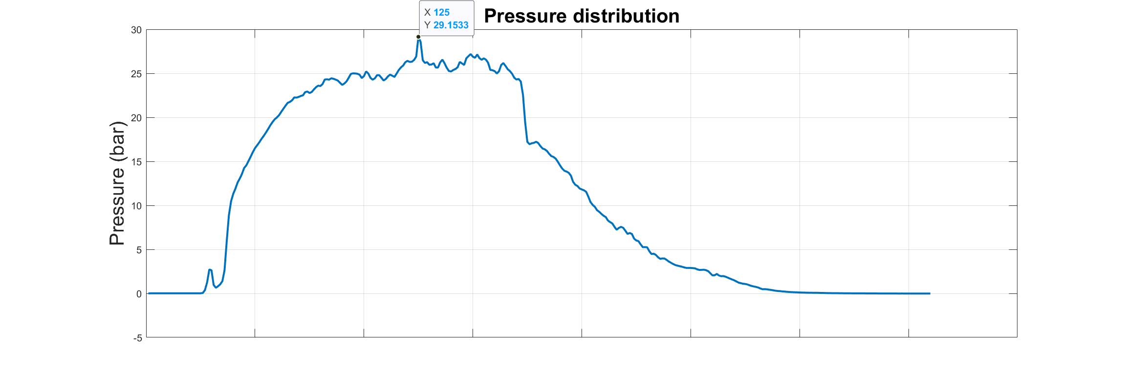
Testing_Analyses/Testing-2023/Pressure.png
