Triyanpal/HYROE/Testing_Analyses/Testing-2023/Thrust.png

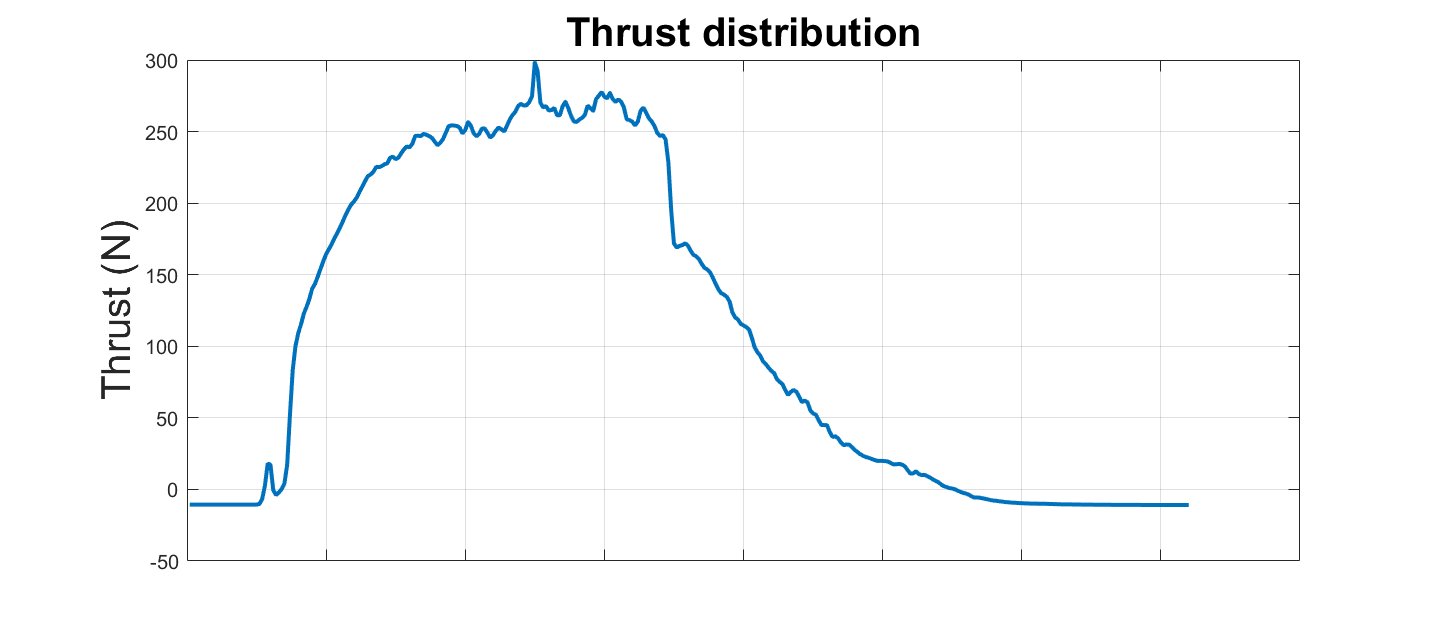
Testing_Analyses/Testing-2023/Thrust.png
