Triyanpal/HYROE/Drawings/flange_test.pdf

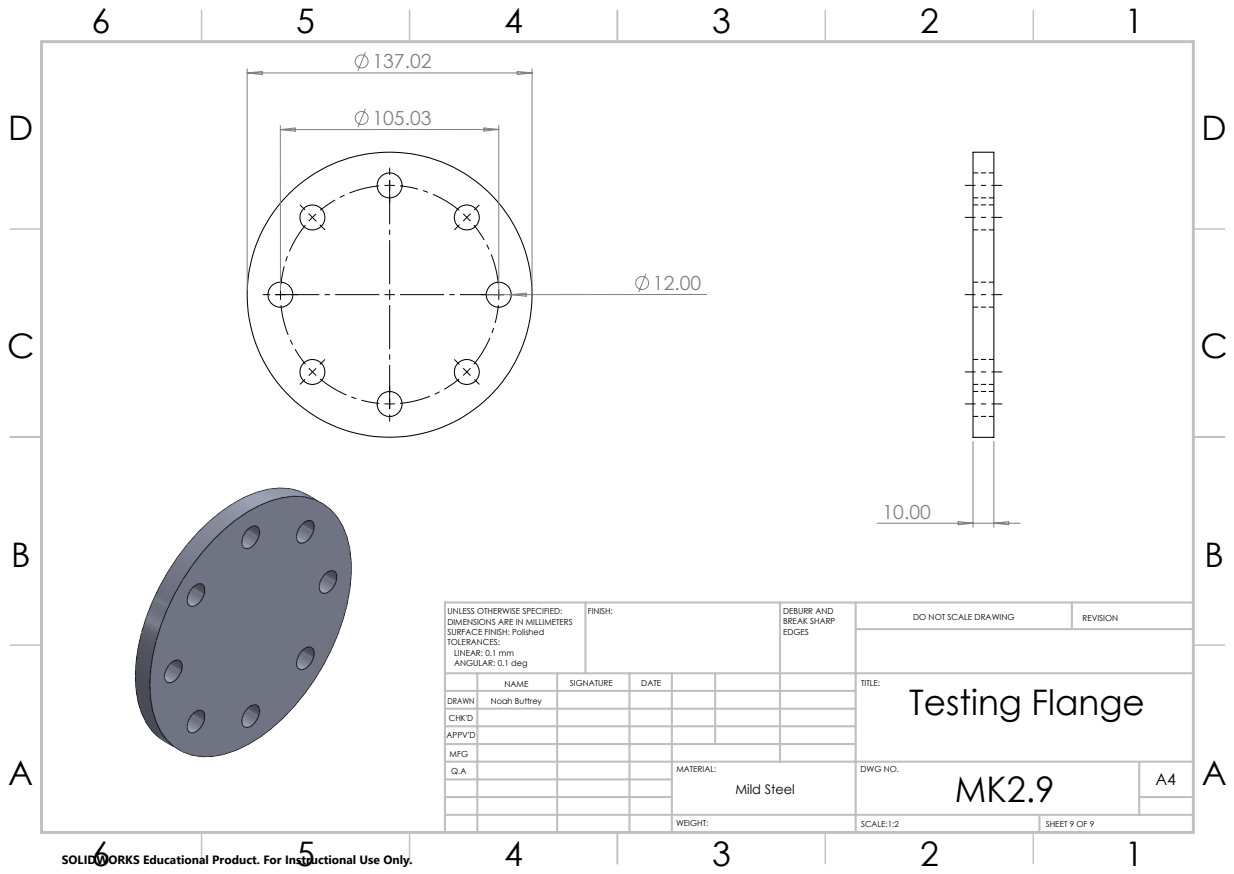
[picture p133: page 1]
FINISH:; DEBURR AND; BREAK SHARP; DO NOT SCALE DRAWING; REVISION; SCALE:1:2; SHEET 9 OF 9

UNLESS OTHERWISE SPECIFIED:
DIMENSIONS ARE IN MILLIMETERS
SURFACE FINISH: Polished
TOLERANCES:
LINEAR: 0.1 mm
ANGULAR: 0.1 deg

NAME | SIGNATURE | DATE | | | | TITLE: Testing Flange

DRAWN | Noah Buttrey
CHK'D
APPV'D
MFG
Q.A | | | | MATERIAL: | DWG NO. MK2.9 | A4 Mild Steel

SOLIDWORKS Educational Product. For Instructional Use Only.
