Triyanpal/HYROE/Drawings/Assem.pdf

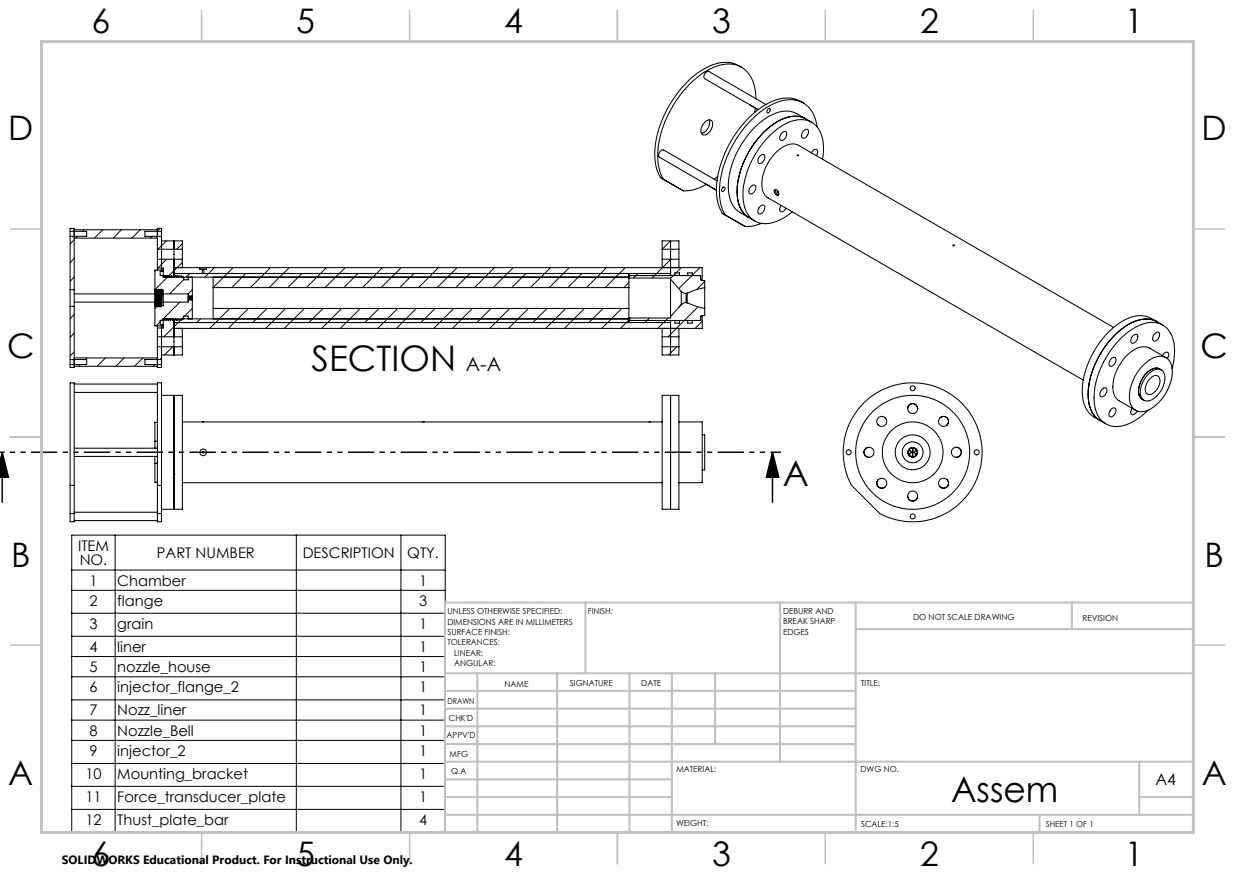
[picture p134: page 1]
SECTION A-A; FINISH:; DEBURR AND; BREAK SHARP; DO NOT SCALE DRAWING; REVISION

ITEM NO. | PART NUMBER | DESCRIPTION | QTY.
1 | Chamber | | 1
2 | flange | | 3
3 | grain | | 1
4 | liner | | 1
5 | nozzle_house | | 1
6 | injector_flange_2 | | 1 | | NAME | SIGNATURE | DATE | | | | TITLE:
7 | Nozz_liner | 1
8 | Nozzle_Bell | 1
9 | injector_2 | | 1
10 | Mounting_bracket | | 1 | Q.A | | | | MATERIAL: | DWG NO. Assem | A4
11 | Force_transducer_plate | 1
12 | Thust_plate_bar | 4

UNLESS OTHERWISE SPECIFIED:
DIMENSIONS ARE IN MILLIMETERS
SURFACE FINISH:
TOLERANCES:
LINEAR:
ANGULAR:

DRAWN
CHK'D
APPV'D
MFG

SOLIDWORKS Educational Product. For Instructional Use Only.

WEIGHT: | SCALE:1:5 | SHEET 1 OF 1
