Triyanpal/HYROE/Drawings/Chamber.pdf

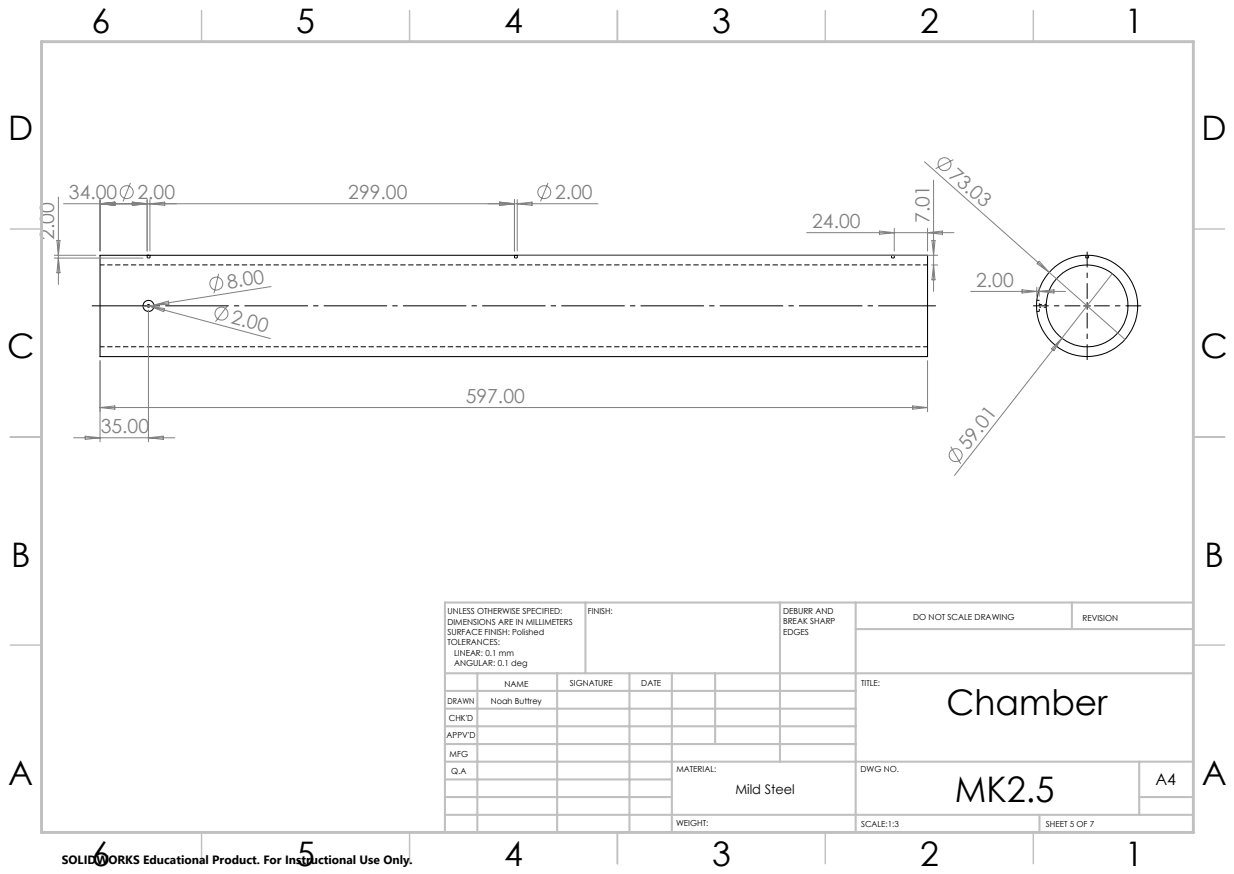
[picture p135: page 1]
FINISH:; DEBURR AND; BREAK SHARP; DO NOT SCALE DRAWING; REVISION; SCALE:1:3; SHEET 5 OF 7

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

NAME | SIGNATURE | DATE | | | | TITLE: Chamber

DRAWN | Noah Buttrey
CHK'D
APPV'D
MFG
Q.A | | | | MATERIAL: | DWG NO. MK2.5 | A4 Mild Steel

SOLIDWORKS Educational Product. For Instructional Use Only.
