Triyanpal/HYROE/Drawings/flange.pdf

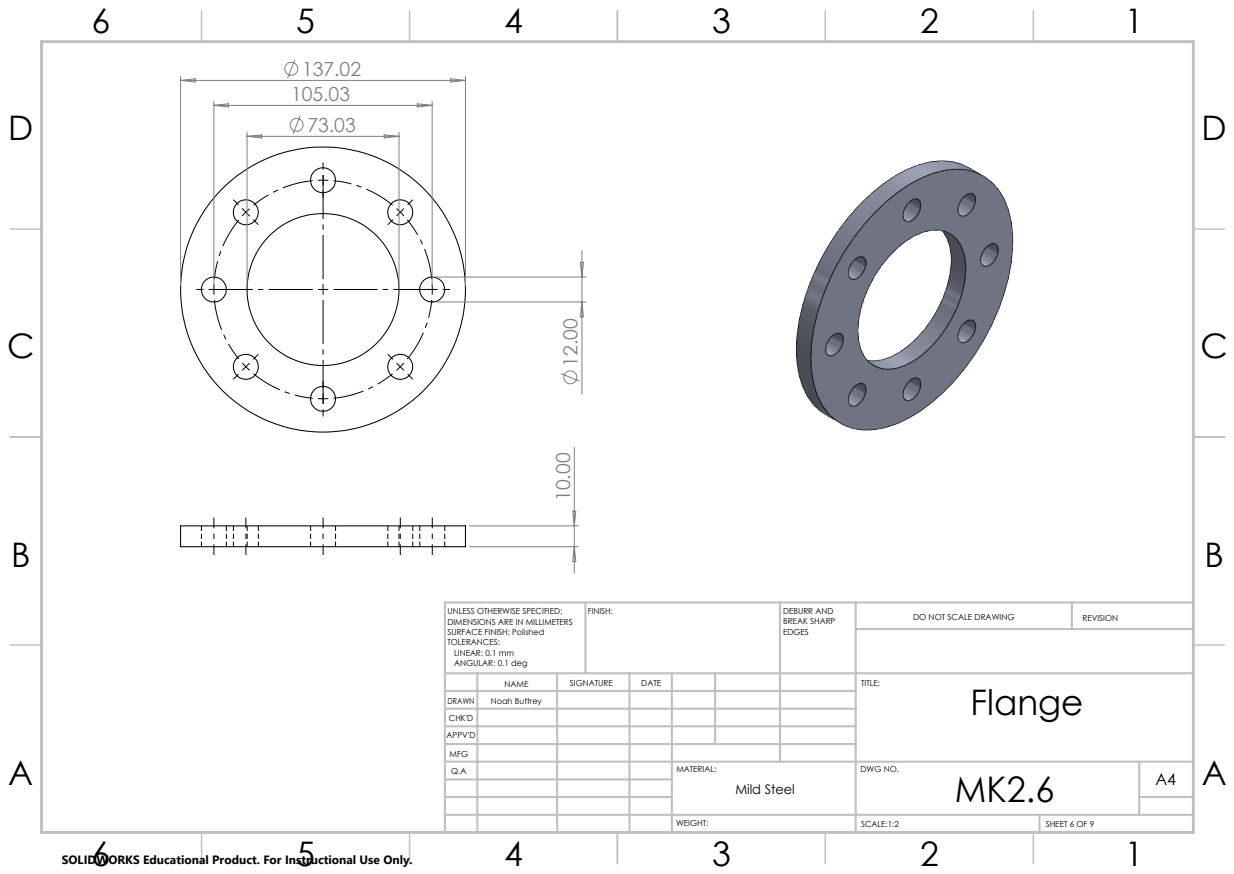
[picture p136: page 1]
FINISH:; DEBURR AND; BREAK SHARP; DO NOT SCALE DRAWING; REVISION; SCALE:1:2; SHEET 6 OF 9

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

NAME | SIGNATURE | DATE | | | | TITLE: Flange

DRAWN | Noah Buttrey
CHK'D
APPV'D
MFG
Q.A | | | | MATERIAL: | DWG NO. MK2.6 | A4 Mild Steel

SOLIDWORKS Educational Product. For Instructional Use Only.
