Triyanpal/HYROE/Drawings/flange_tap.pdf

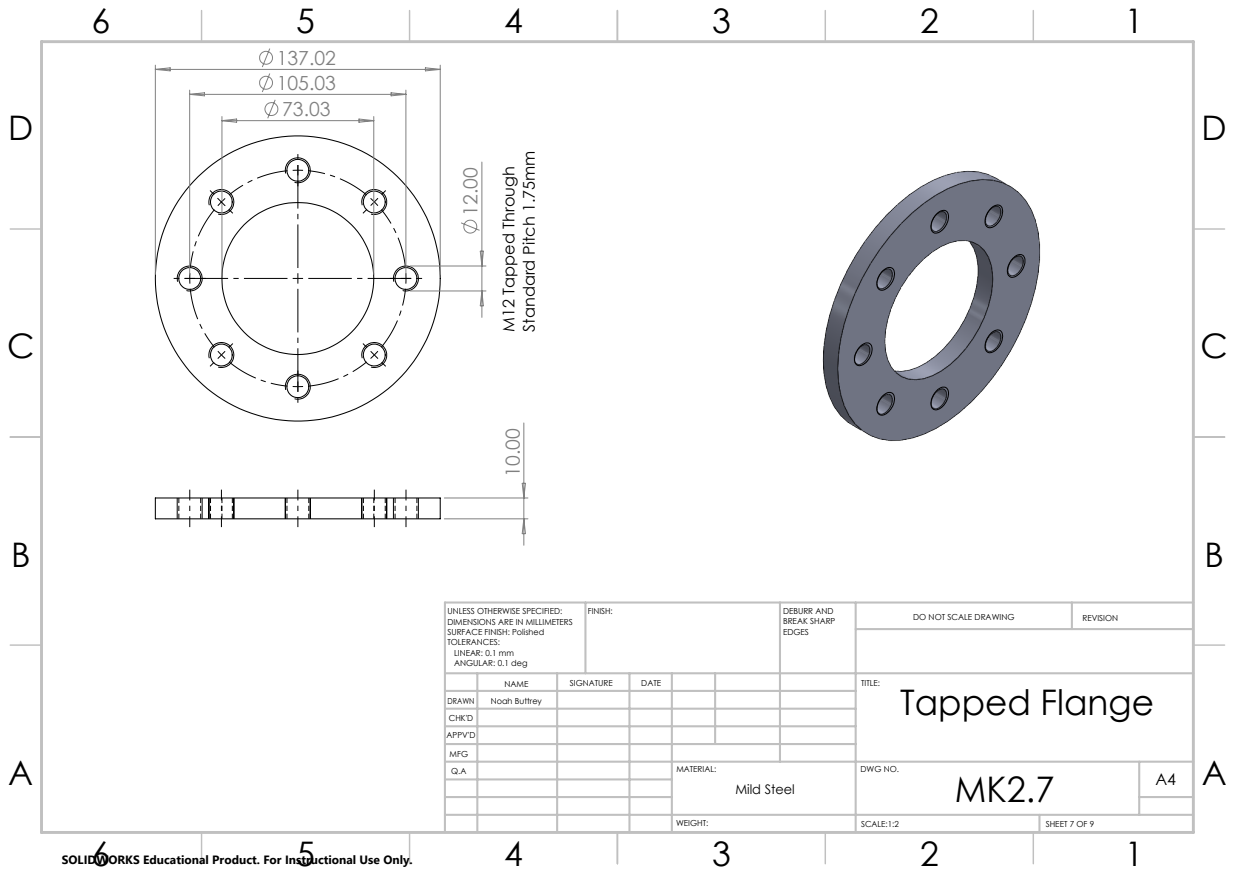
[picture p137: page 1]
10.00 M12 Tapped Through; Standard Pitch 1.75mm; FINISH:; DEBURR AND; BREAK SHARP; DO NOT SCALE DRAWING; REVISION; SCALE:1:2; SHEET 7 OF 9

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

NAME | SIGNATURE | DATE | | | | TITLE: Tapped Flange

DRAWN | Noah Buttrey
CHK'D
APPV'D
MFG
Q.A | | | | MATERIAL: | DWG NO. MK2.7 | A4 Mild Steel

SOLIDWORKS Educational Product. For Instructional Use Only.
