Triyanpal/HYROE/Drawings/Force_transducer_plate.pdf

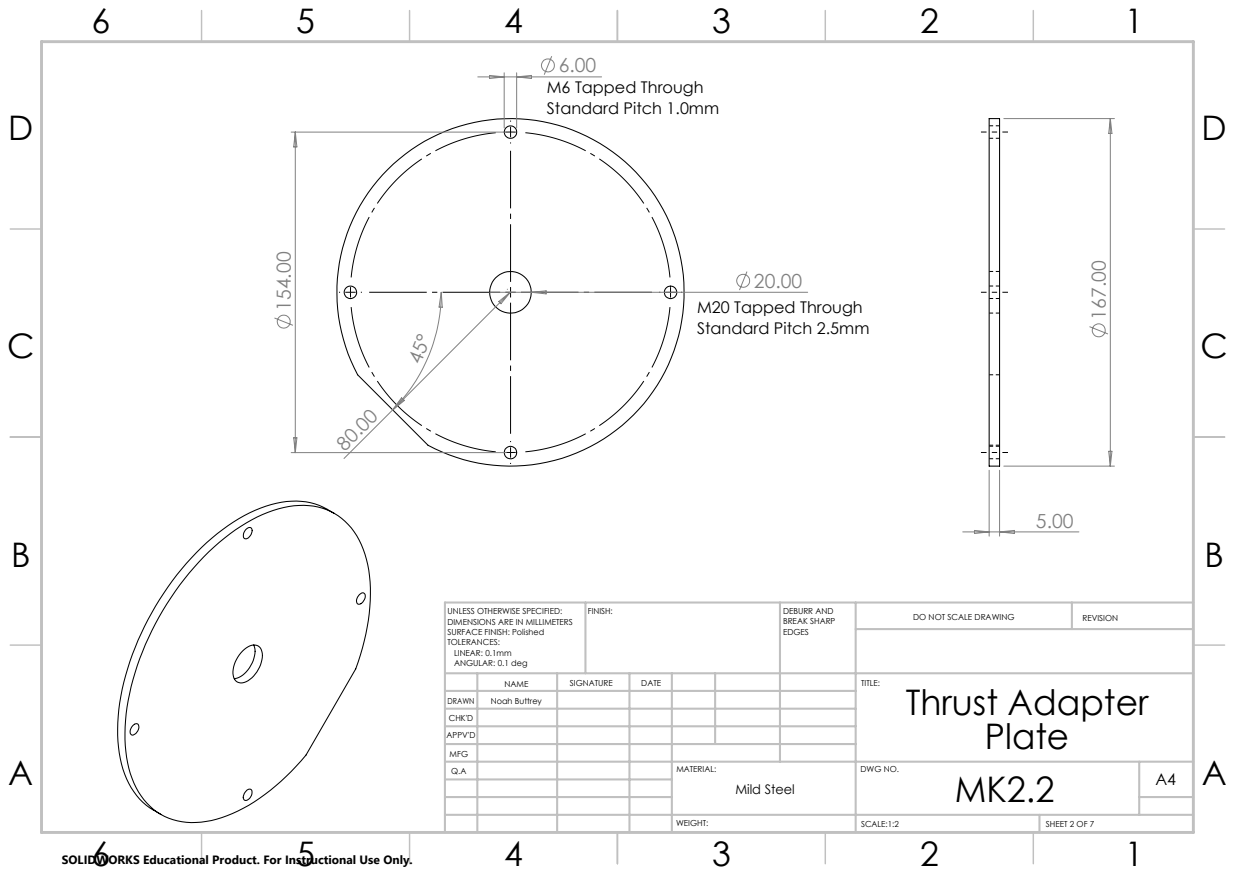
[picture p138: page 1]
M6 Tapped Through Standard Pitch 1.0mm; M20 Tapped Through Standard Pitch 2.5mm; FINISH:; DEBURR AND; BREAK SHARP; DO NOT SCALE DRAWING; REVISION; SCALE:1:2; SHEET 2 OF 7

UNLESS OTHERWISE SPECIFIED:
DIMENSIONS ARE IN MILLIMETERS
SURFACE FINISH: Polished
TOLERANCES:
LINEAR: 0.1mm
ANGULAR: 0.1 deg

NAME | SIGNATURE | DATE | | | | TITLE: Thrust Adapter Plate

DRAWN | Noah Buttrey
CHK'D
APPV'D
MFG
Q.A | | | | MATERIAL: | DWG NO. MK2.2 | A4 Mild Steel

SOLIDWORKS Educational Product. For Instructional Use Only.
