Triyanpal/HYROE/Drawings/injector_2.pdf

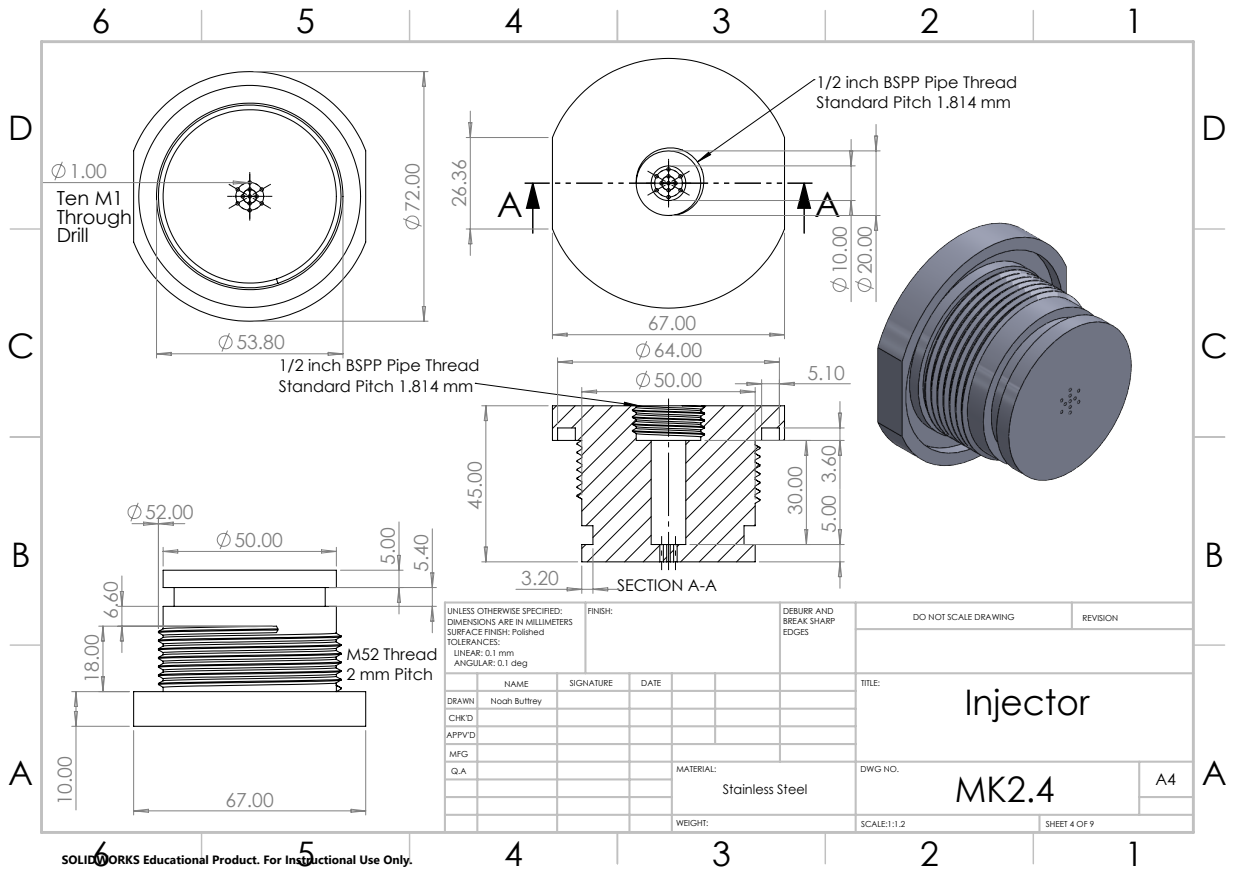
[picture p139: page 1]
M52 Thread 2 mm Pitch; SECTION A-A; Ten M1; FINISH:; DEBURR AND; BREAK SHARP; DO NOT SCALE DRAWING; REVISION; SCALE:1:1.2; SHEET 4 OF 9

1/2 inch BSPP Pipe Thread
Standard Pitch 1.814 mm

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

NAME | SIGNATURE | DATE | | | | TITLE: Injector

DRAWN | Noah Buttrey
CHK'D
APPV'D
MFG
Q.A | | | | MATERIAL: | DWG NO. MK2.4 | A4 Stainless Steel

SOLIDWORKS Educational Product. For Instructional Use Only.
