Triyanpal/HYROE/Drawings/injector_flange_2.pdf

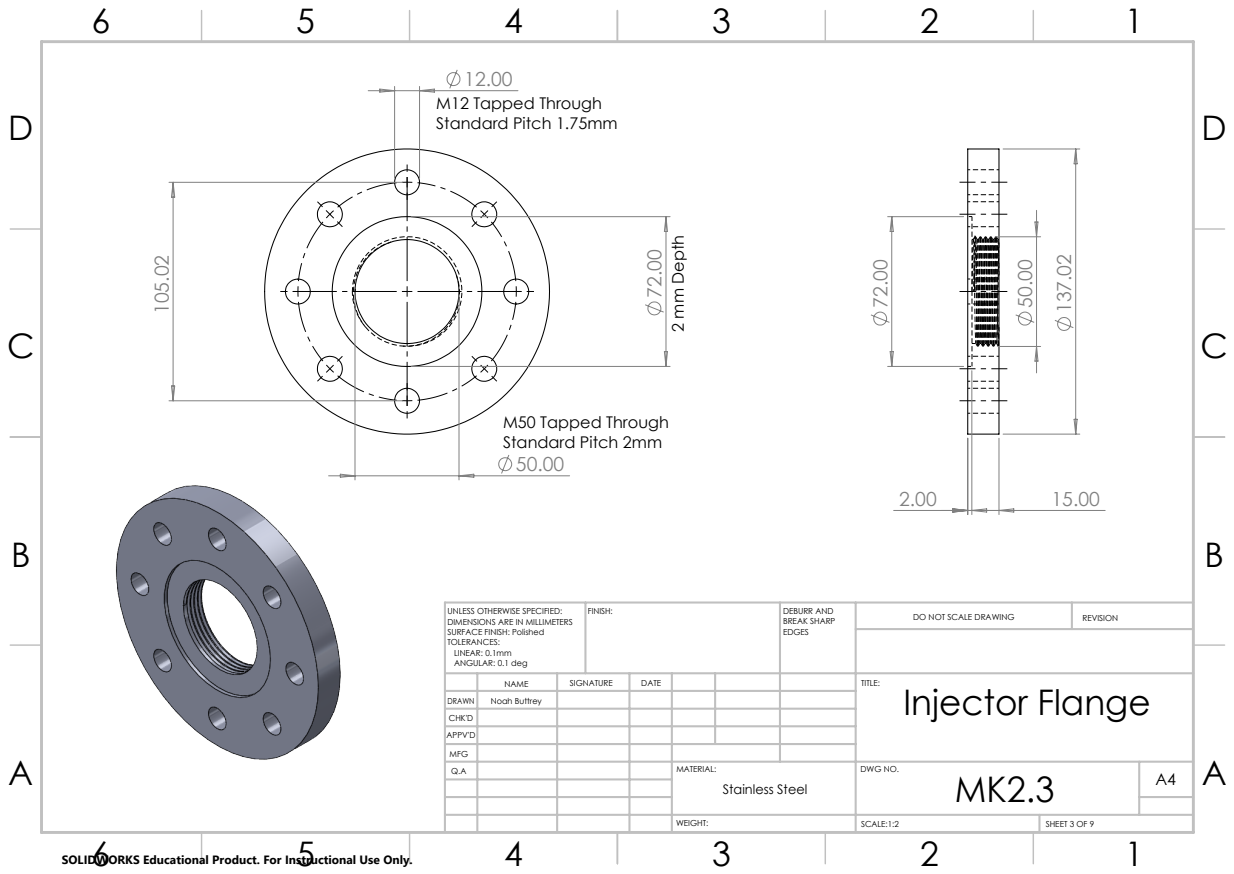
[picture p140: page 1]
M12 Tapped Through Standard Pitch 1.75mm; M50 Tapped Through Standard Pitch 2mm; 2 mm Depth; FINISH:; DEBURR AND; BREAK SHARP; DO NOT SCALE DRAWING; REVISION; SCALE:1:2; SHEET 3 OF 9

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

NAME | SIGNATURE | DATE | | | | TITLE: Injector Flange

DRAWN | Noah Buttrey
CHK'D
APPV'D
MFG
Q.A | | | | MATERIAL: | DWG NO. MK2.3 | A4 Stainless Steel

SOLIDWORKS Educational Product. For Instructional Use Only.
