Triyanpal/HYROE/Drawings/Mounting_bracket.pdf

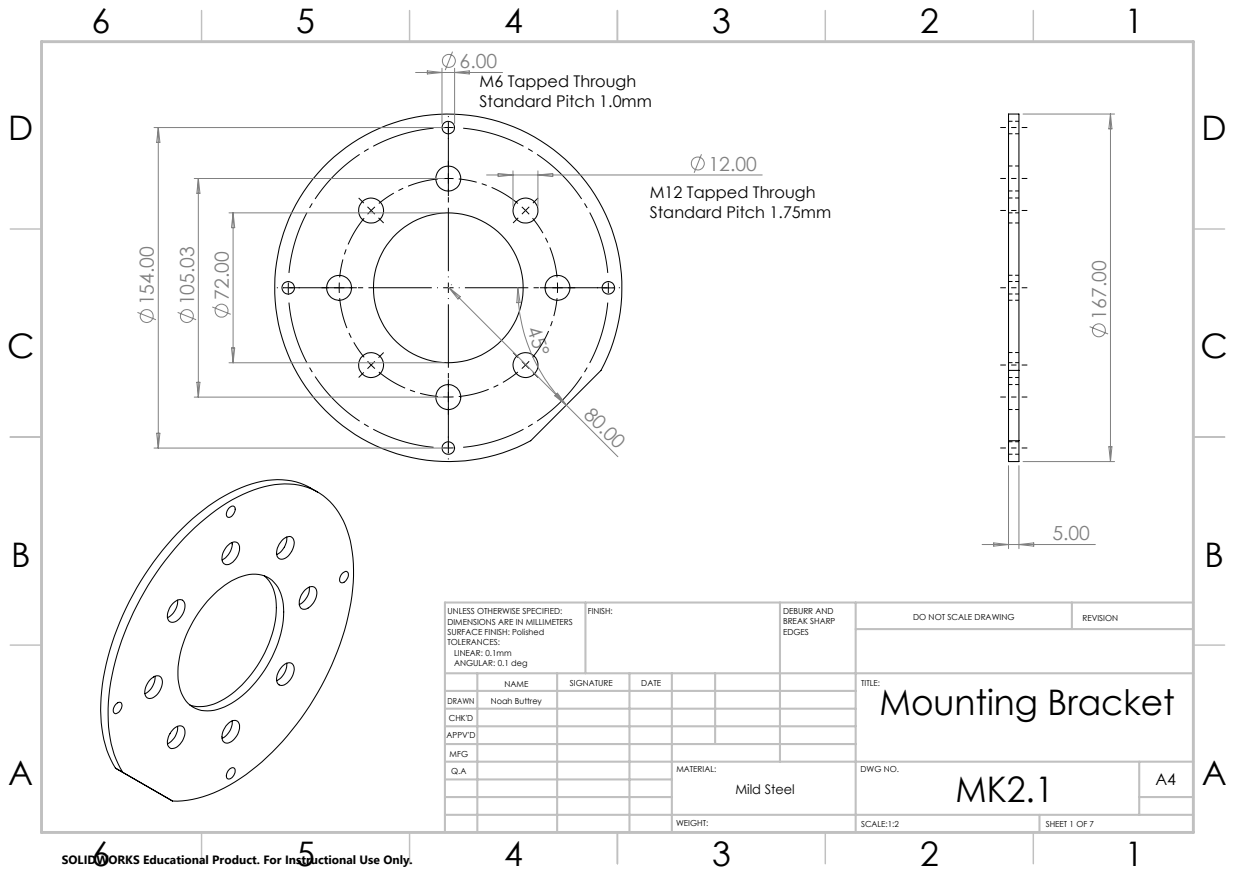
[picture p141: page 1]
M6 Tapped Through Standard Pitch 1.0mm; M12 Tapped Through Standard Pitch 1.75mm; FINISH:; DEBURR AND; BREAK SHARP; DO NOT SCALE DRAWING; REVISION; SCALE:1:2; SHEET 1 OF 7

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

NAME | SIGNATURE | DATE | | | | TITLE: Mounting Bracket

DRAWN | Noah Buttrey
CHK'D
APPV'D
MFG
Q.A | | | | MATERIAL: | DWG NO. MK2.1 | A4 Mild Steel

SOLIDWORKS Educational Product. For Instructional Use Only.
