Triyanpal/HYROE/Drawings/nozzle_house.pdf

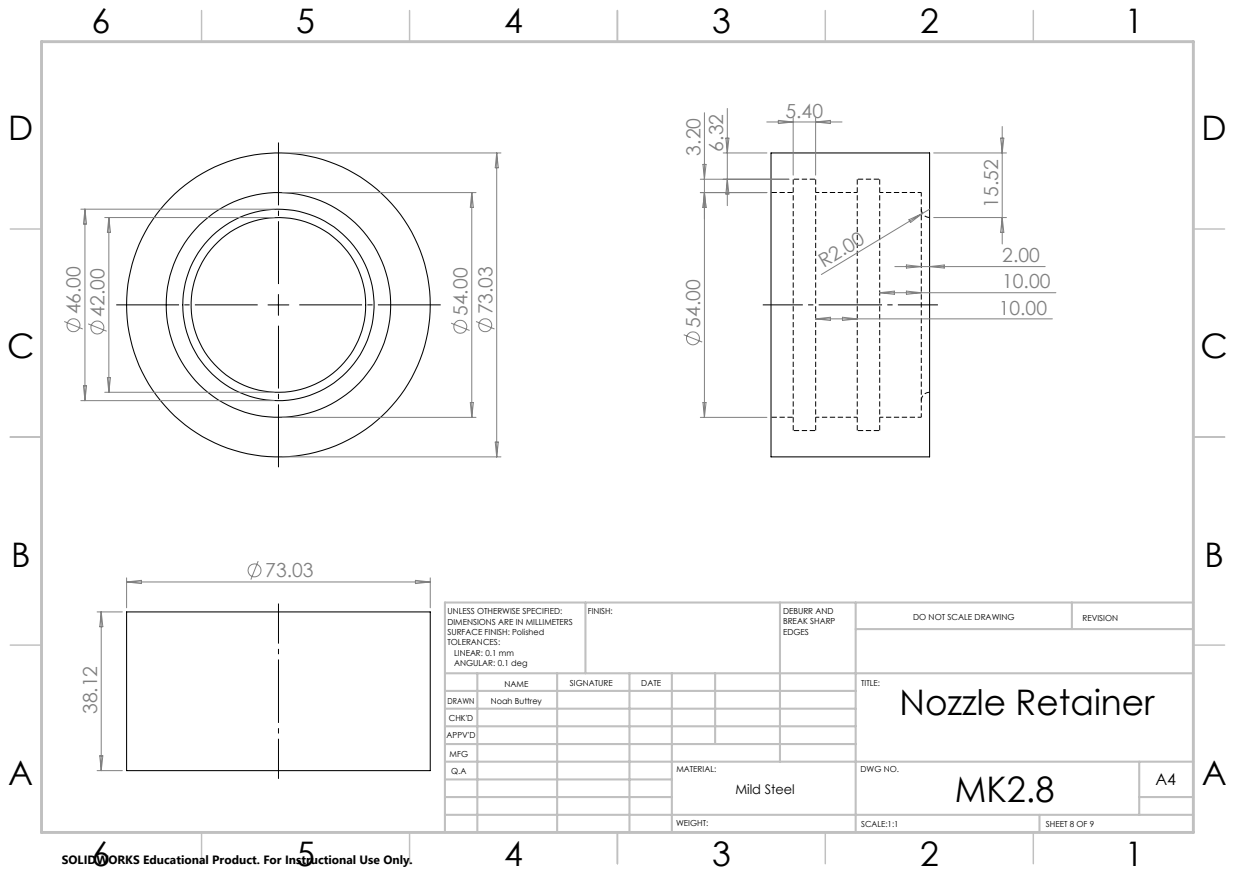
[picture p142: page 1]
FINISH:; DEBURR AND; BREAK SHARP; DO NOT SCALE DRAWING; REVISION; SCALE:1:1; SHEET 8 OF 9

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

SOLIDWORKS Educational Product. For Instructional Use Only.

NAME | SIGNATURE | DATE | | | | TITLE: Nozzle Retainer

DRAWN | Noah Buttrey
CHK'D
APPV'D
MFG
Q.A | | | | MATERIAL: | DWG NO. MK2.8 | A4 Mild Steel
