Triyanpal/HYROE/(list of files, drawings)

Other design files:
Testing_Analyses/DAQ/load cell schematic.fzz
